Yangjie-SUSTC/Large_FOV_withDM/README.md

# Large_FOV_withDM
## This project used in STROM for large and DM for aberration correctoin. all drawings are in ./factorys.
Large_FOV.sldam whose base board have full holes and all size arew rely on it
Large_FOV.sldam remove no need holes on base board and just assemble check
