Yangjie-SUSTC/Large_FOV_withDM/factory/修改/返厂V1.1/修改说明.txt

所有零件4mm定位销扩孔，按照寄过来的定位销紧密配合

LFOV-DM-5
内孔径扩大到40.2

LFOV-DM-7
图纸错误，重做，后缘突出6mm

LFOV-DM-9
内孔径扩大到51

LFOV-DM-11：
1. 底板边缘切除 
2. 底板边缘螺孔毛刺

LFOV-DM-13
M4螺纹孔打穿

FOV-DM-16：
图纸错误,原先M4通孔扩孔为M6

FOV-DM-20
图纸错误, 原先M4通孔4.5mm 扩孔为M6通孔6.6mm

多出的一个件麻烦将其螺纹改成SM1
