Yangjie-SUSTC/Large_FOV_withDM/factory/南科大20211108/说明.txt

1. 18 号零件：18_2inch_mag_sta_zh 不做
2. 数量与氧化按照图纸说明
3. 定位销孔位置与大小尽量保证精确，零件水平面保证水平
