Yangjie-SUSTC/Large_FOV_withDM/factory/pdf/cover.docx

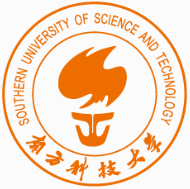
[picture p9: figure]
学校标识- 南方科技大学
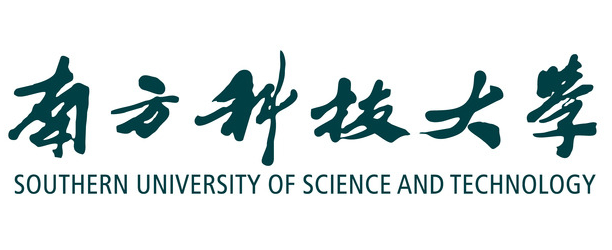
[picture p10: figure]
南方科技大学

LFOV-DM-STORM图纸集

杨杰

yangj3@mail.sustech.edu.cn

https://github.com/Yangjie-SUSTC/Large_FOV_withDM

2021/11/08
