Yangjie-SUSTC/Large_FOV_withDM/assemble/40cm_mir.SLDASM

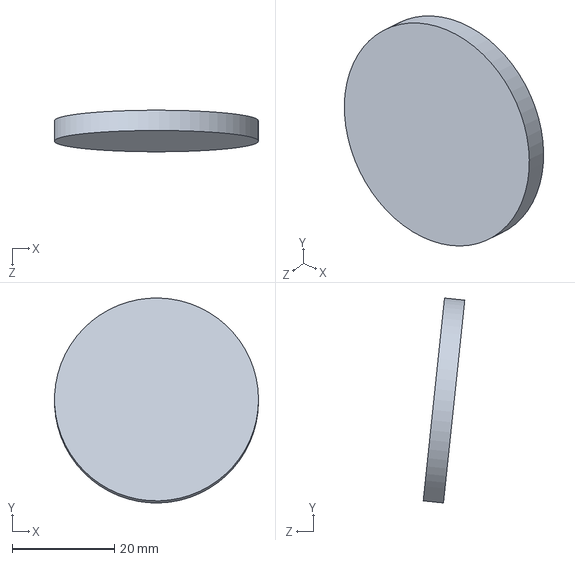
[picture p11: CAD file, 2021-11-23]
assemble/40cm_mir.SLDASM
40.0 x 40.2 x 8.16 mm
