Yangjie-SUSTC/Large_FOV_withDM/commercial/40mir_HVM-s1i.SLDASM

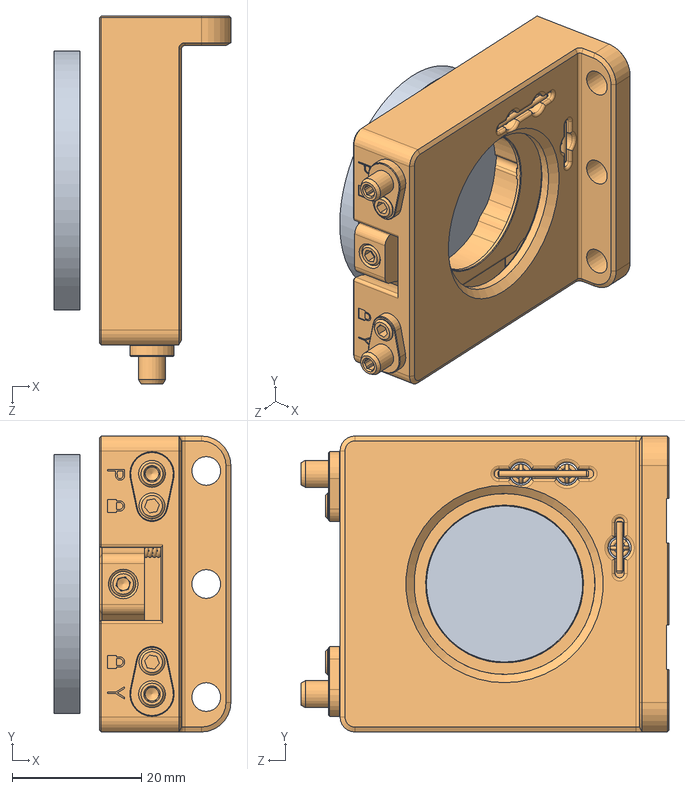
[picture p12: CAD file, 2021-11-23]
commercial/40mir_HVM-s1i.SLDASM
27.3 x 45.7 x 56.8 mm
复件 DHC_GCC-101104^40mir_HVM-s1i
复件 hvm-s1i^40mir_HVM-s1i
