Yangjie-SUSTC/Large_FOV_withDM/assemble/tube_lens_foc.SLDASM

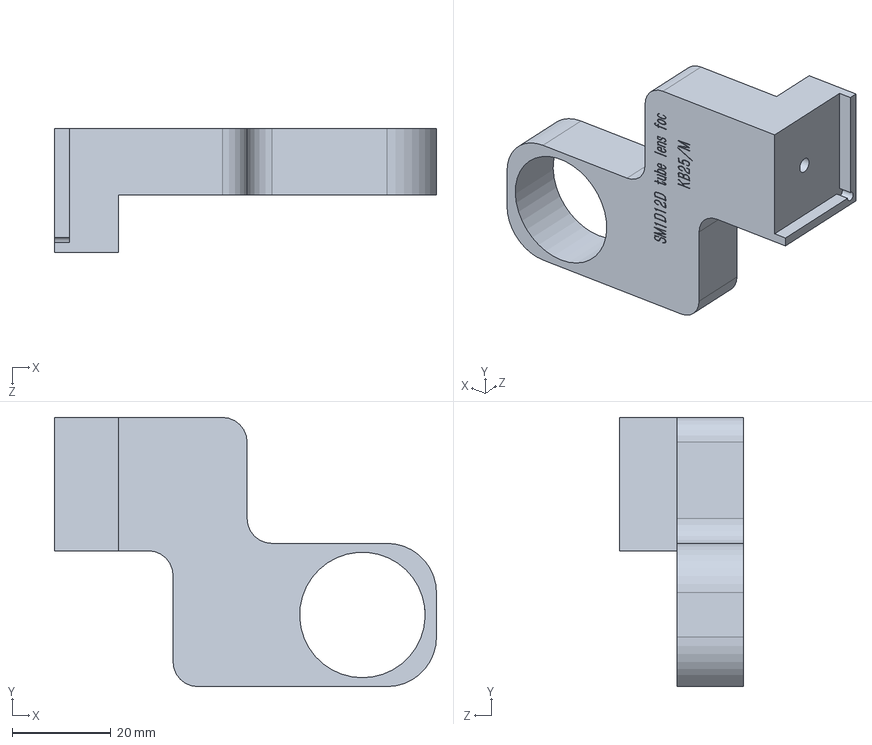
[picture p13: CAD file, 2021-11-11]
assemble/tube_lens_foc.SLDASM
77.3 x 54.5 x 25.1 mm
