Yangjie-SUSTC/Large_FOV_withDM/commercial/cam+carier_cen.SLDASM

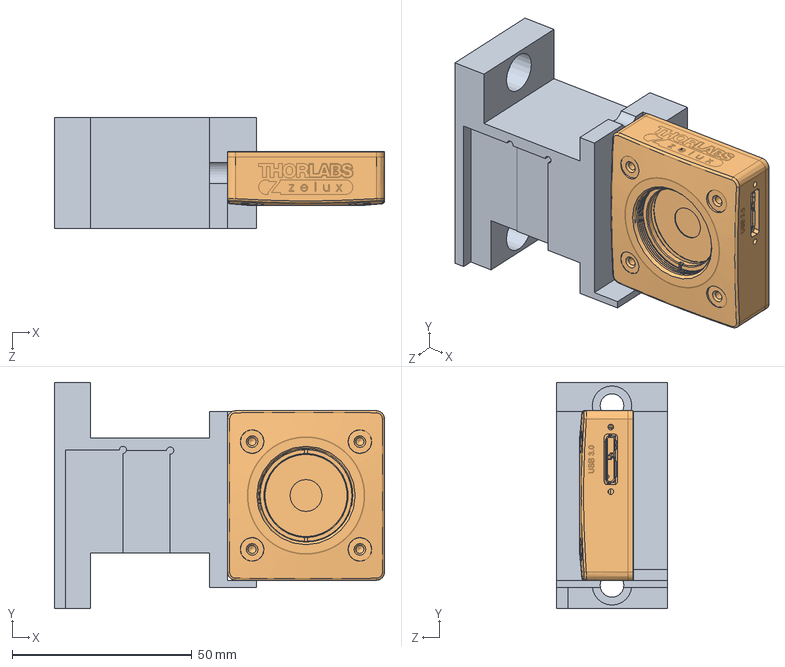
[picture p14: CAD file, 2021-11-11]
commercial/cam+carier_cen.SLDASM
91.8 x 63.0 x 31.0 mm
6-adaptor_cam_cen_fix_rail
CS165MU_M-Solidworks
