Yangjie-SUSTC/Large_FOV_withDM/commercial/cen_rail_carier.SLDASM

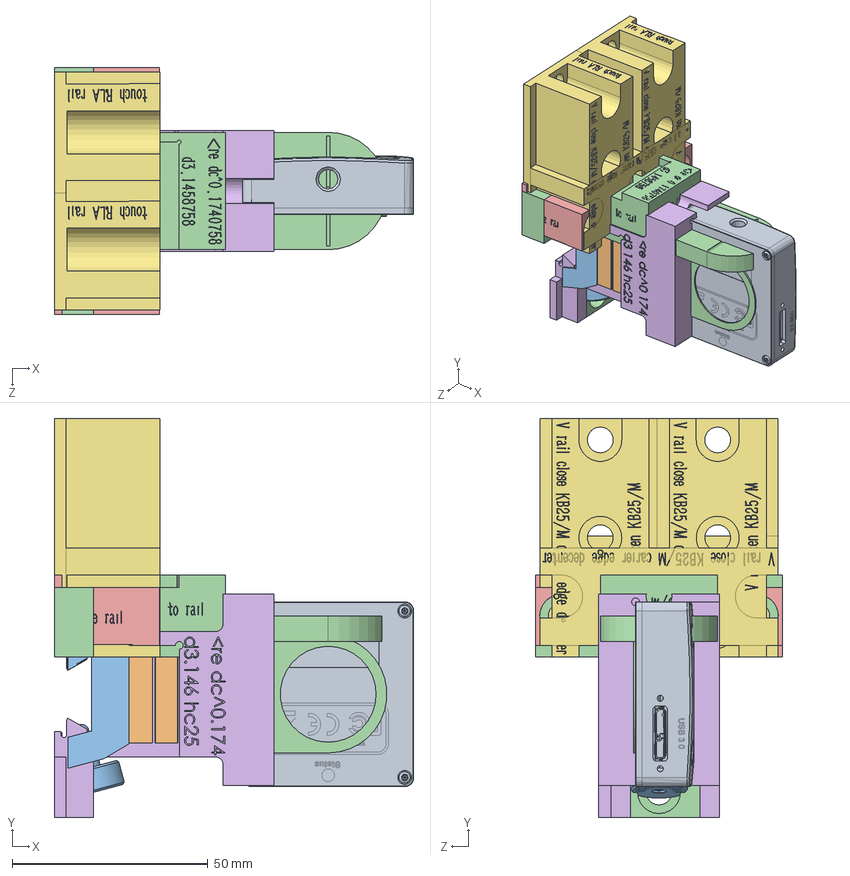
[picture p15: CAD file, 2021-11-11]
commercial/cen_rail_carier.SLDASM
91.8 x 102.0 x 63.0 mm
1-adaptor_fix_pinhole_cen_fix_rail
6-adaptor_cam_cen_fix_rail
CS165MU_M-Solidworks
6-rail_liner x 3
