Yangjie-SUSTC/Large_FOV_withDM/commercial/2inch_f150.SLDASM

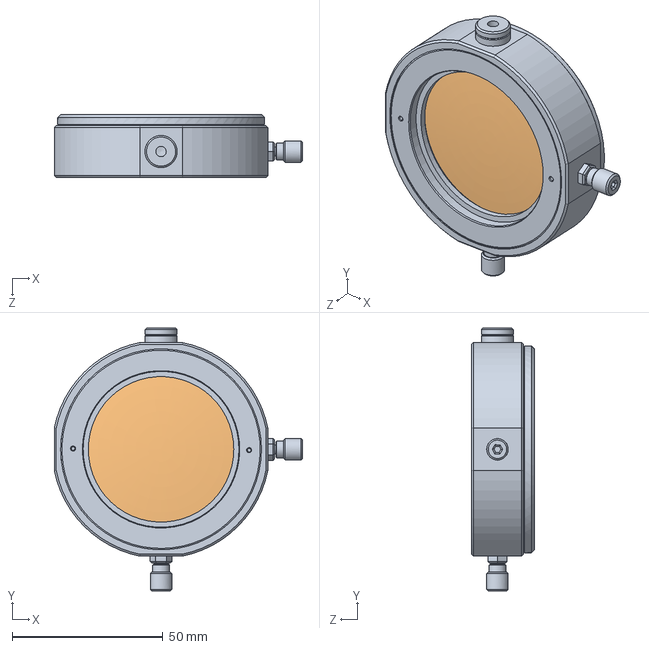
[picture p16: CAD file, 2021-11-11]
commercial/2inch_f150.SLDASM
82.4 x 87.3 x 21.0 mm
复件 LM2XY_M-Solidworks^2inch_f150
复件 AC508-150-A-Solidworks^2inch_f150
