Yangjie-SUSTC/Large_FOV_withDM/commercial/cam+mir+pin_adaptor1.SLDASM

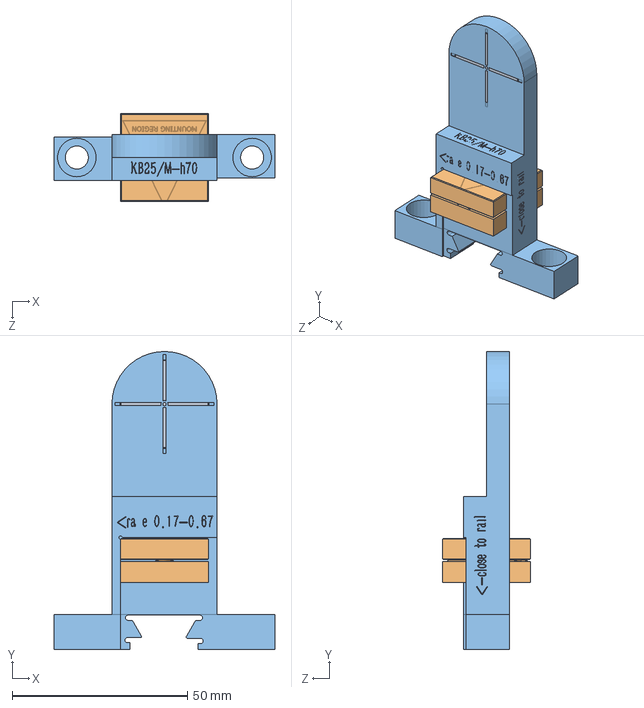
[picture p17: CAD file, 2021-11-11]
commercial/cam+mir+pin_adaptor1.SLDASM
63.0 x 85.0 x 25.0 mm
0_mir_thholasbs_PF10-03-P01
KB25_M-Solidworks
