Yangjie-SUSTC/Large_FOV_withDM/commercial/cam+mir+pin.SLDASM

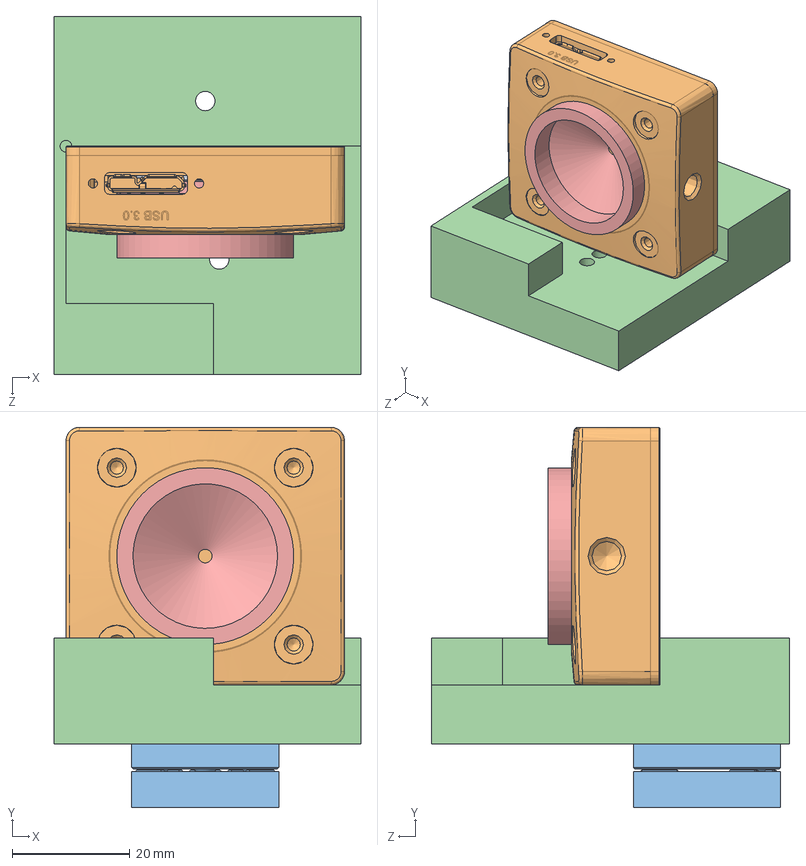
[picture p18: CAD file, 2021-11-11]
commercial/cam+mir+pin.SLDASM
52.0 x 64.5 x 60.7 mm
0_mir_thholasbs_PF10-03-P01
KB25_M-Solidworks
adptor
零件3^cam+mir+pin
