Yangjie-SUSTC/Large_FOV_withDM/commercial/2inch_mag_stage.SLDASM

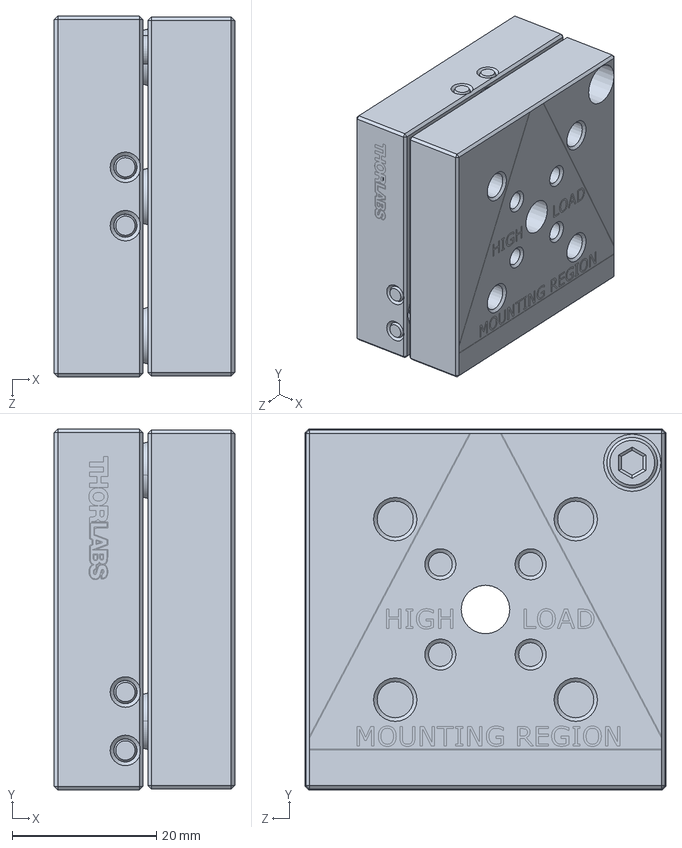
[picture p19: CAD file, 2021-11-11]
commercial/2inch_mag_stage.SLDASM
25.0 x 50.0 x 50.0 mm
