Yangjie-SUSTC/Large_FOV_withDM/commercial/edge_rail_carier.SLDASM

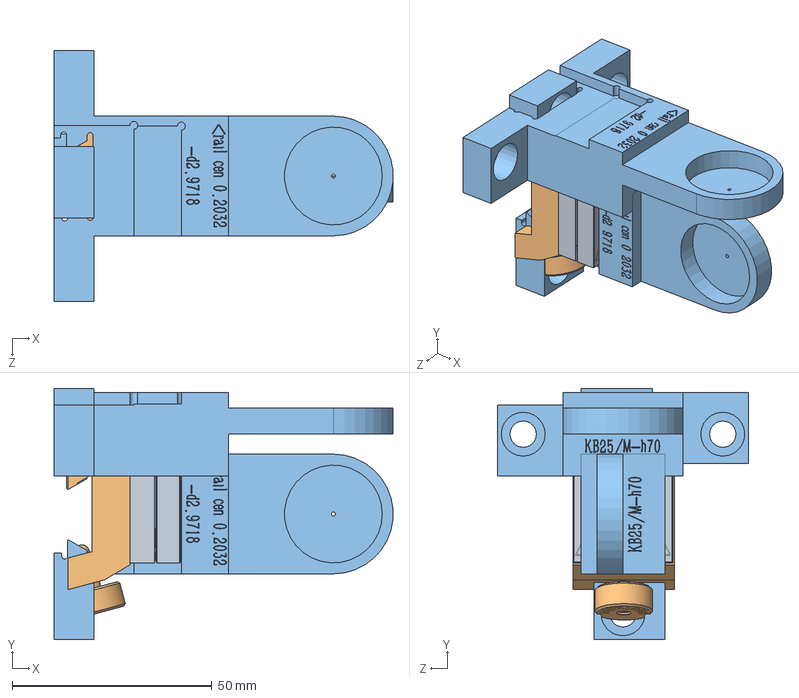
[picture p20: CAD file, 2021-11-11]
commercial/edge_rail_carier.SLDASM
84.9 x 63.0 x 63.0 mm
KB25_M-Solidworks
RC1-Solidworks
1-adaptor_fix_pinhole_cen_fix_rail x 2
