Yangjie-SUSTC/Large_FOV_withDM/custom/1-adaptor_N-BK7_fix_rail.SLDPRT

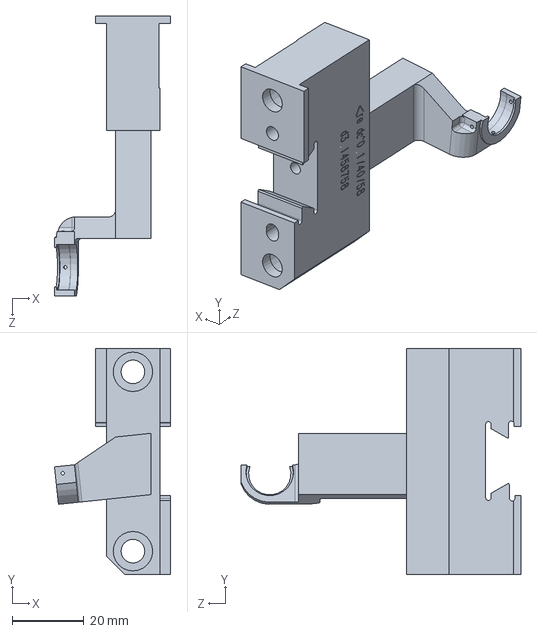
[picture p21: CAD file, 2021-11-11]
custom/1-adaptor_N-BK7_fix_rail.SLDPRT
32.3 x 63.0 x 78.0 mm
