Yangjie-SUSTC/Large_FOV_withDM/factory/15-adaptor_cam_cen_fix.SLDPRT

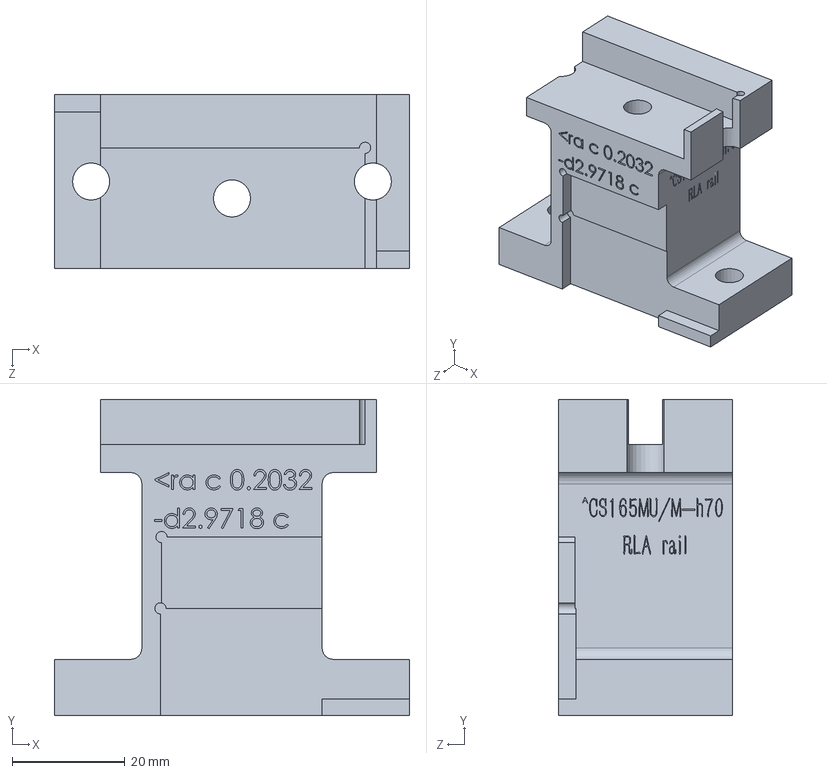
[picture p22: CAD file, 2021-11-11]
factory/15-adaptor_cam_cen_fix.SLDPRT
63.0 x 56.2 x 31.0 mm
