Yangjie-SUSTC/Large_FOV_withDM/factory/step/2_Vbase_2inch.STEP

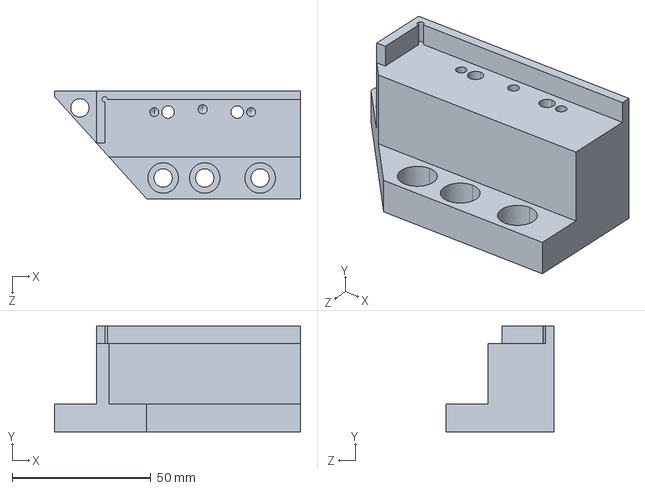
[picture p23: CAD file, 2021-11-11]
factory/step/2_Vbase_2inch.STEP
88.8 x 38.2 x 38.8 mm
