Yangjie-SUSTC/Large_FOV_withDM/factory/step/新建文件夹/7_SM1-40_adp.STEP

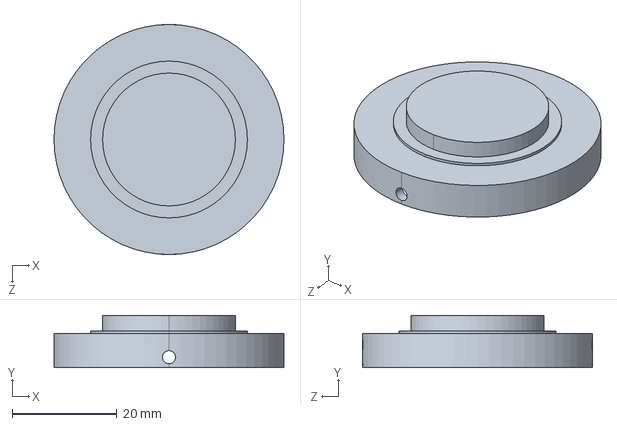
[picture p24: CAD file, 2021-11-11]
factory/step/新建文件夹/7_SM1-40_adp.STEP
44.0 x 10.0 x 44.0 mm
