Yangjie-SUSTC/Large_FOV_withDM/factory/修改/返厂V1.1/7_SM1-40_adp.STEP

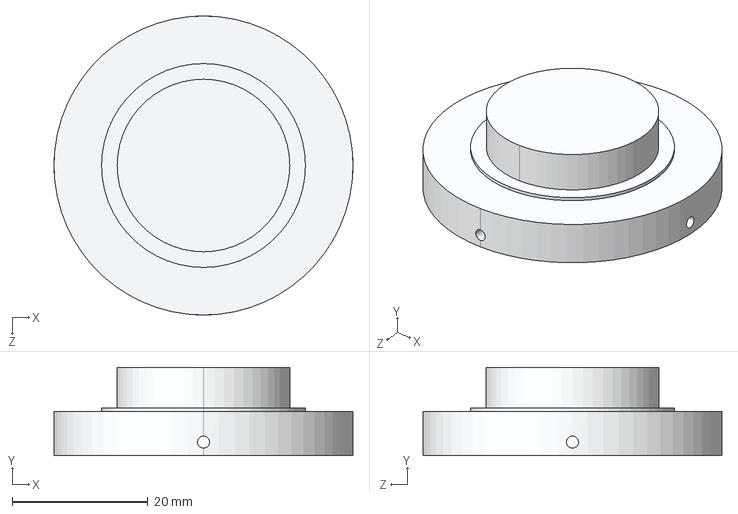
[picture p25: CAD file, 2021-11-23]
factory/修改/返厂V1.1/7_SM1-40_adp.STEP
44.0 x 13.0 x 44.0 mm
