Yangjie-SUSTC/Large_FOV_withDM/factory/南科大20211108/step/12_adaptor_pil_dec_tab.STEP

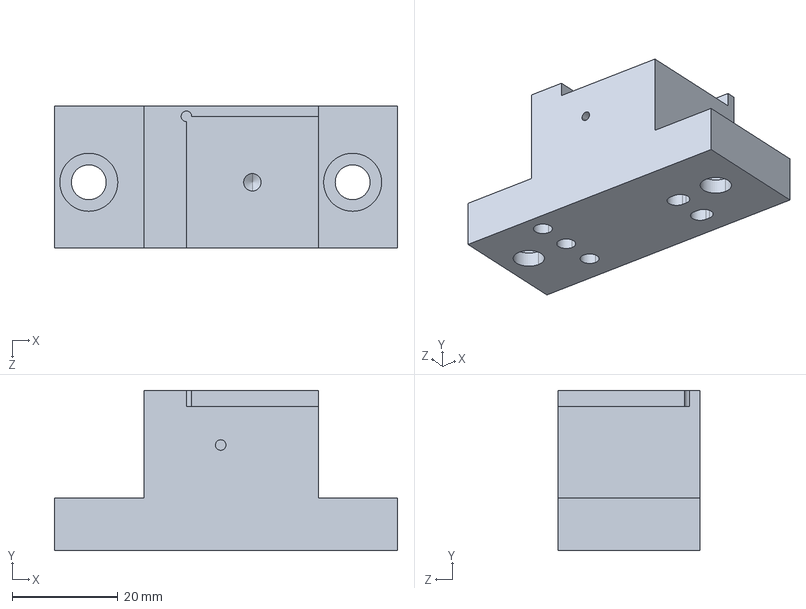
[picture p26: CAD file, 2021-11-11]
factory/南科大20211108/step/12_adaptor_pil_dec_tab.STEP
65.0 x 30.3 x 27.0 mm
