Yangjie-SUSTC/Large_FOV_withDM/ref/AVO8/storm-system-v7_all.SLDPRT

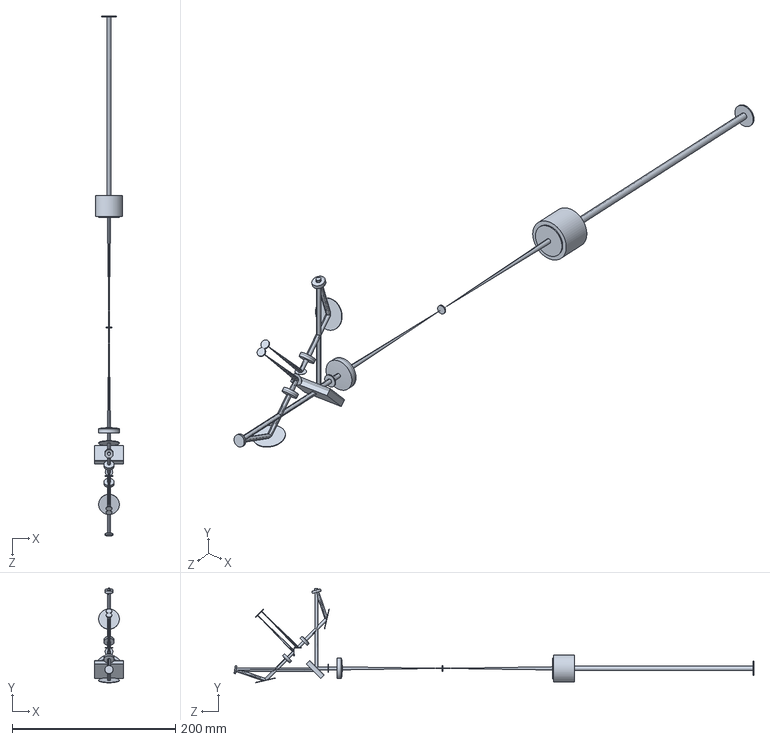
[picture p27: CAD file, 2021-11-11]
ref/AVO8/storm-system-v7_all.SLDPRT
36.0 x 116.1 x 637.9 mm
