Yangjie-SUSTC/Large_FOV_withDM/ref/light_path/f150_focus.STP

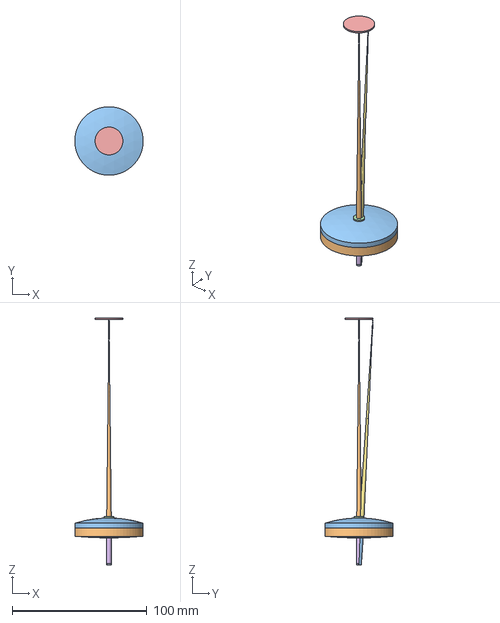
[picture p28: CAD file, 2021-11-11]
ref/light_path/f150_focus.STP
50.8 x 50.8 x 183.4 mm
