Yangjie-SUSTC/Large_FOV_withDM/ref/rail_base_ref.SLDPRT

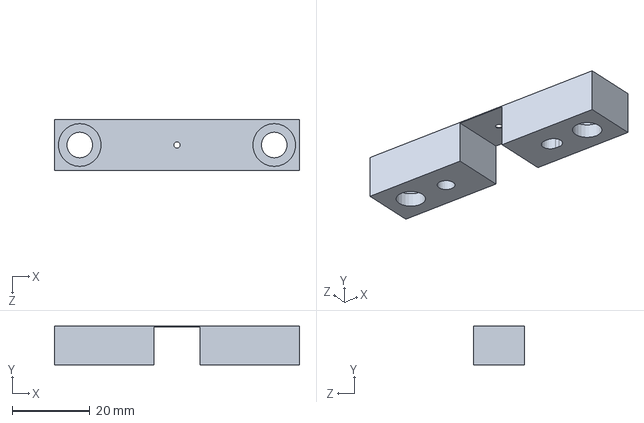
[picture p29: CAD file, 2021-11-11]
ref/rail_base_ref.SLDPRT
63.0 x 10.0 x 13.0 mm
