Yangjie-SUSTC/Large_FOV_withDM/factory/19_rail_liner.SLDPRT

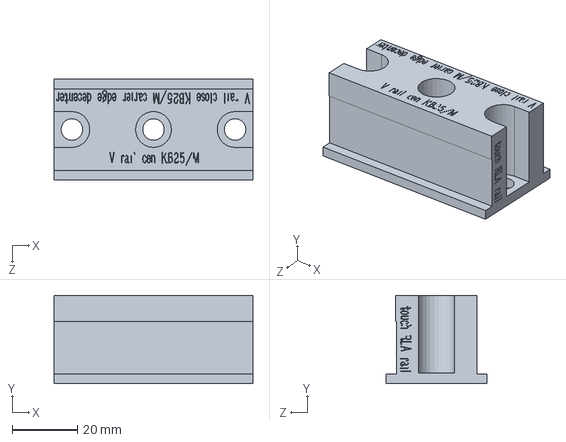
[picture p30: CAD file, 2021-11-11]
factory/19_rail_liner.SLDPRT
61.0 x 27.0 x 31.0 mm
