Yangjie-SUSTC/Large_FOV_withDM/factory/step/20_adaptor_cam_rail.STEP

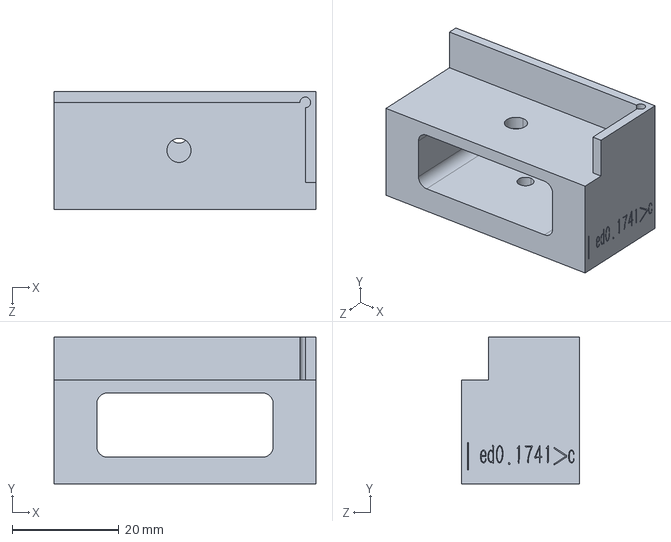
[picture p31: CAD file, 2021-11-11]
factory/step/20_adaptor_cam_rail.STEP
49.0 x 27.4 x 22.0 mm
