Yangjie-SUSTC/Large_FOV_withDM/factory/step/新建文件夹/8_DM_sta.STEP

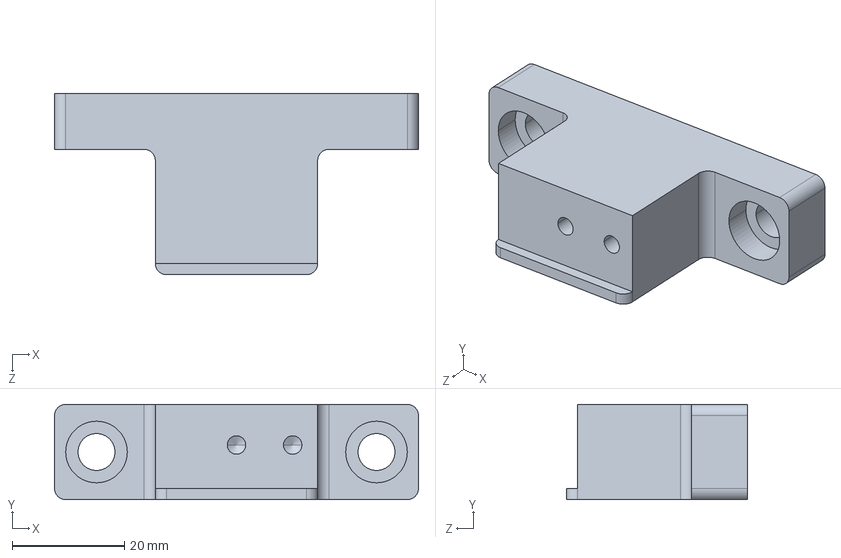
[picture p32: CAD file, 2021-11-11]
factory/step/新建文件夹/8_DM_sta.STEP
65.0 x 17.0 x 32.4 mm
