Yangjie-SUSTC/Large_FOV_withDM/factory/修改/返厂V1.1/11_baseBoard.STEP

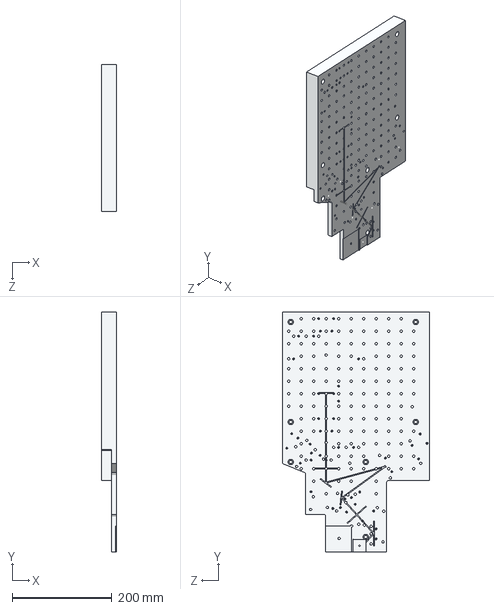
[picture p33: CAD file, 2021-11-23]
factory/修改/返厂V1.1/11_baseBoard.STEP
30.0 x 480.0 x 295.0 mm
