Yangjie-SUSTC/Large_FOV_withDM/factory/南科大20211108/step/6_40cm_mir_back.STEP

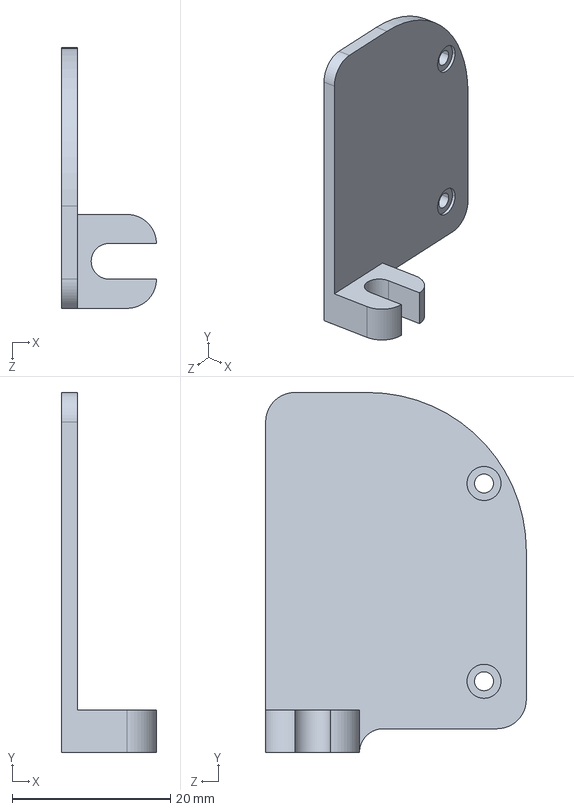
[picture p34: CAD file, 2021-11-11]
factory/南科大20211108/step/6_40cm_mir_back.STEP
12.0 x 45.5 x 32.9 mm
