Yangjie-SUSTC/Large_FOV_withDM/factory/新建文件夹/3_f150_sta - 副本.SLDPRT

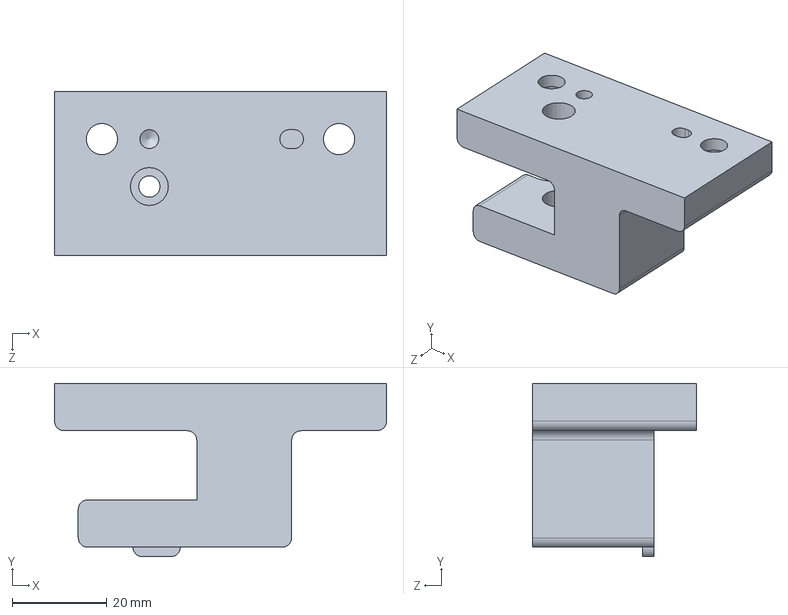
[picture p35: CAD file, 2021-11-11]
factory/新建文件夹/3_f150_sta - 副本.SLDPRT
70.0 x 36.6 x 34.5 mm
