Yangjie-SUSTC/Large_FOV_withDM/ref/stage_base_ref.SLDPRT

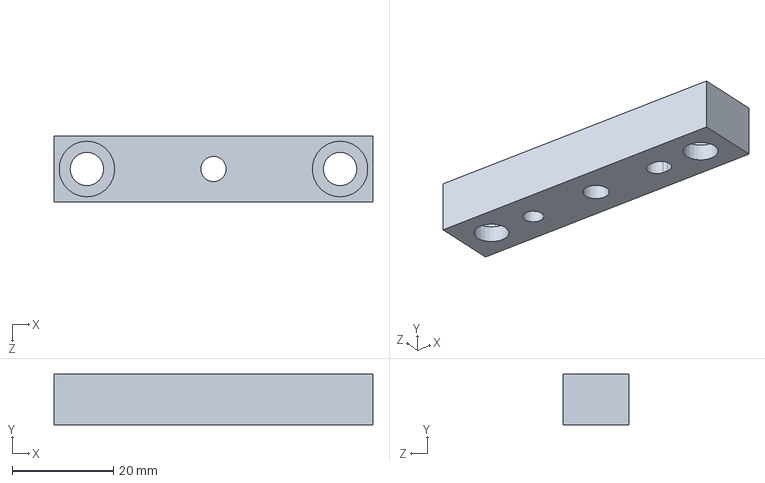
[picture p36: CAD file, 2021-11-11]
ref/stage_base_ref.SLDPRT
63.0 x 10.0 x 13.0 mm
