Yangjie-SUSTC/Large_FOV_withDM/commercial/KB25_M-Solidworks.sldprt

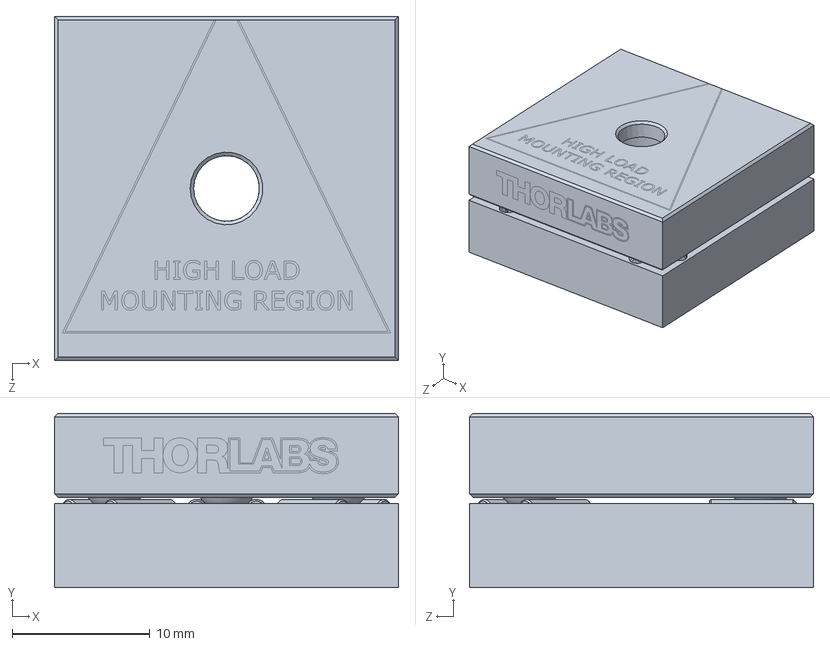
[picture p37: CAD file, 2021-11-11]
commercial/KB25_M-Solidworks.sldprt
25.0 x 12.7 x 25.0 mm
