Yangjie-SUSTC/Large_FOV_withDM/factory/14_fix_ph_h70.SLDPRT

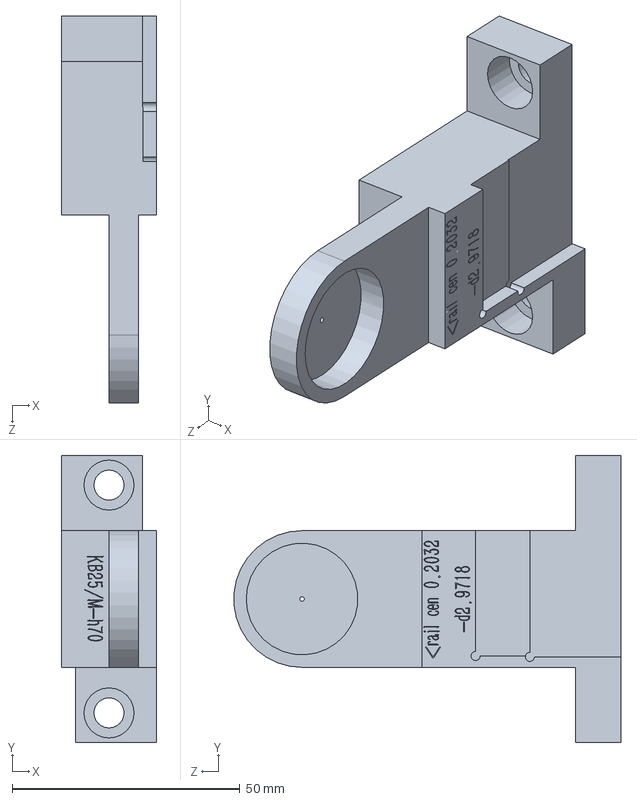
[picture p38: CAD file, 2021-11-11]
factory/14_fix_ph_h70.SLDPRT
21.0 x 63.0 x 84.9 mm
