Yangjie-SUSTC/Large_FOV_withDM/factory/step/1_2inch_mag_stage.STEP

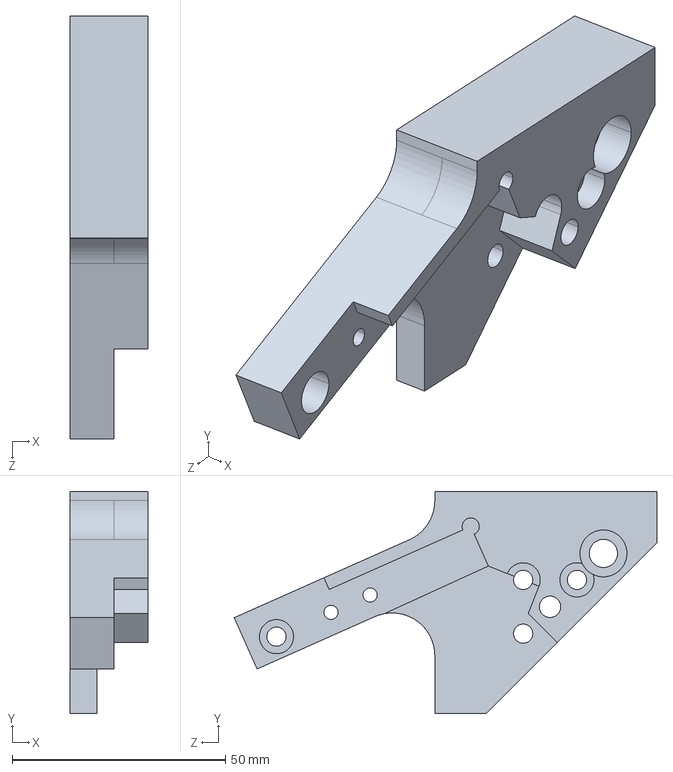
[picture p39: CAD file, 2021-11-11]
factory/step/1_2inch_mag_stage.STEP
18.4 x 52.0 x 99.0 mm
