Yangjie-SUSTC/Large_FOV_withDM/factory/step/新建文件夹/13_DM_fix.STEP

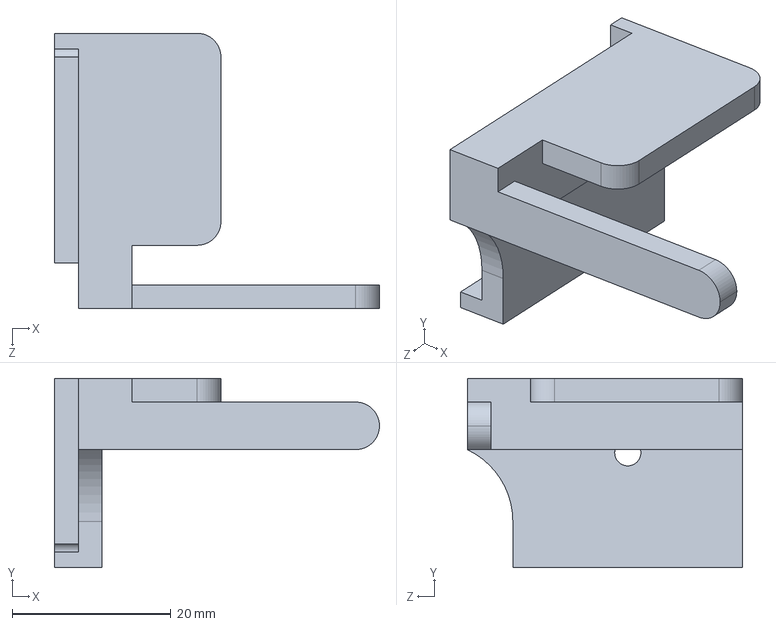
[picture p40: CAD file, 2021-11-11]
factory/step/新建文件夹/13_DM_fix.STEP
41.0 x 23.9 x 34.7 mm
