Yangjie-SUSTC/Large_FOV_withDM/factory/新建文件夹/11_baseBoard - 副本.SLDPRT

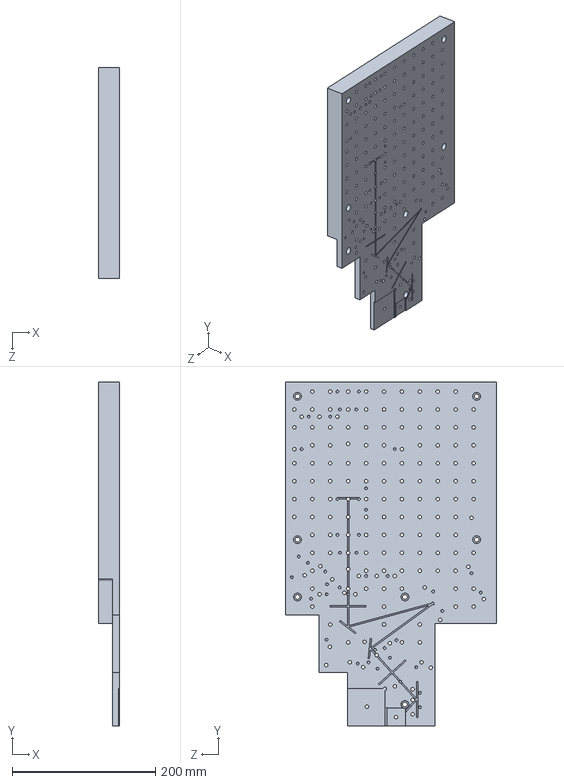
[picture p41: CAD file, 2021-11-11]
factory/新建文件夹/11_baseBoard - 副本.SLDPRT
30.0 x 480.0 x 295.0 mm
