Yangjie-SUSTC/Large_FOV_withDM/commercial/0_mir_thholasbs_PF10-03-P01.SLDPRT

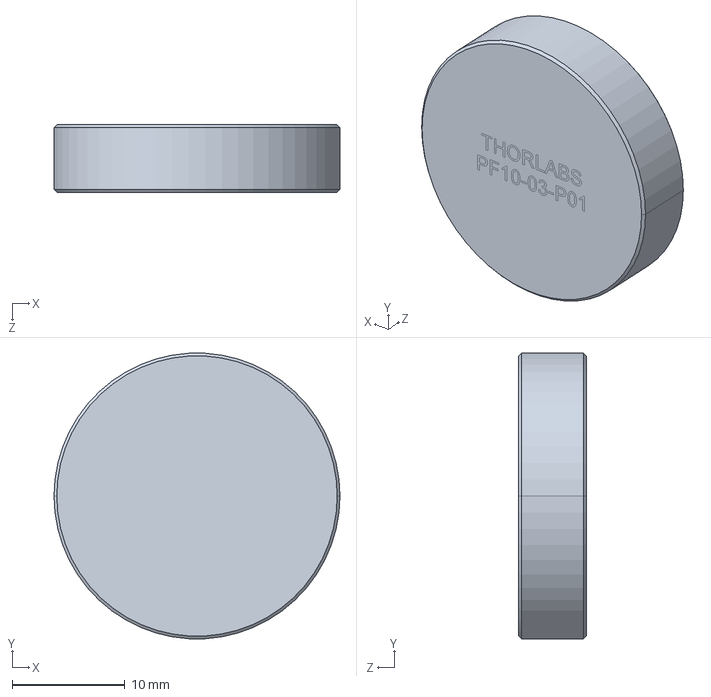
[picture p42: CAD file, 2021-11-11]
commercial/0_mir_thholasbs_PF10-03-P01.SLDPRT
25.4 x 25.4 x 6.00 mm
