Yangjie-SUSTC/Large_FOV_withDM/custom/17-adaptor_mir_dec.SLDPRT

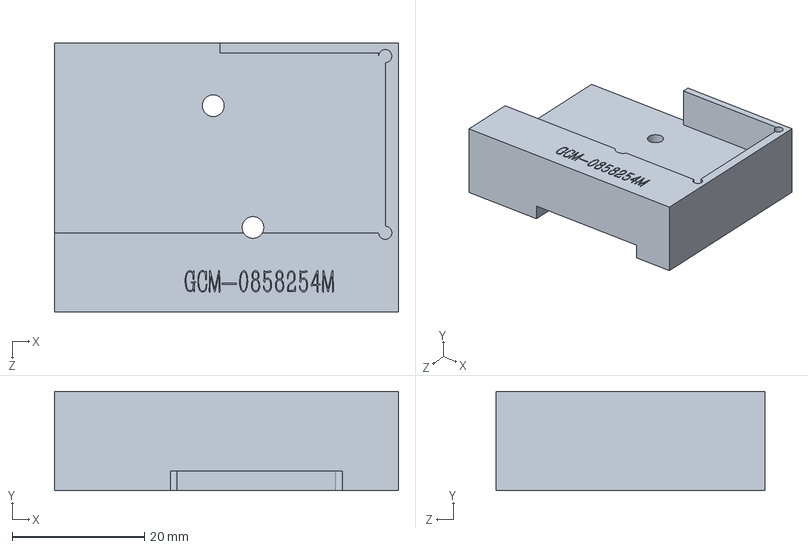
[picture p43: CAD file, 2021-11-11]
custom/17-adaptor_mir_dec.SLDPRT
52.0 x 15.0 x 40.7 mm
