Yangjie-SUSTC/Large_FOV_withDM/factory/step/16_adp_cam_dec.STEP

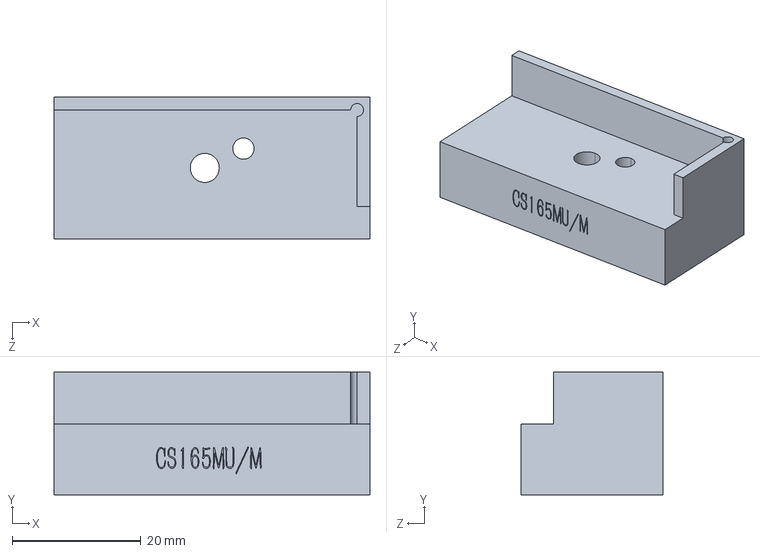
[picture p44: CAD file, 2021-11-11]
factory/step/16_adp_cam_dec.STEP
49.0 x 19.0 x 22.0 mm
