Yangjie-SUSTC/Large_FOV_withDM/factory/step/新建文件夹/4_Vbase_1inch.STEP

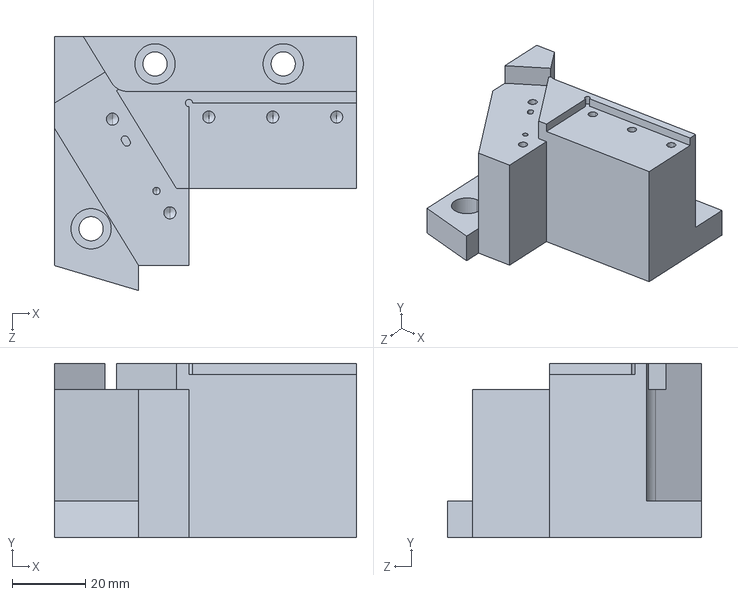
[picture p45: CAD file, 2021-11-11]
factory/step/新建文件夹/4_Vbase_1inch.STEP
82.4 x 47.6 x 69.4 mm
