Yangjie-SUSTC/Large_FOV_withDM/commercial/CS165MU_M-Solidworks.sldprt

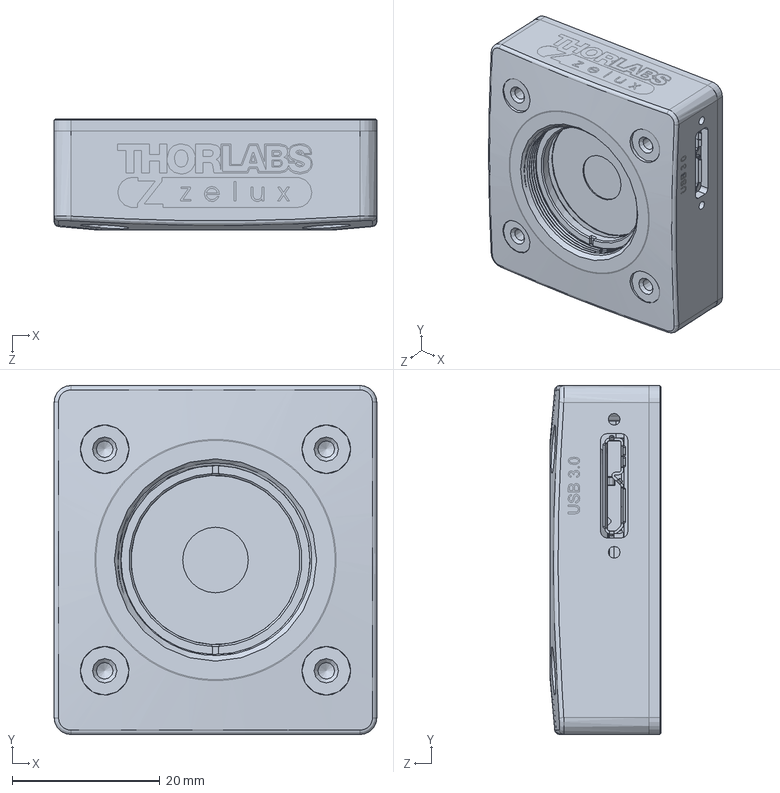
[picture p46: CAD file, 2021-11-11]
commercial/CS165MU_M-Solidworks.sldprt
43.7 x 47.2 x 15.0 mm
