Yangjie-SUSTC/Large_FOV_withDM/custom/3-adaptor_pinhole_cen_fix.SLDPRT

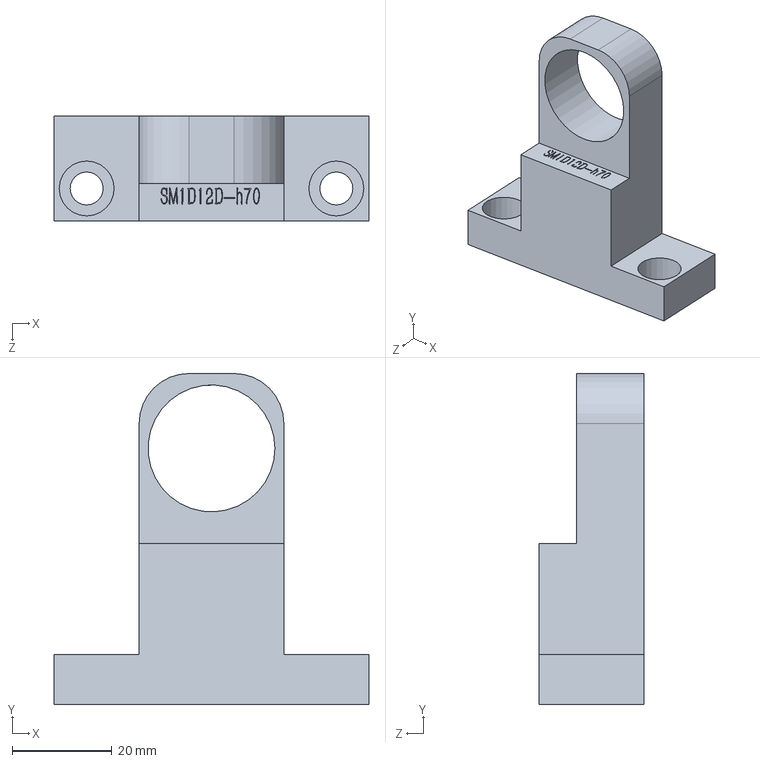
[picture p47: CAD file, 2021-11-11]
custom/3-adaptor_pinhole_cen_fix.SLDPRT
63.0 x 66.3 x 21.0 mm
