Yangjie-SUSTC/Large_FOV_withDM/factory/step/9_DM_adp.STEP

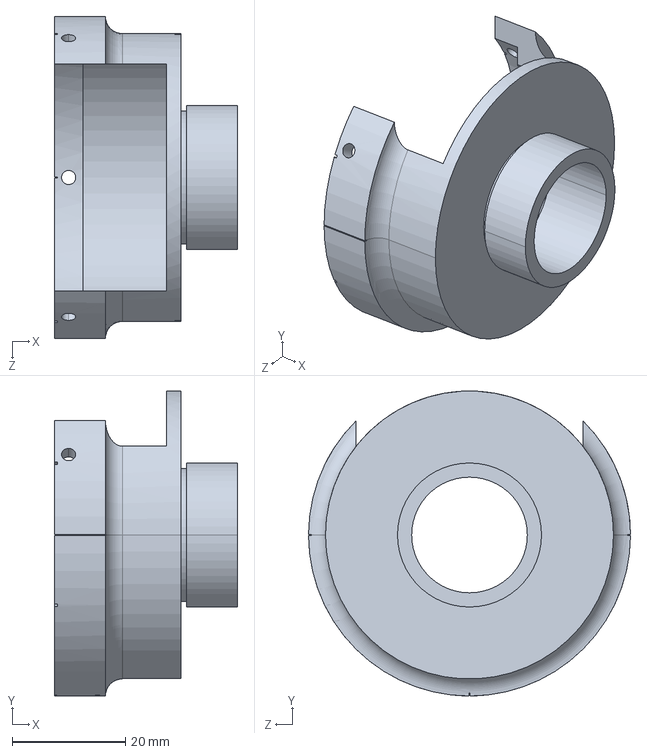
[picture p48: CAD file, 2021-11-11]
factory/step/9_DM_adp.STEP
32.3 x 53.8 x 56.8 mm
