Yangjie-SUSTC/Large_FOV_withDM/factory/step/新建文件夹/17_adp_TL_phfoc.STEP

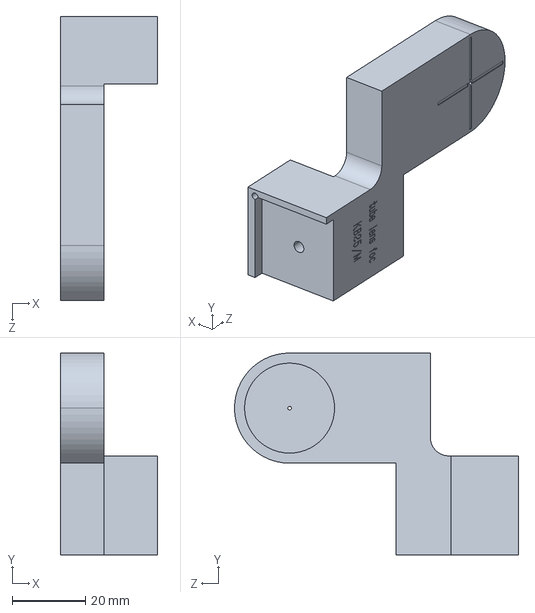
[picture p49: CAD file, 2021-11-11]
factory/step/新建文件夹/17_adp_TL_phfoc.STEP
26.5 x 55.0 x 77.3 mm
