Yangjie-SUSTC/Large_FOV_withDM/commercial/OW11-A.SLDPRT

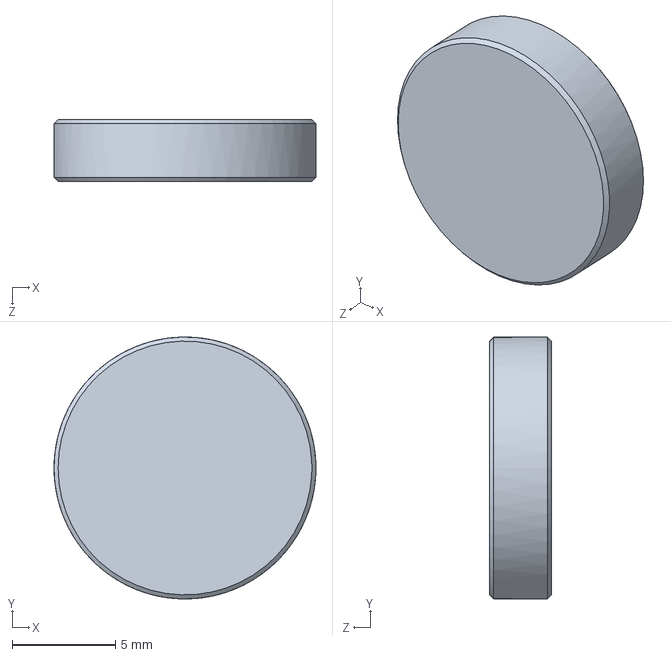
[picture p50: CAD file, 2021-11-11]
commercial/OW11-A.SLDPRT
12.7 x 12.7 x 3.00 mm
