Yangjie-SUSTC/Large_FOV_withDM/factory/step/新建文件夹/18_2inch_mag_sta_zh.STEP

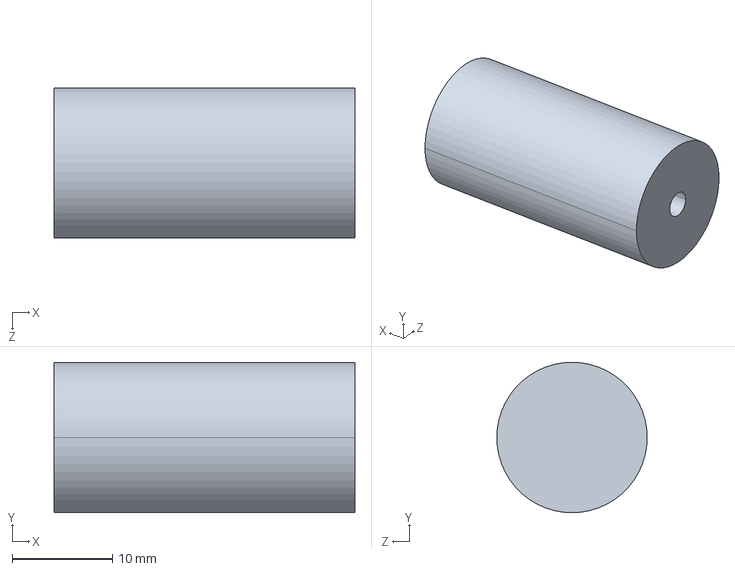
[picture p51: CAD file, 2021-11-11]
factory/step/新建文件夹/18_2inch_mag_sta_zh.STEP
30.0 x 15.0 x 15.0 mm
