Yangjie-SUSTC/Large_FOV_withDM/custom/5-adaptor_mir_cen_fix_rail.SLDPRT

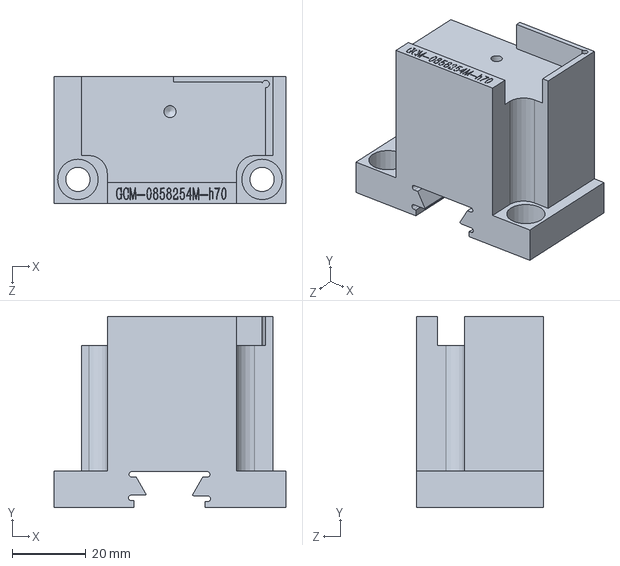
[picture p52: CAD file, 2021-11-11]
custom/5-adaptor_mir_cen_fix_rail.SLDPRT
63.0 x 52.0 x 34.4 mm
