Yangjie-SUSTC/Large_FOV_withDM/commercial/GCM-0858254M 外型图.STEP

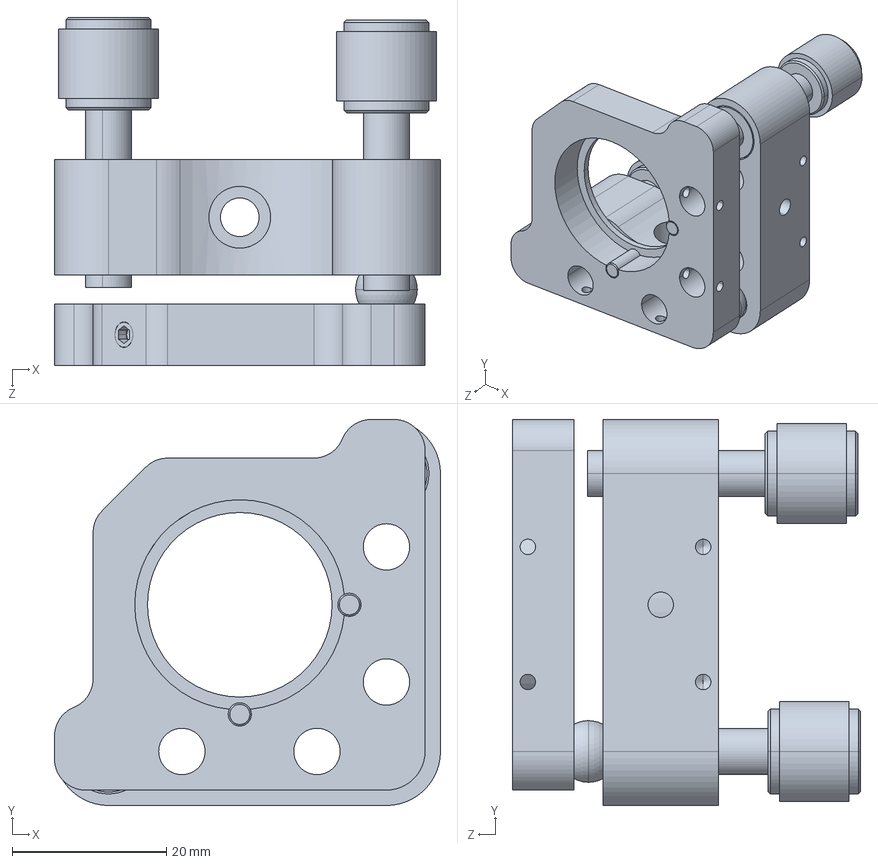
[picture p53: CAD file, 2021-11-11]
commercial/GCM-0858254M 外型图.STEP
50.0 x 50.0 x 45.1 mm
