Yangjie-SUSTC/Large_FOV_withDM/custom/13-fix_pinhole_dec.SLDPRT

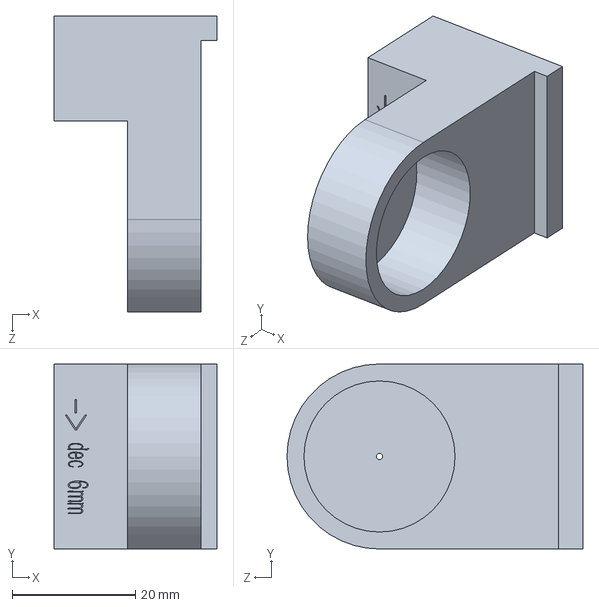
[picture p54: CAD file, 2021-11-11]
custom/13-fix_pinhole_dec.SLDPRT
26.4 x 30.0 x 48.0 mm
