Yangjie-SUSTC/Large_FOV_withDM/factory/step/新建文件夹/10_pho_cam_hol.STEP

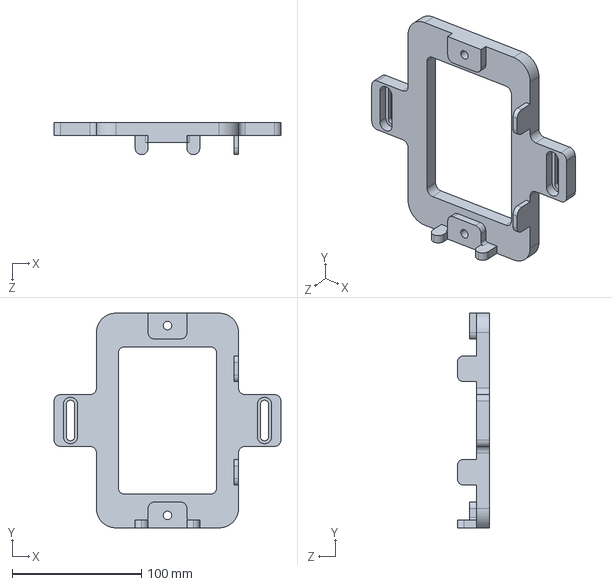
[picture p55: CAD file, 2021-11-11]
factory/step/新建文件夹/10_pho_cam_hol.STEP
175.5 x 166.0 x 25.0 mm
