Yangjie-SUSTC/Large_FOV_withDM/factory/南科大20211108/step/18_2inch_mag_sta_zh.STEP

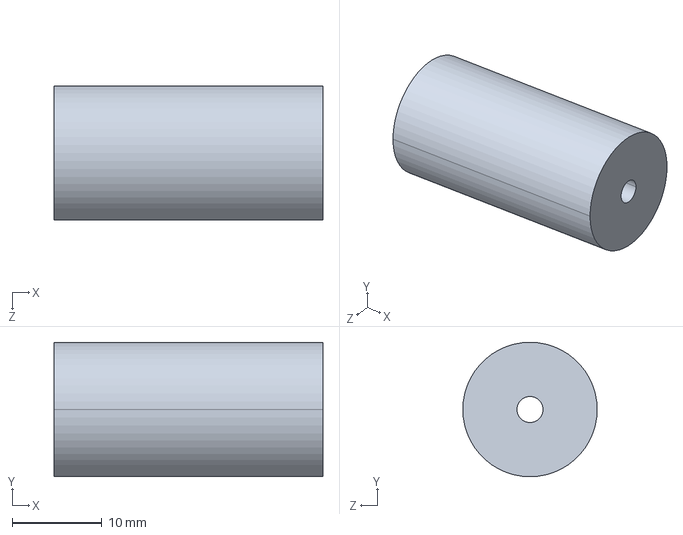
[picture p56: CAD file, 2021-11-11]
factory/南科大20211108/step/18_2inch_mag_sta_zh.STEP
30.0 x 15.0 x 15.0 mm
