Yangjie-SUSTC/Large_FOV_withDM/custom/9-adaptor_pinhole_rail.SLDPRT

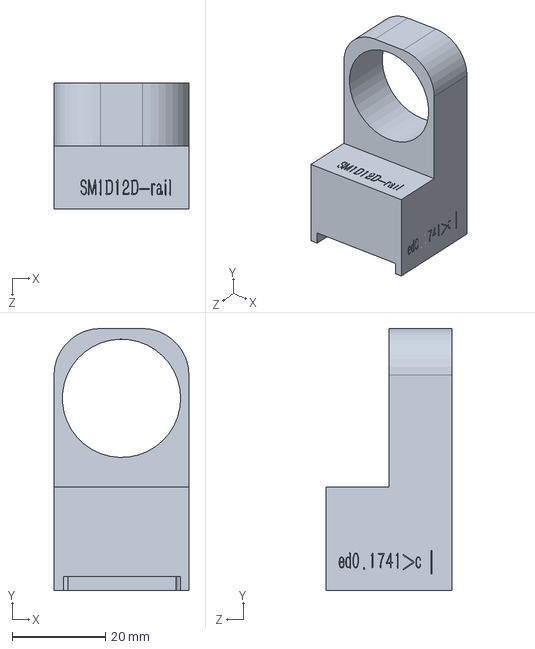
[picture p57: CAD file, 2021-11-11]
custom/9-adaptor_pinhole_rail.SLDPRT
29.0 x 56.3 x 27.0 mm
