Yangjie-SUSTC/Large_FOV_withDM/factory/step/新建文件夹/11_baseBoard.STEP

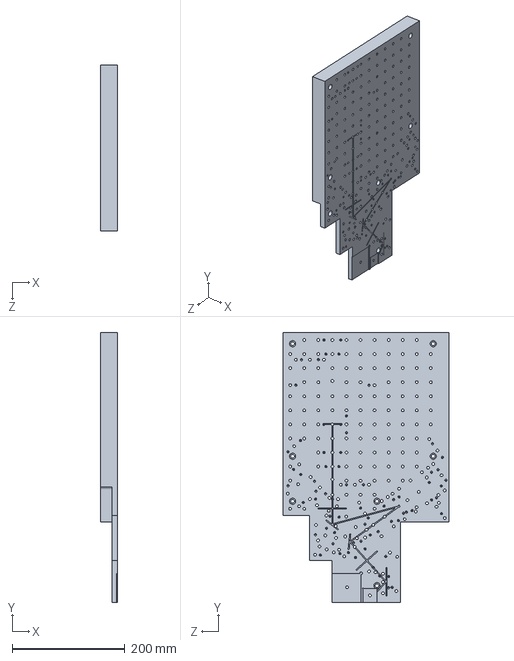
[picture p59: CAD file, 2021-11-11]
factory/step/新建文件夹/11_baseBoard.STEP
30.0 x 480.0 x 295.0 mm
