Yangjie-SUSTC/Large_FOV_withDM/commercial/VRC2SM1-Solidworks.sldprt

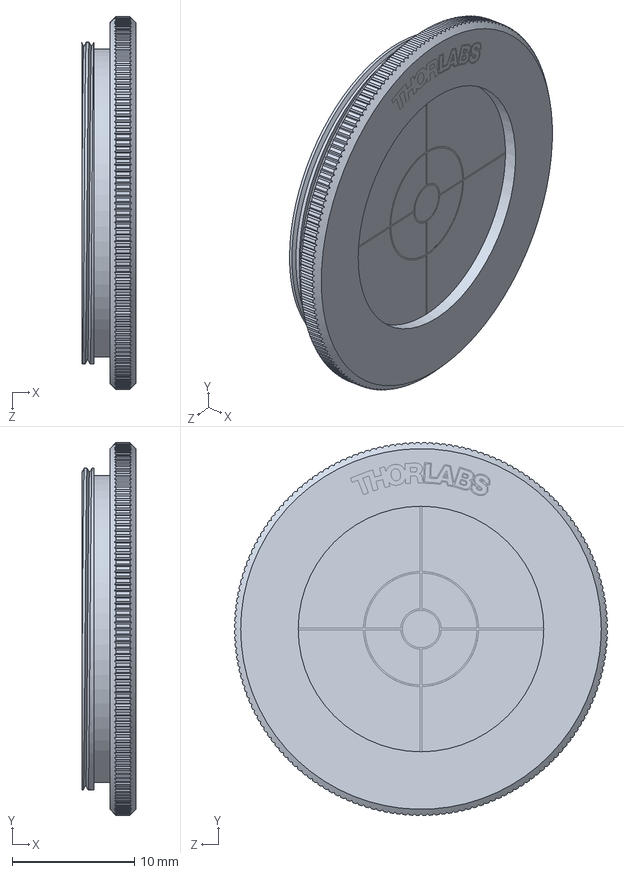
[picture p60: CAD file, 2021-11-11]
commercial/VRC2SM1-Solidworks.sldprt
4.45 x 30.5 x 30.5 mm
