Yangjie-SUSTC/Large_FOV_withDM/custom/1-adaptor_N-BK7_fix_rai1l.SLDPRT

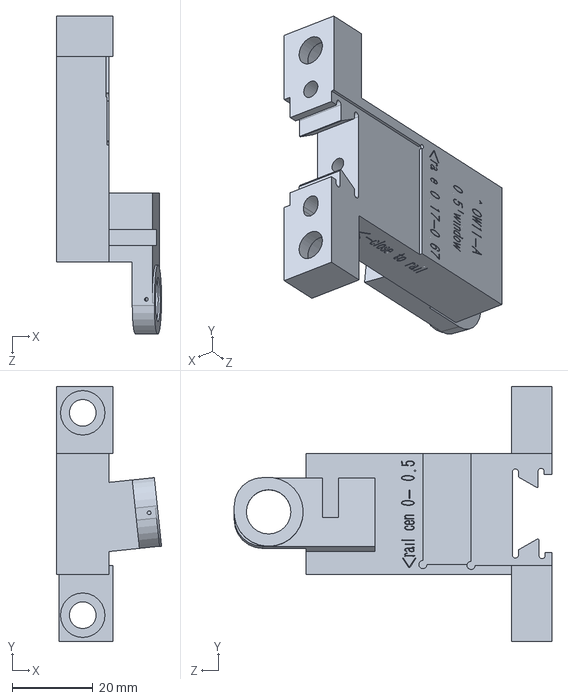
[picture p61: CAD file, 2021-11-11]
custom/1-adaptor_N-BK7_fix_rai1l.SLDPRT
26.0 x 63.0 x 78.6 mm
