Yangjie-SUSTC/Large_FOV_withDM/commercial/RLA300_M-Solidworks.sldprt

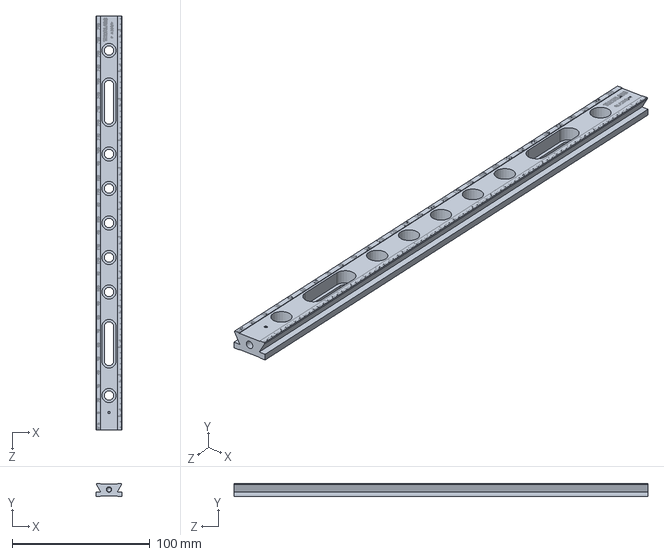
[picture p62: CAD file, 2021-11-11]
commercial/RLA300_M-Solidworks.sldprt
19.1 x 9.53 x 300.0 mm
