Yangjie-SUSTC/Large_FOV_withDM/custom/14-adaptor_fix_pin_tube_dec.SLDPRT

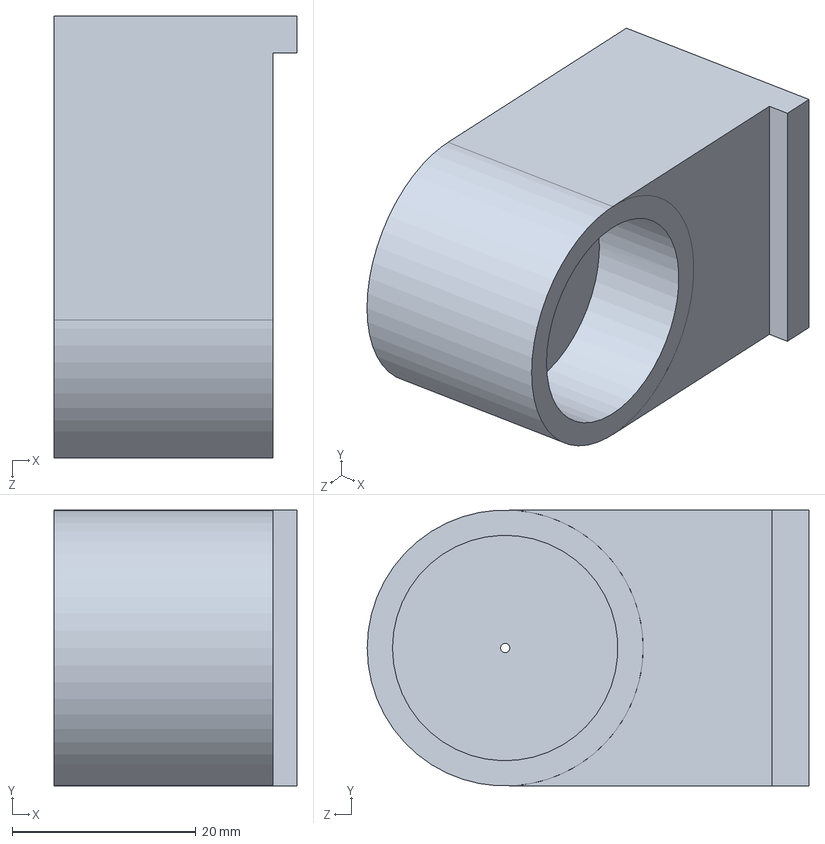
[picture p63: CAD file, 2021-11-11]
custom/14-adaptor_fix_pin_tube_dec.SLDPRT
26.4 x 30.0 x 48.0 mm
