Yangjie-SUSTC/Large_FOV_withDM/commercial/RC1-Solidworks.sldprt

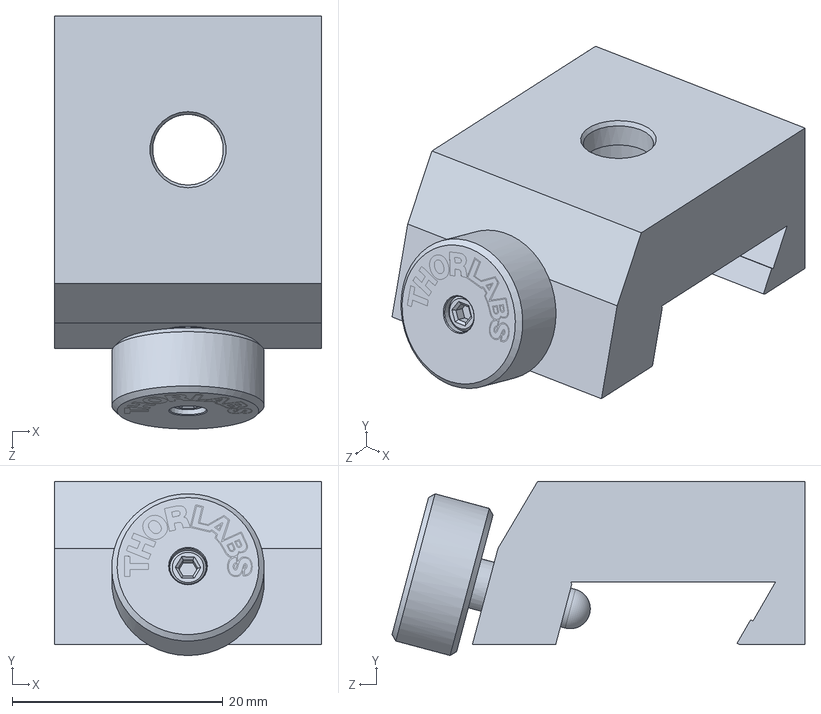
[picture p64: CAD file, 2021-11-11]
commercial/RC1-Solidworks.sldprt
25.4 x 16.5 x 39.2 mm
