Yangjie-SUSTC/Large_FOV_withDM/commercial/SM1L10-Solidworks.sldprt

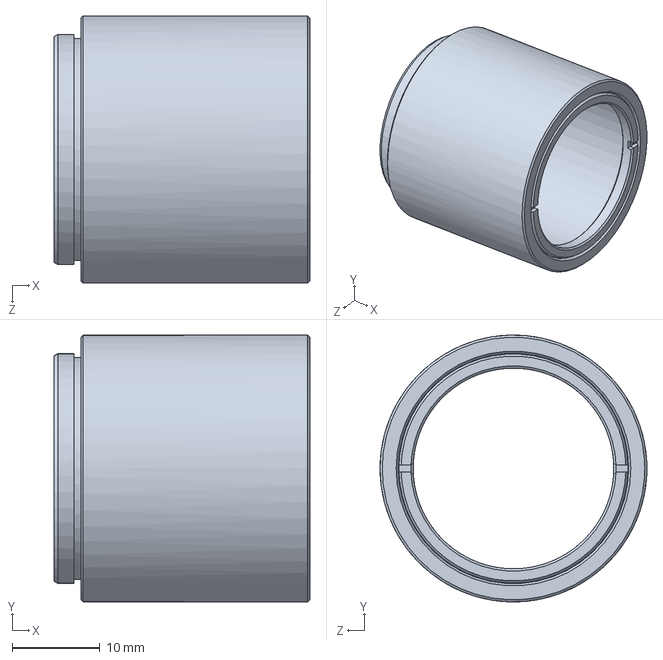
[picture p65: CAD file, 2021-11-11]
commercial/SM1L10-Solidworks.sldprt
29.2 x 30.5 x 30.5 mm
