Yangjie-SUSTC/Large_FOV_withDM/custom/1_DL2_sup.SLDPRT

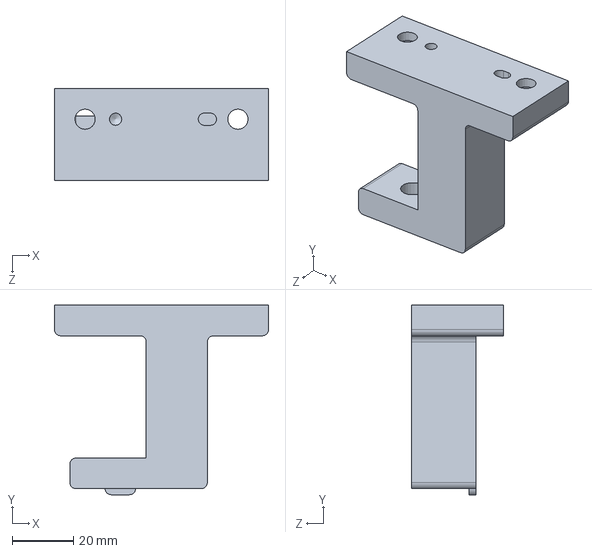
[picture p66: CAD file, 2021-11-11]
custom/1_DL2_sup.SLDPRT
70.0 x 62.0 x 30.0 mm
