Yangjie-SUSTC/Large_FOV_withDM/factory/step/3_f150_sta.STEP

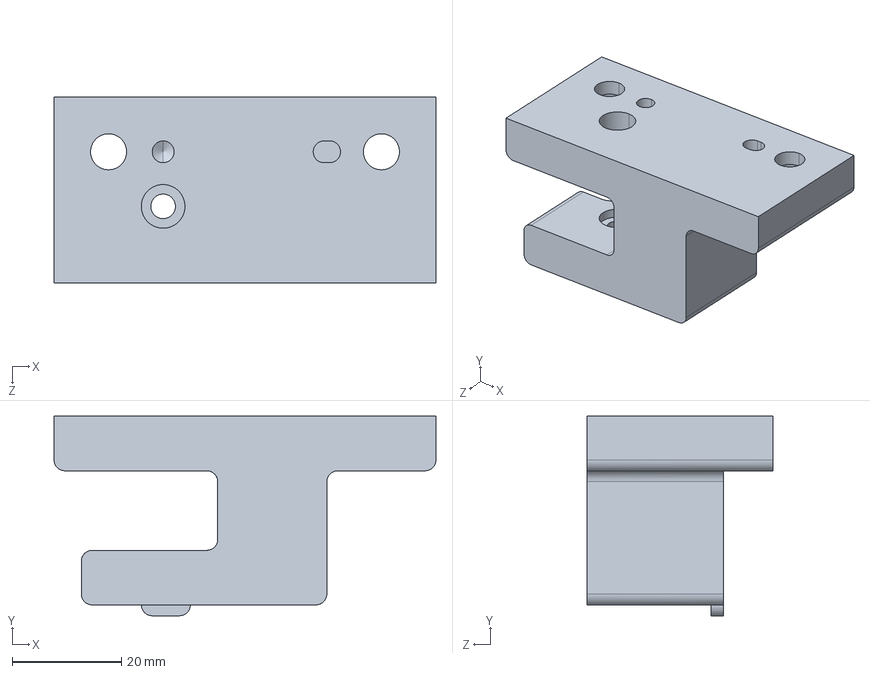
[picture p67: CAD file, 2021-11-11]
factory/step/3_f150_sta.STEP
70.0 x 36.6 x 34.0 mm
