Yangjie-SUSTC/Large_FOV_withDM/factory/step/5_40mir_front.STEP

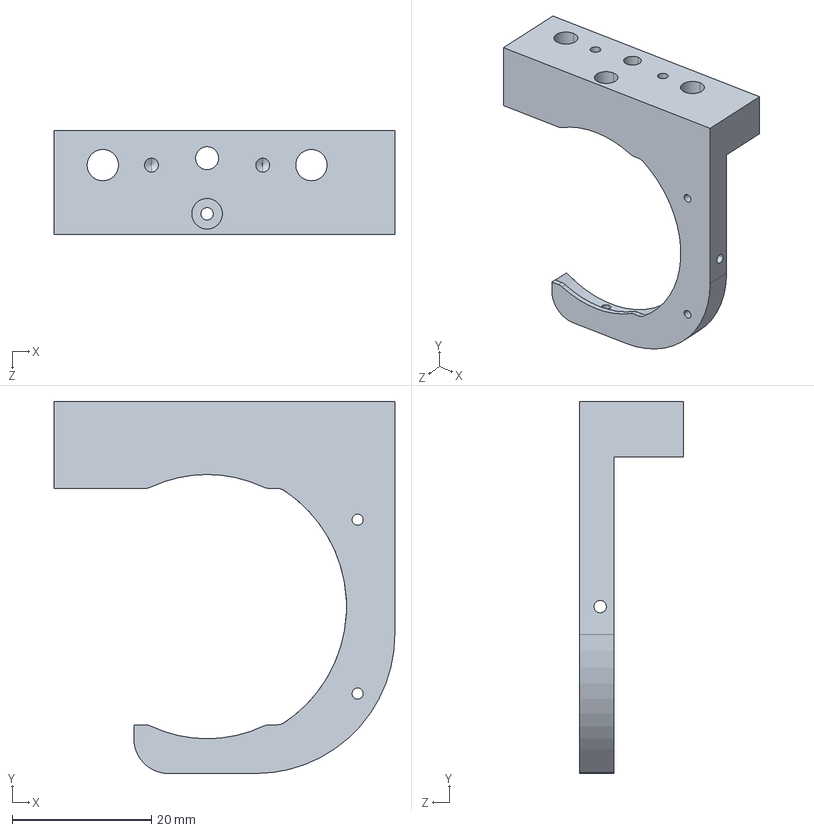
[picture p68: CAD file, 2021-11-11]
factory/step/5_40mir_front.STEP
49.0 x 53.5 x 15.0 mm
