Yangjie-SUSTC/Large_FOV_withDM/custom/19-adaptor_pil_dec_tab_rail.SLDPRT

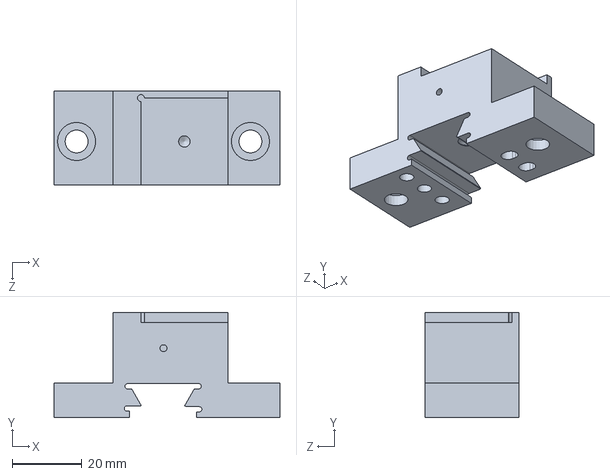
[picture p69: CAD file, 2021-11-11]
custom/19-adaptor_pil_dec_tab_rail.SLDPRT
65.0 x 30.3 x 27.0 mm
