Yangjie-SUSTC/Large_FOV_withDM/custom/Y27-Pinhole1mm.SLDPRT

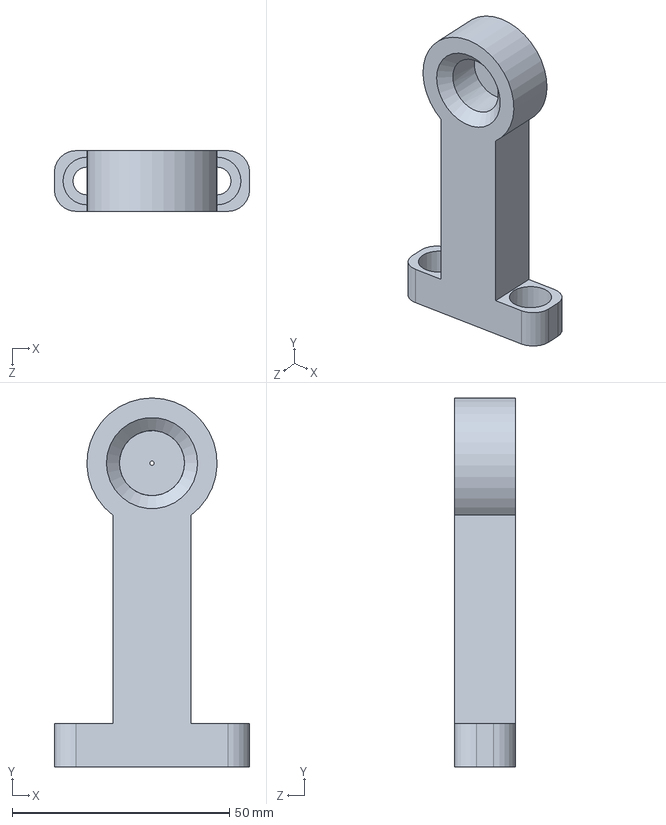
[picture p70: CAD file, 2021-11-11]
custom/Y27-Pinhole1mm.SLDPRT
45.0 x 85.0 x 14.0 mm
