Yangjie-SUSTC/Large_FOV_withDM/commercial/OW12-A.STEP

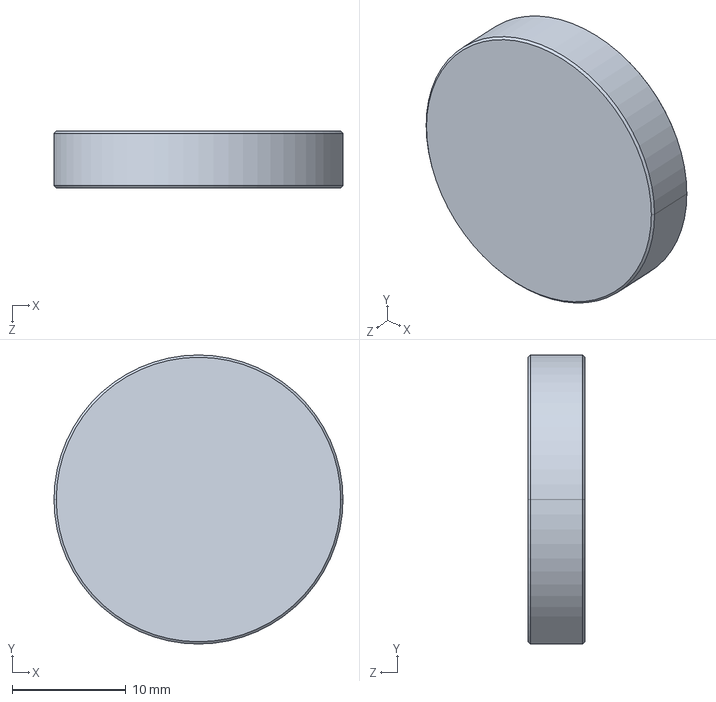
[picture p71: CAD file, 2021-11-11]
commercial/OW12-A.STEP
25.4 x 25.4 x 5.00 mm
