Yangjie-SUSTC/Large_FOV_withDM/commercial/SM1D12D-Solidworks.sldprt

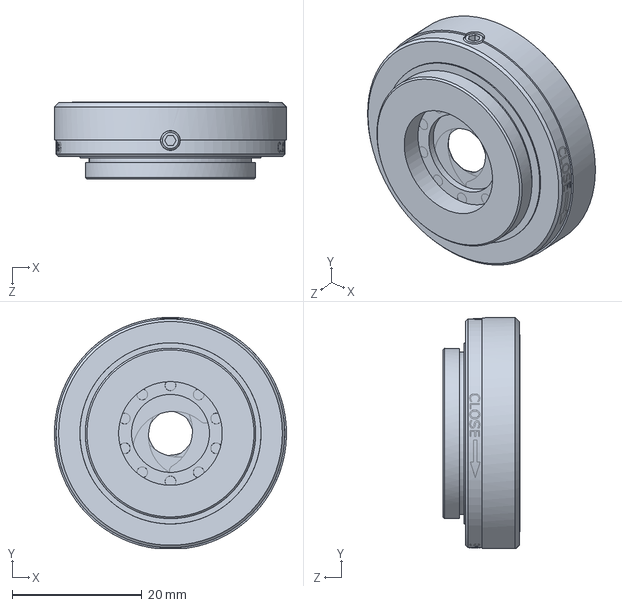
[picture p72: CAD file, 2021-11-11]
commercial/SM1D12D-Solidworks.sldprt
35.8 x 35.7 x 11.9 mm
