Yangjie-SUSTC/Large_FOV_withDM/custom/11-adaptor_mir_rail.SLDPRT

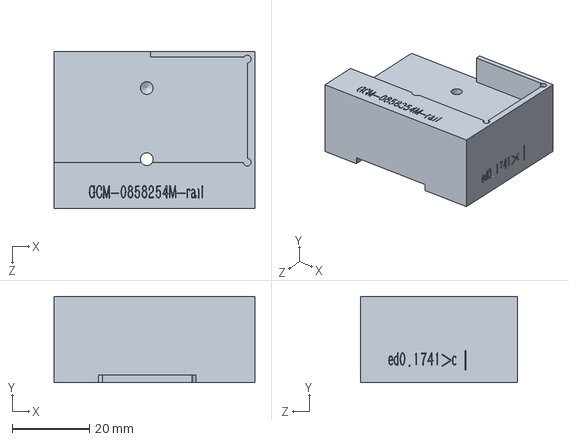
[picture p73: CAD file, 2021-11-11]
custom/11-adaptor_mir_rail.SLDPRT
52.0 x 22.3 x 40.7 mm
