Yangjie-SUSTC/Large_FOV_withDM/custom/1-rail_liner.SLDPRT

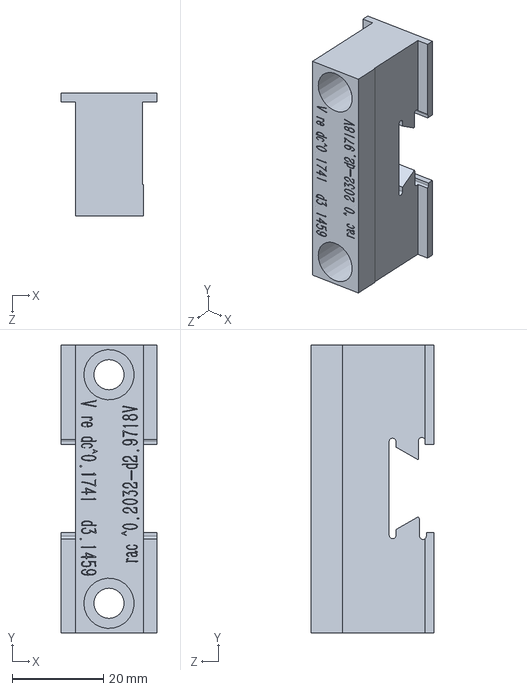
[picture p74: CAD file, 2021-11-11]
custom/1-rail_liner.SLDPRT
21.0 x 63.0 x 26.9 mm
