Yangjie-SUSTC/Large_FOV_withDM/custom/2-adaptor_fix_pin_tube_cen_fix.SLDPRT

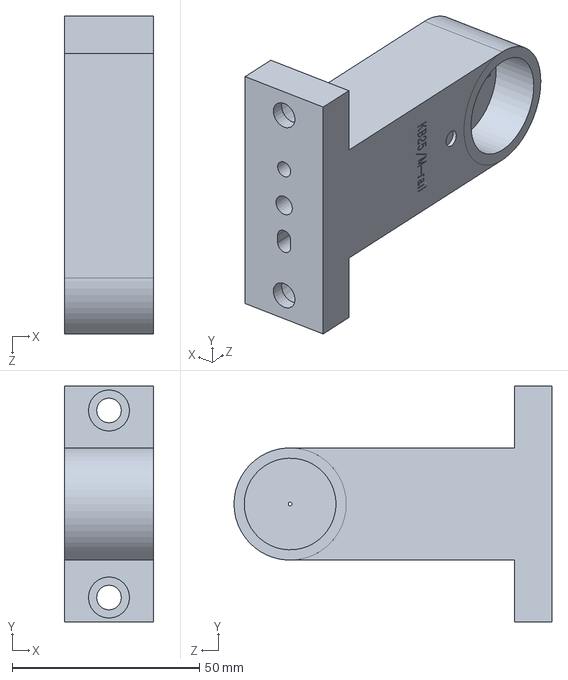
[picture p75: CAD file, 2021-11-11]
custom/2-adaptor_fix_pin_tube_cen_fix.SLDPRT
23.8 x 63.0 x 85.0 mm
