Yangjie-SUSTC/Large_FOV_withDM/custom/19-adaptor_pil_dec_tab.SLDPRT

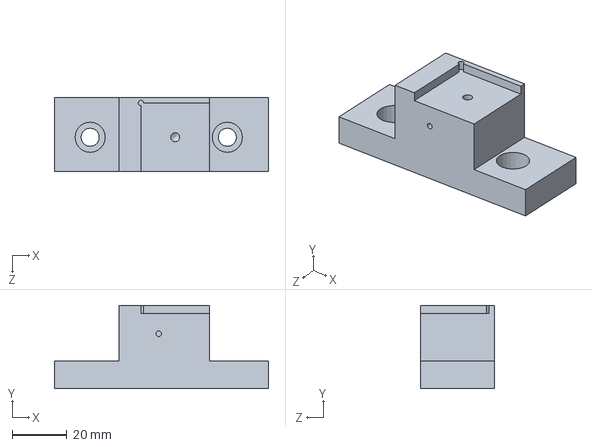
[picture p76: CAD file, 2021-11-11]
custom/19-adaptor_pil_dec_tab.SLDPRT
78.0 x 30.3 x 27.0 mm
