Yangjie-SUSTC/Large_FOV_withDM/custom/DM_fix.SLDPRT

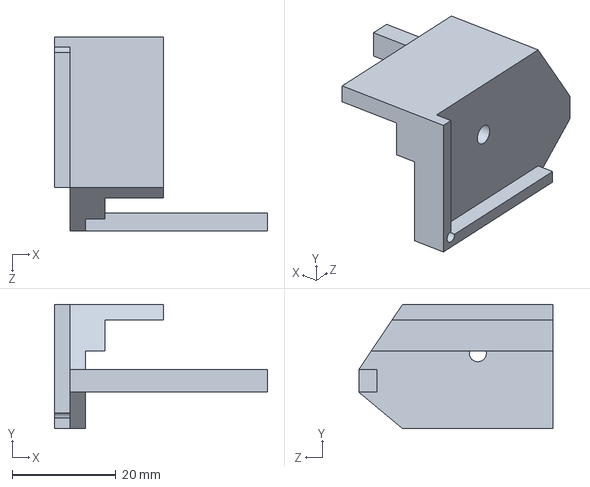
[picture p77: CAD file, 2021-11-11]
custom/DM_fix.SLDPRT
41.0 x 23.9 x 37.4 mm
