Yangjie-SUSTC/Large_FOV_withDM/custom/15-adaptor_pinhole_dec.SLDPRT

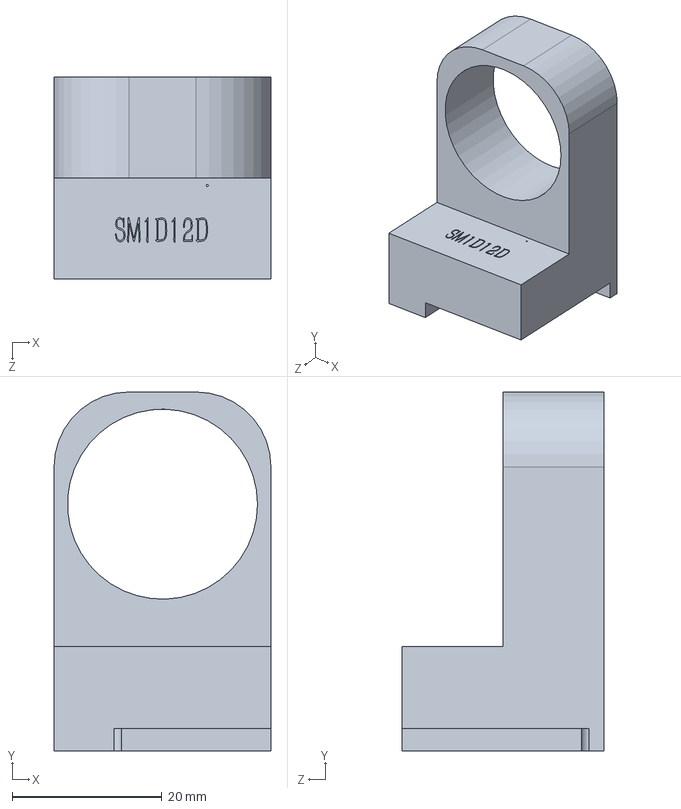
[picture p78: CAD file, 2021-11-11]
custom/15-adaptor_pinhole_dec.SLDPRT
29.0 x 48.0 x 27.0 mm
