Yangjie-SUSTC/Large_FOV_withDM/custom/adptor.SLDPRT

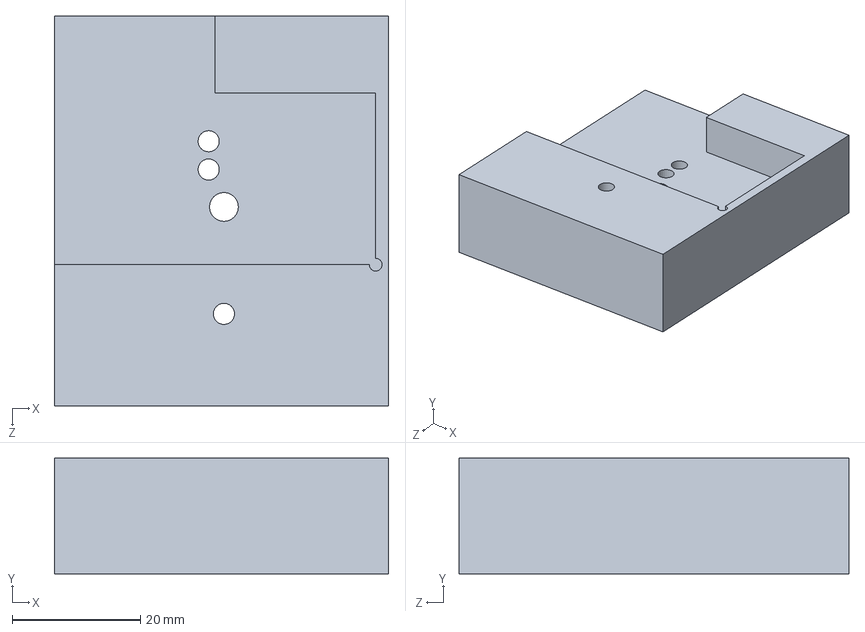
[picture p79: CAD file, 2021-11-11]
custom/adptor.SLDPRT
52.0 x 18.0 x 60.7 mm
