Yangjie-SUSTC/Large_FOV_withDM/custom/7-adaptor_fix_pinhole_rail.SLDPRT

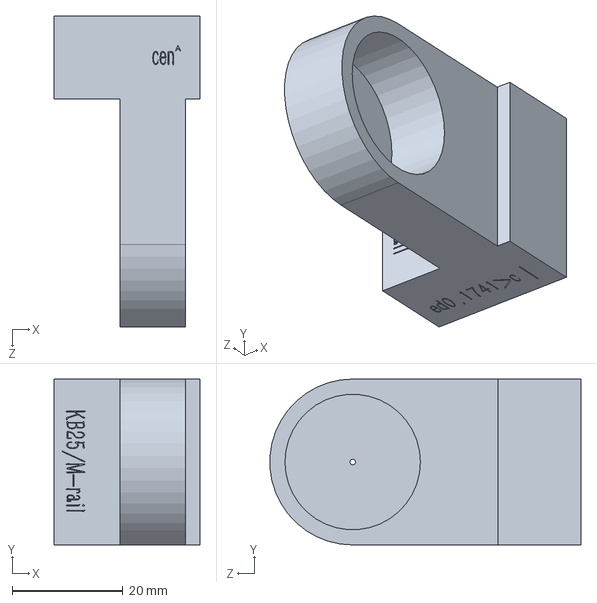
[picture p81: CAD file, 2021-11-11]
custom/7-adaptor_fix_pinhole_rail.SLDPRT
26.4 x 30.0 x 56.2 mm
