Yangjie-SUSTC/Large_FOV_withDM/custom/20-adaptor_pil_dec_foc.SLDPRT

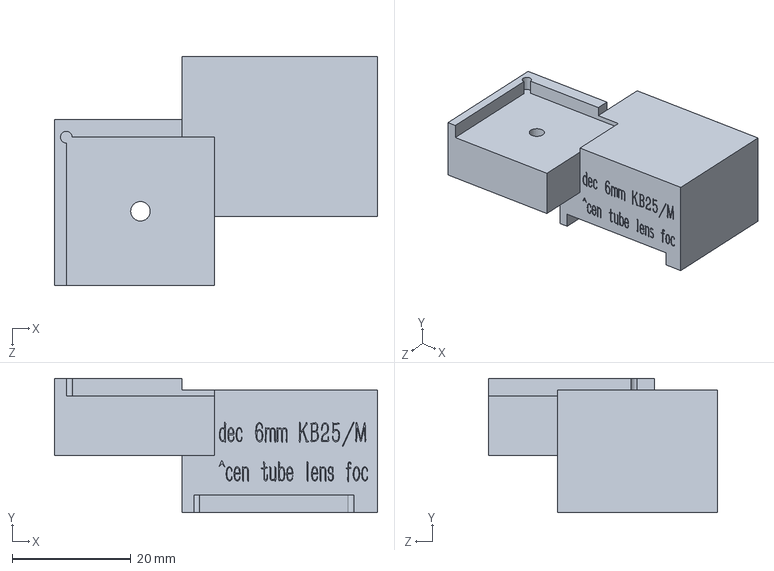
[picture p82: CAD file, 2021-11-11]
custom/20-adaptor_pil_dec_foc.SLDPRT
54.5 x 22.7 x 38.6 mm
