Yangjie-SUSTC/Large_FOV_withDM/custom/8-adaptor_fix_pin_tube_rail.SLDPRT

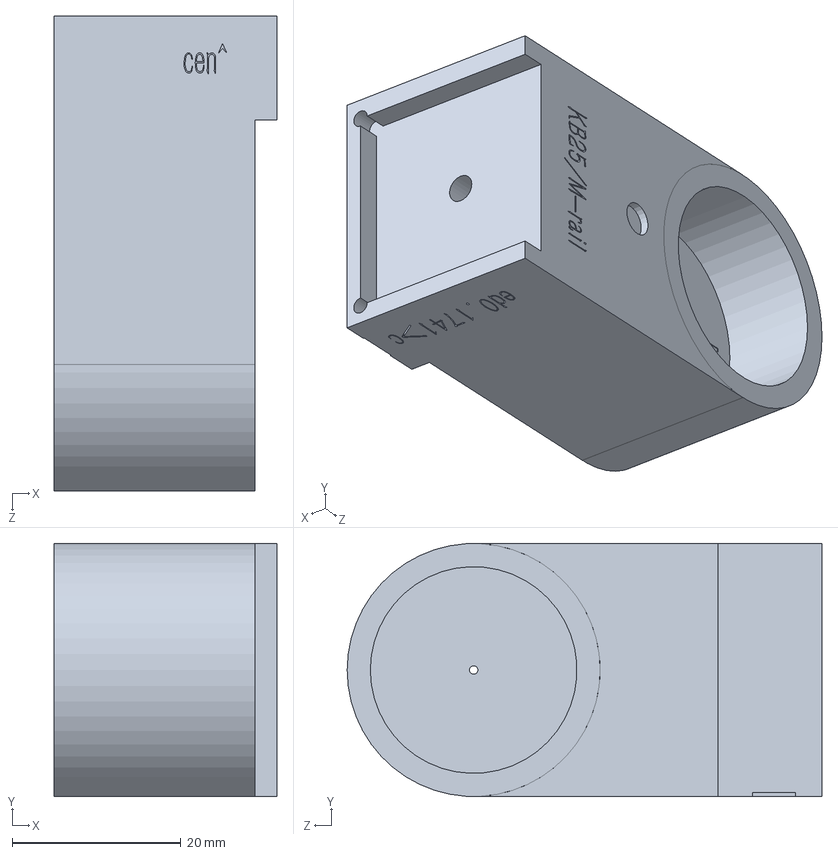
[picture p83: CAD file, 2021-11-11]
custom/8-adaptor_fix_pin_tube_rail.SLDPRT
26.4 x 30.0 x 56.3 mm
