Yangjie-SUSTC/Large_FOV_withDM/custom/6-adaptor_cam_cen_fix.SLDPRT

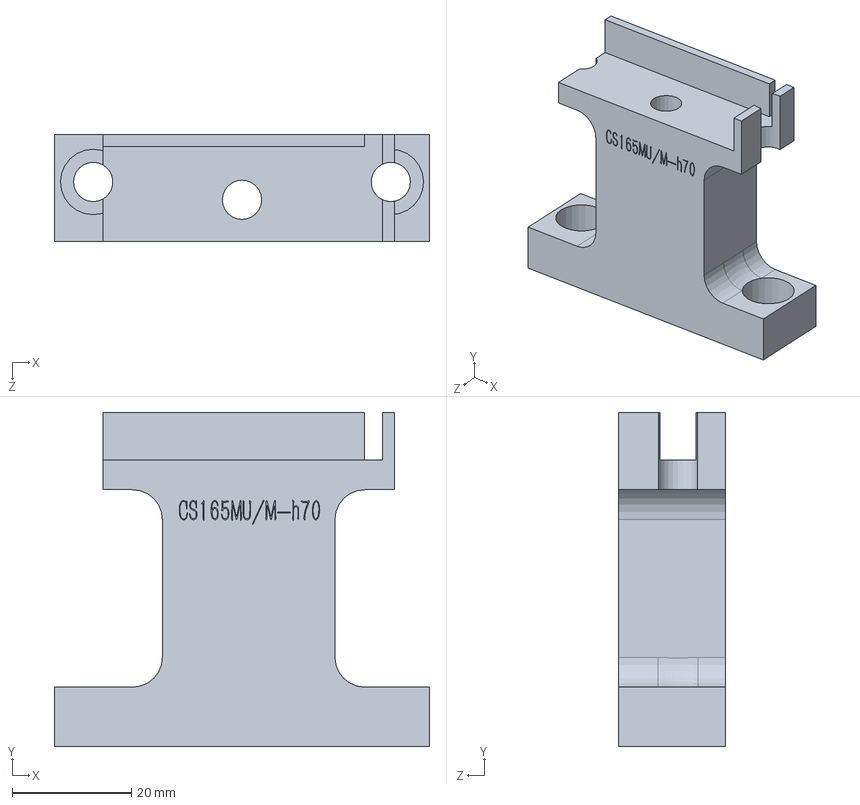
[picture p84: CAD file, 2021-11-11]
custom/6-adaptor_cam_cen_fix.SLDPRT
63.0 x 56.2 x 18.0 mm
