Yangjie-SUSTC/Large_FOV_withDM/custom/16-adaptor_VRC_dec.SLDPRT

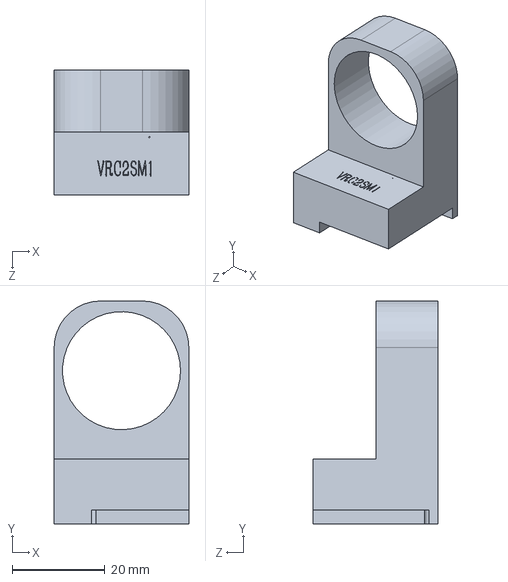
[picture p85: CAD file, 2021-11-11]
custom/16-adaptor_VRC_dec.SLDPRT
29.0 x 48.0 x 27.0 mm
