Yangjie-SUSTC/Large_FOV_withDM/custom/1_f150_sup.SLDPRT

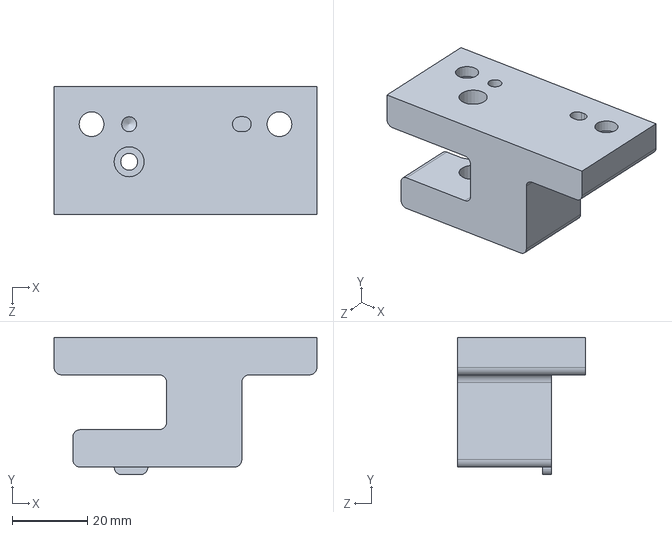
[picture p86: CAD file, 2021-11-11]
custom/1_f150_sup.SLDPRT
70.0 x 36.6 x 34.0 mm
