Yangjie-SUSTC/Large_FOV_withDM/custom/fix_pin_adaptor.SLDPRT

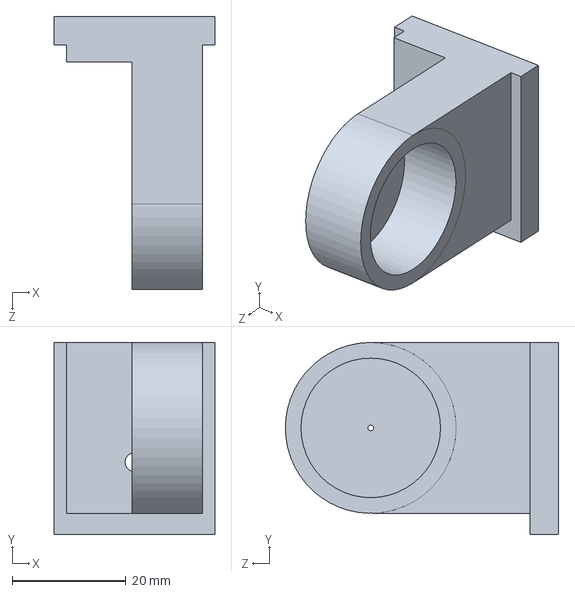
[picture p87: CAD file, 2021-11-11]
custom/fix_pin_adaptor.SLDPRT
28.2 x 33.7 x 48.0 mm
