Yangjie-SUSTC/Large_FOV_withDM/custom/20-adaptor_pil_dec_mag_tab.SLDPRT

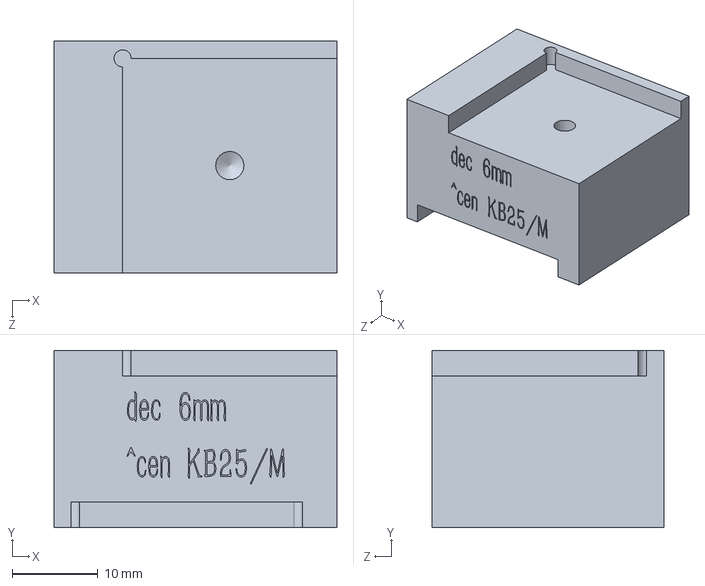
[picture p88: CAD file, 2021-11-11]
custom/20-adaptor_pil_dec_mag_tab.SLDPRT
33.0 x 20.7 x 27.0 mm
