Yangjie-SUSTC/Large_FOV_withDM/custom/1-adaptor_fix_pinhole_cen_fix.SLDPRT

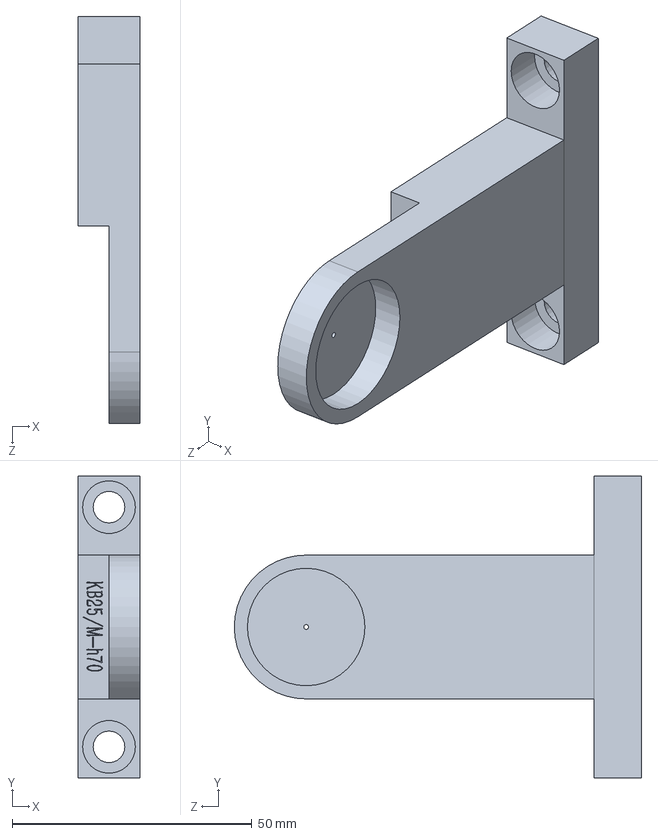
[picture p89: CAD file, 2021-11-11]
custom/1-adaptor_fix_pinhole_cen_fix.SLDPRT
13.0 x 63.0 x 85.0 mm
