Yangjie-SUSTC/Large_FOV_withDM/(list of files, cad)

Other CAD files:
custom/40cm_mir.SLDASM
factory/南科大20211108/dwg/19_rail_liner.DWG
factory/新建文件夹/2_Vbase_2inch - 副本.SLDPRT
factory/南科大20211108/dwg/15-adaptor_cam_cen_fix.DWG
factory/南科大20211108/dwg/14_fix_ph_h70.DWG
factory/南科大20211108/step/13_DM_fix.STEP
custom/4-adaptor_VRC_cen_fix_rail.SLDPRT
factory/step/4_Vbase_1inch.STEP
factory/step/17_adp_TL_phfoc.STEP
factory/step/新建文件夹/16_adp_cam_dec.STEP
factory/南科大20211108/step/7_SM1-40_adp.STEP
factory/南科大20211108/step/4_Vbase_1inch.STEP
factory/step/新建文件夹/20_adaptor_cam_rail.STEP
factory/step/11_baseBoard.STEP
factory/step/新建文件夹/6_40cm_mir_back.STEP
factory/step/13_DM_fix.STEP
factory/step/新建文件夹/1_2inch_mag_stage.STEP
custom/4-adaptor_VRC_cen_fix.SLDPRT
factory/step/8_DM_sta.STEP
factory/step/新建文件夹/9_DM_adp.STEP
factory/南科大20211108/step/11_baseBoard.STEP
factory/step/新建文件夹/3_f150_sta.STEP
custom/Vmir_base_2inch.SLDPRT
factory/step/新建文件夹/5_40mir_front.STEP
factory/step/新建文件夹/2_Vbase_2inch.STEP
factory/南科大20211108/step/8_DM_sta.STEP
factory/step/7_SM1-40_adp.STEP
factory/step/新建文件夹/12_adaptor_pil_dec_tab.STEP
factory/南科大20211108/step/17_adp_TL_phfoc.STEP
custom/10-adaptor_VRC_rail.SLDPRT
custom/9-adaptor_pinhole_rail_foc.SLDPRT
custom/5-adaptor_mir_cen_fix.SLDPRT
custom/1-adaptor_fix_pinhole_cen_fix_rail.SLDPRT
custom/3-baseBoard.SLDPRT
custom/18-adaptor_cam_dec.SLDPRT
custom/6-rail_liner.SLDPRT
custom/11_baseBoard_all_hole.SLDPRT
custom/11_baseBoard.SLDPRT
custom/Vmir_base_1inch.SLDPRT
custom/7-adaptor_fix_pinhole_foc.SLDPRT
custom/2-adaptor_fix_pin_tube_cen_fix_rail.SLDPRT
custom/adptor_fix_pinhole.SLDPRT
custom/12-adaptor_cam_rail.SLDPRT
custom/3-adaptor_pinhole_cen_fix_rail.SLDPRT
custom/6-adaptor_cam_cen_fix_rail1.SLDPRT
commercial/GCM-0858254M 外型图.SLDPRT
commercial/MISUMI_PIN4mm.SLDPRT
commercial/edge_rail_carier - 副本 (2).SLDASM
commercial/edge_rail_carier - 副本.SLDASM
custom/1_f150_sup - 副本 (2).SLDPRT
custom/1_f150_sup - 副本.SLDPRT
custom/3-baseBoard - 副本.SLDPRT
factory/10_pho_cam_hol.SLDPRT
factory/11_baseBoard.SLDPRT
factory/12_adaptor_pil_dec_tab.SLDPRT
factory/13_DM_fix.SLDPRT
factory/16_adp_cam_dec.SLDPRT
factory/17_adp_TL_phfoc.SLDPRT
factory/18_2inch_mag_sta_zh.SLDPRT
factory/1_2inch_mag_stage.SLDPRT
factory/20_adaptor_cam_rail.SLDPRT
factory/2_Vbase_2inch.SLDPRT
factory/3_f150_sta.SLDPRT
factory/4_Vbase_1inch.SLDPRT
factory/5_40mir_front.SLDPRT
factory/6_40cm_mir_back.SLDPRT
factory/7_SM1-40_adp.SLDPRT
factory/8_DM_sta.SLDPRT
factory/9_DM_adp.SLDPRT
factory/draw/10_pho_cam_hol.SLDDRW
factory/draw/11_baseBoard.SLDDRW
factory/draw/12_adaptor_pil_dec_tab.SLDDRW
factory/draw/13_DM_fix.SLDDRW
factory/draw/14_fix_ph_h70.SLDDRW
factory/draw/15-adaptor_cam_cen_fix.SLDDRW
factory/draw/16_adp_cam_dec.SLDDRW
factory/draw/17_adp_TL_phfoc.SLDDRW
factory/draw/18_2inch_mag_sta_zh.SLDDRW
factory/draw/19_rail_liner.SLDDRW
factory/draw/1_2inch_mag_stage.SLDDRW
factory/draw/20_adaptor_cam_rail.SLDDRW
factory/draw/2_Vbase_2inch.SLDDRW
factory/draw/3_f150_sta.SLDDRW
factory/draw/4_Vbase_1inch.SLDDRW
factory/draw/5_40mir_front.SLDDRW
factory/draw/6_40cm_mir_back.SLDDRW
factory/draw/7_SM1-40_adp.SLDDRW
factory/draw/8_DM_sta.SLDDRW
factory/draw/9_DM_adp.SLDDRW
factory/draw/新建文件夹/11_baseBoard - 副本 (2).SLDDRW
factory/draw/新建文件夹/11_baseBoard - 副本.SLDDRW
factory/dwg/10_pho_cam_hol.DWG
factory/dwg/11_baseBoard.DWG
factory/dwg/12_adaptor_pil_dec_tab.DWG
factory/dwg/13_DM_fix.DWG
factory/dwg/14_fix_ph_h70.DWG
factory/dwg/15-adaptor_cam_cen_fix.DWG
factory/dwg/16_adp_cam_dec.DWG
factory/dwg/17_adp_TL_phfoc.DWG
factory/dwg/18_2inch_mag_sta_zh.DWG
factory/dwg/19_rail_liner.DWG
factory/dwg/1_2inch_mag_stage.DWG
factory/dwg/20_adaptor_cam_rail.DWG
factory/dwg/2_Vbase_2inch.DWG
factory/dwg/3_f150_sta.DWG
factory/dwg/4_Vbase_1inch.DWG
factory/dwg/5_40mir_front.DWG
factory/dwg/6_40cm_mir_back.DWG
factory/dwg/7_SM1-40_adp.DWG
factory/dwg/8_DM_sta.DWG
factory/dwg/9_DM_adp.DWG
factory/南科大20211108/dwg/10_pho_cam_hol.DWG
factory/南科大20211108/dwg/11_baseBoard.DWG
factory/南科大20211108/dwg/12_adaptor_pil_dec_tab.DWG
factory/南科大20211108/dwg/13_DM_fix.DWG
factory/南科大20211108/dwg/16_adp_cam_dec.DWG
factory/南科大20211108/dwg/17_adp_TL_phfoc.DWG
factory/南科大20211108/dwg/18_2inch_mag_sta_zh.DWG
factory/南科大20211108/dwg/1_2inch_mag_stage.DWG
factory/南科大20211108/dwg/20_adaptor_cam_rail.DWG
factory/南科大20211108/dwg/2_Vbase_2inch.DWG
factory/南科大20211108/dwg/3_f150_sta.DWG
factory/南科大20211108/dwg/4_Vbase_1inch.DWG
factory/南科大20211108/dwg/5_40mir_front.DWG
factory/南科大20211108/dwg/6_40cm_mir_back.DWG
factory/南科大20211108/dwg/7_SM1-40_adp.DWG
factory/南科大20211108/dwg/8_DM_sta.DWG
factory/南科大20211108/dwg/9_DM_adp.DWG
ref/light_path/f150_focus.SLDPRT
