Yangjie-SUSTC/Large_FOV_withDM/factory/pdf/14_fix_ph_h70.PDF

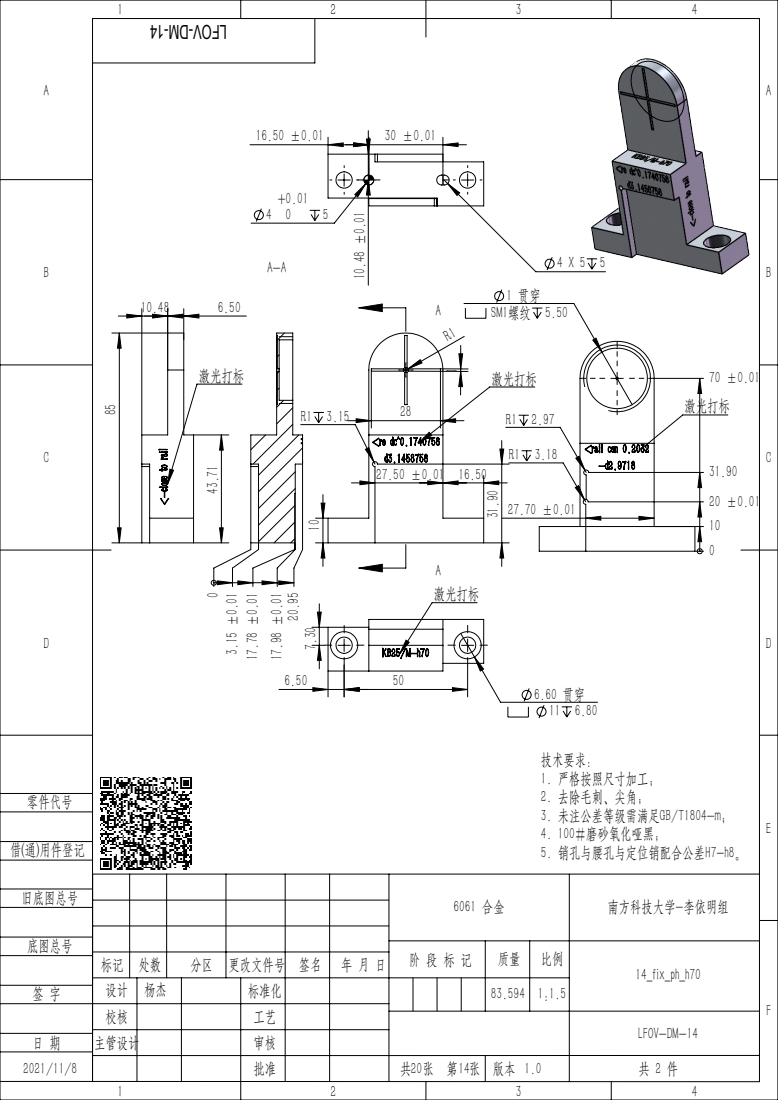
[picture p91: page 1]
激光打标 0 3.15 ±0.01; 1. 严格按照尺寸加工； 2. 去除毛刺、尖角； 3. 未注公差等级需满足GB/T1804-m; 4. 100#磨砂氧化哑黑; 5. 销孔与腰孔与定位销配合公差H7-h8。

6061 合金 | 南方科技大学-李依明组

阶 段 标 记 | 质量 | 比例 | 14_fix_ph_h70

标记 | 处数 | 分区 | 更改文件号 | 签名 | 年 月 日
设计 | 杨杰 | | 标准化 | | | | | | 83.594 | 1:1.5
校核 | | | 工艺
主管设计 | | | 审核

LFOV-DM-14
