Yangjie-SUSTC/Large_FOV_withDM/factory/pdf/20_adaptor_cam_rail.PDF

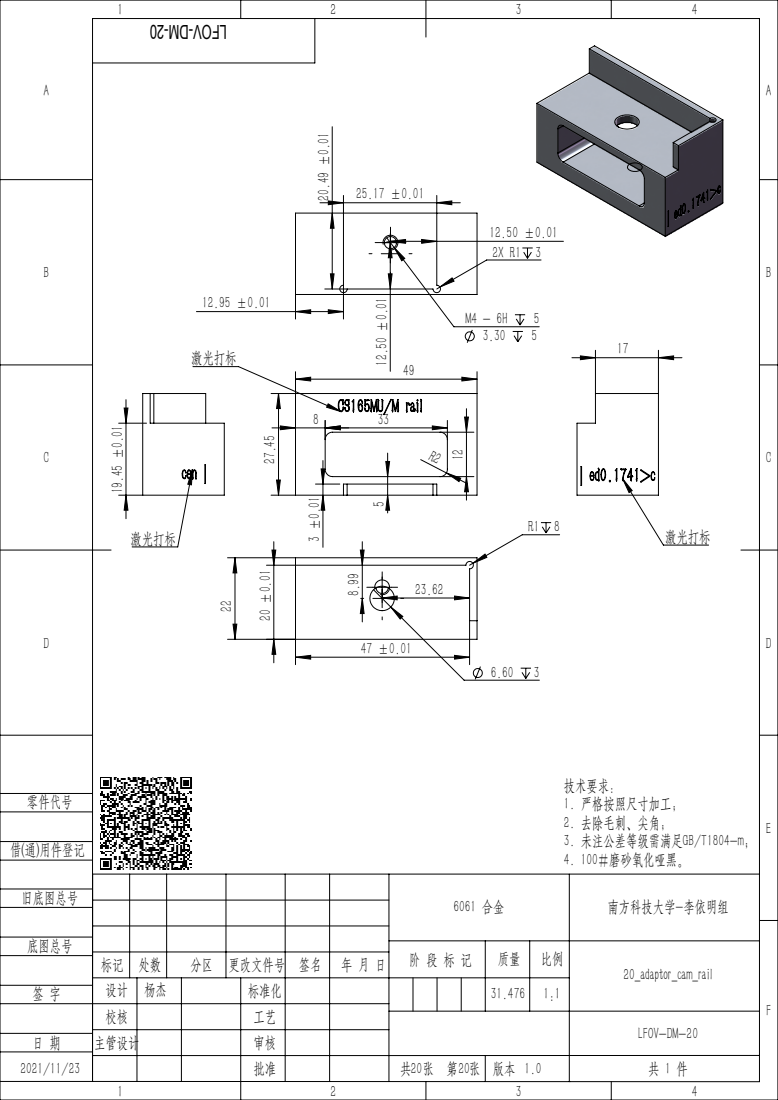
[picture p95: page 1]
1. 严格按照尺寸加工； 2. 去除毛刺、尖角； 3. 未注公差等级需满足GB/T1804-m; 4. 100#磨砂氧化哑黑。

6061 合金 | 南方科技大学-李依明组

阶 段 标 记 | 质量 | 比例 | 20_adaptor_cam_rail

标记 | 处数 | 分区 | 更改文件号 | 签名 | 年 月 日
设计 | 杨杰 | | 标准化 | | | | | | 31.476 | 1:1
校核 | | | 工艺
主管设计 | | | 审核

LFOV-DM-20
