Yangjie-SUSTC/Large_FOV_withDM/factory/pdf/5_40mir_front.PDF

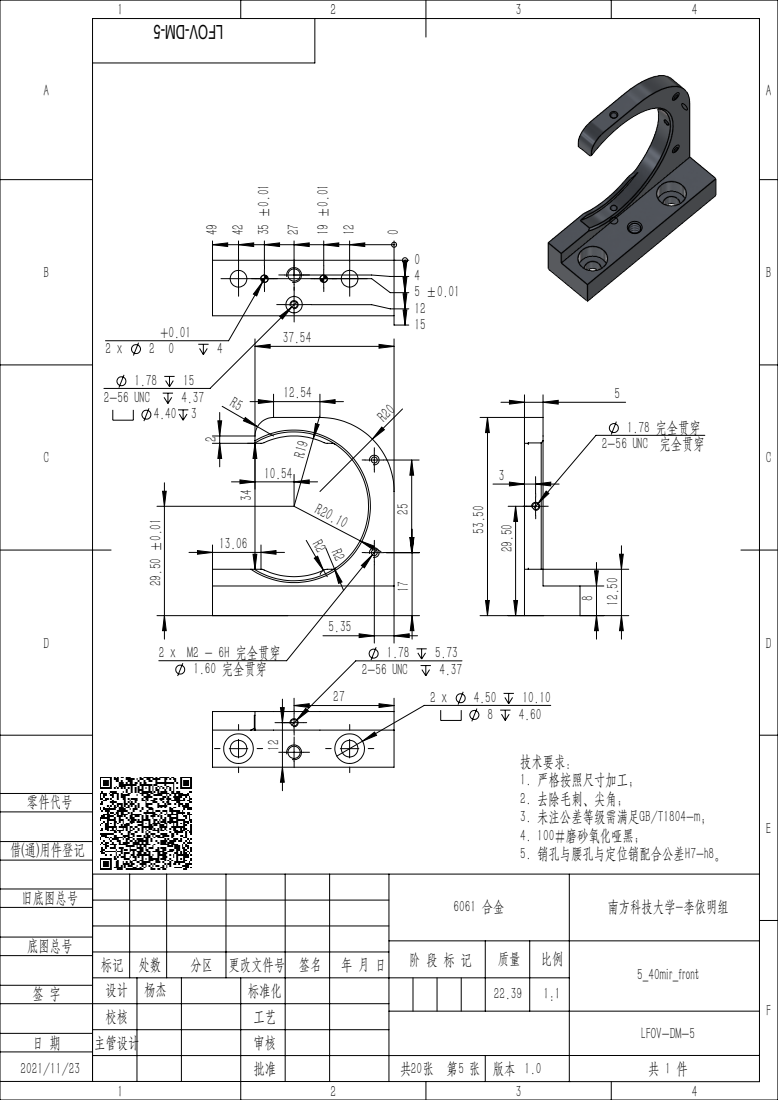
[picture p96: page 1]
2 x M2 - 6H 完全贯穿 1.60 完全贯穿; 2-56 UNC; 1. 严格按照尺寸加工； 2. 去除毛刺、尖角； 3. 未注公差等级需满足GB/T1804-m; 4. 100#磨砂氧化哑黑; 5. 销孔与腰孔与定位销配合公差H7-h8。

1.78 完全贯穿 2-56 UNC 完全贯穿

6061 合金 | 南方科技大学-李依明组

阶 段 标 记 | 质量 | 比例 | 5_40mir_front

标记 | 处数 | 分区 | 更改文件号 | 签名 | 年 月 日
设计 | 杨杰 | | 标准化 | | | | | | 22.39 | 1:1
校核 | | | 工艺
主管设计 | | | 审核

LFOV-DM-5
