Yangjie-SUSTC/Large_FOV_withDM/factory/pdf/7_SM1-40_adp.PDF

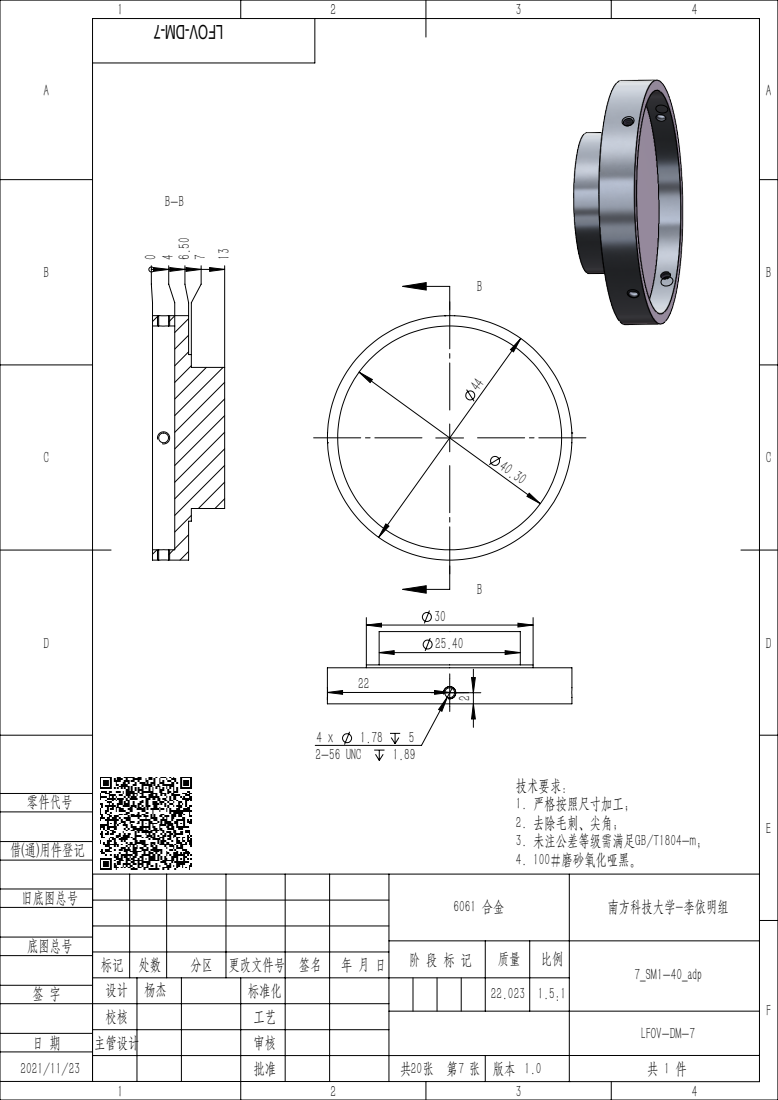
[picture p97: page 1]
2-56 UNC; 1. 严格按照尺寸加工； 2. 去除毛刺、尖角； 3. 未注公差等级需满足GB/T1804-m; 4. 100#磨砂氧化哑黑。

6061 合金 | 南方科技大学-李依明组

阶 段 标 记 | 质量 | 比例 | 7_SM1-40_adp

标记 | 处数 | 分区 | 更改文件号 | 签名 | 年 月 日
设计 | 杨杰 | | 标准化 | | | | | | 22.023 | 1.5:1
校核 | | | 工艺
主管设计 | | | 审核

LFOV-DM-7
