Yangjie-SUSTC/Large_FOV_withDM/factory/pdf/9_DM_adp.PDF

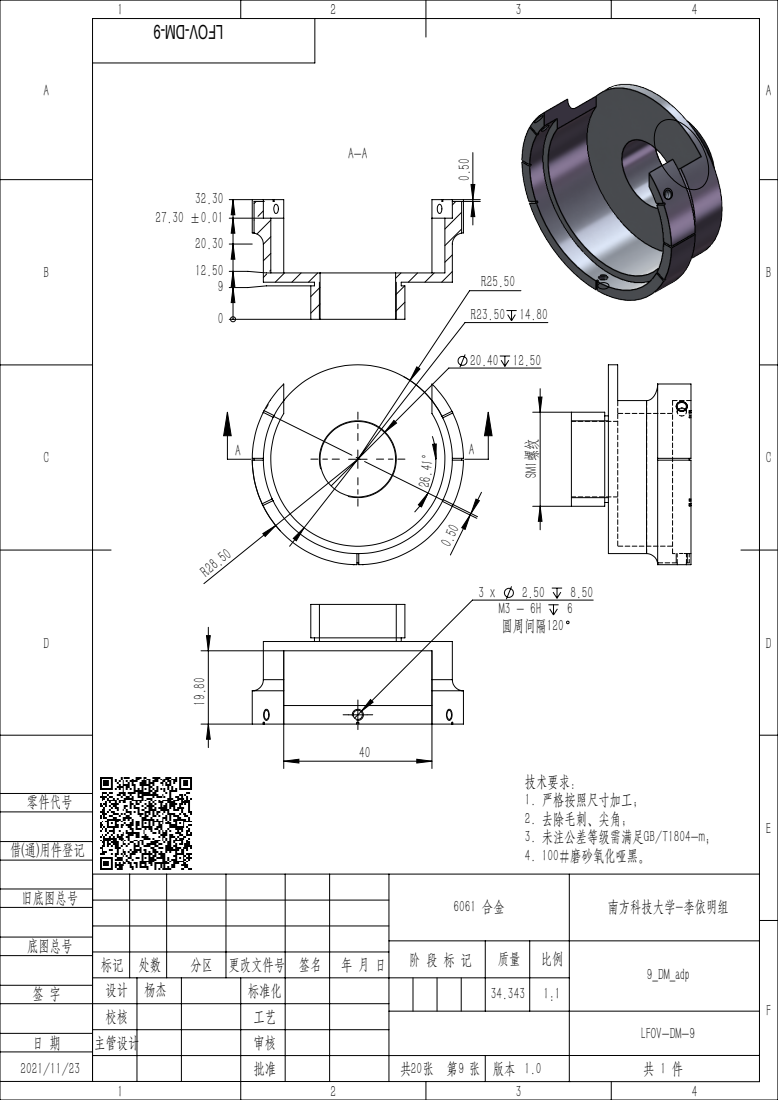
[picture p98: page 1]
圆周间隔120 SM1螺纹; 1. 严格按照尺寸加工； 2. 去除毛刺、尖角； 3. 未注公差等级需满足GB/T1804-m; 4. 100#磨砂氧化哑黑。

6061 合金 | 南方科技大学-李依明组

阶 段 标 记 | 质量 | 比例 | 9_DM_adp

标记 | 处数 | 分区 | 更改文件号 | 签名 | 年 月 日
设计 | 杨杰 | | 标准化 | | | | | | 34.343 | 1:1
校核 | | | 工艺
主管设计 | | | 审核

LFOV-DM-9
