Yangjie-SUSTC/Large_FOV_withDM/factory/南科大20211108/LFOV-DM-STROM_SUSTech.pdf

# LFOV-DM-STORM 图纸集

杨杰

## yangj3@mail.sustech.edu.cn

### https://github.com/Yangjie-SUSTC/Large_FOV_withDM

2021/11/08

4.50 完全贯穿; 底图总号; 旧底图总号; 借(通)用件登记; 零件代号; 技术要求： 1. 严格按照尺寸加工； 2. 去除毛刺、尖角； 3. 未注公差等级需满足GB/T1804-m; 4. 100#磨砂氧化哑黑; 5. 销孔与腰孔与定位销配合公差H7-h8。

标签 | X 位置 Y 位置 | | 大小
1 | 89.08 | 34 | 4.50 完全贯穿

2 | 67.16 | 24.24 | M4 - 6H 完全贯穿 3.30 完全贯穿
3 | 76.32 | 28.32
4 | 18.70 | 20.70 | 4.50 完全贯穿

6 | 25 | 27 | M6 - 6H 完全贯穿 5 完全贯穿

7 | 12.50 | 14.50 | 6.60 完全贯穿

6061 合金 | 南方科技大学-李依明组

阶 段 标 记 | 质量 | 比例 | 1_2inch_mag_stage

标记 | 处数 | 分区 | 更改文件号 | 签名 | 年 月 日
设计 | 杨杰 | | 标准化 | | | | | | 69.054 | 1:1
校核 | | | 工艺
主管设计 | | | 审核

LFOV-DM-1

38.80 ³⁸.18

6.60 完全贯穿; 4.50 完全贯穿; 底图总号; 旧底图总号; 借(通)用件登记; 零件代号; 技术要求： 1. 严格按照尺寸加工； 2. 去除毛刺、尖角； 3. 未注公差等级需满足GB/T1804-m; 4. 100#磨砂氧化哑黑; 5. 销孔与腰孔与定位销配合公差H7-h8。

6061 合金 | 南方科技大学-李依明组

阶 段 标 记 | 质量 | 比例 | 2_Vbase_2inch

标记 | 处数 | 分区 | 更改文件号 | 签名 | 年 月 日
设计 | 杨杰 | | 标准化 | | | 168.47 | 1:1

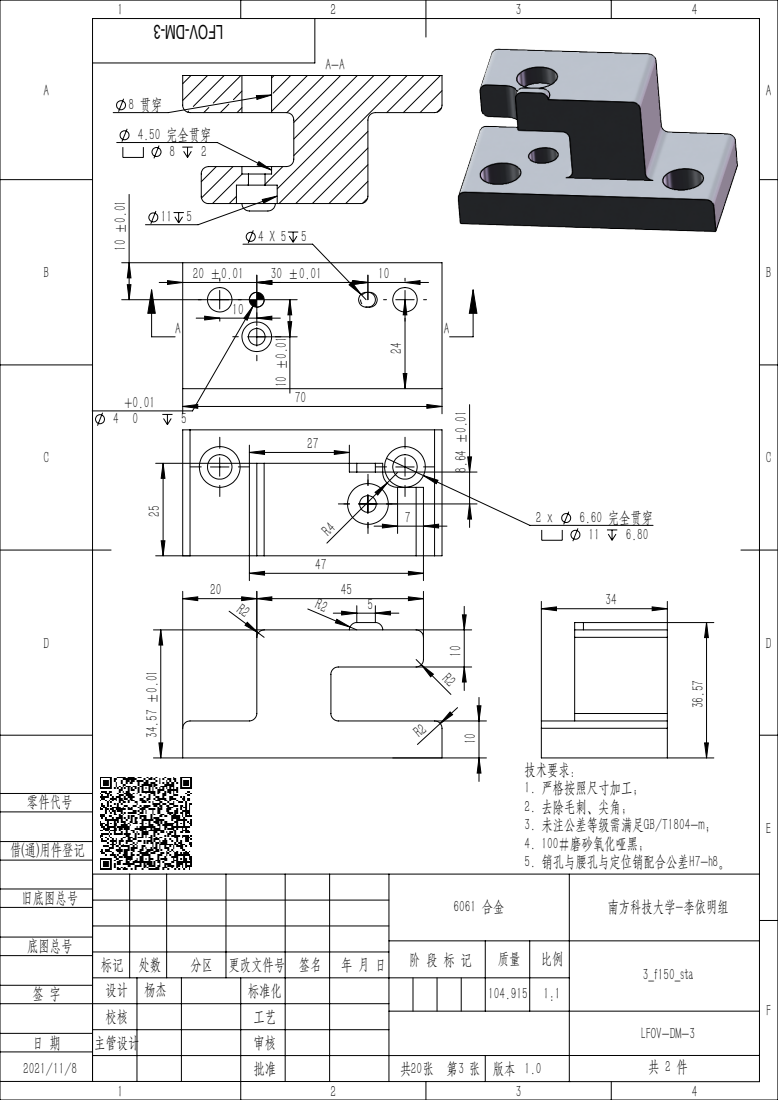
[picture p112: page 4]
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

6061 合金 | 南方科技大学-李依明组

阶 段 标 记 | 质量 | 比例 | 3_f150_sta

标记 | 处数 | 分区 | 更改文件号 | 签名 | 年 月 日
设计 | 杨杰 | | 标准化 | | | 104.915 | 1:1

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

标签 | X 位置 | Y 位置 | 大小
1 | 10 | -52.50 | 6.60 51.50

8 | 77.05 | -22
9 | 19.48 | -28.54 | +0.05 2 0 X 3 4

6061 合金 | 南方科技大学-李依明组

阶 段 标 记 | 质量 | 比例 | 4_Vbase_1inch

标记 | 处数 | 分区 | 更改文件号 | 签名 | 年 月 日
设计 | 杨杰 | | 标准化 | | | 354.33 | 1:1.5

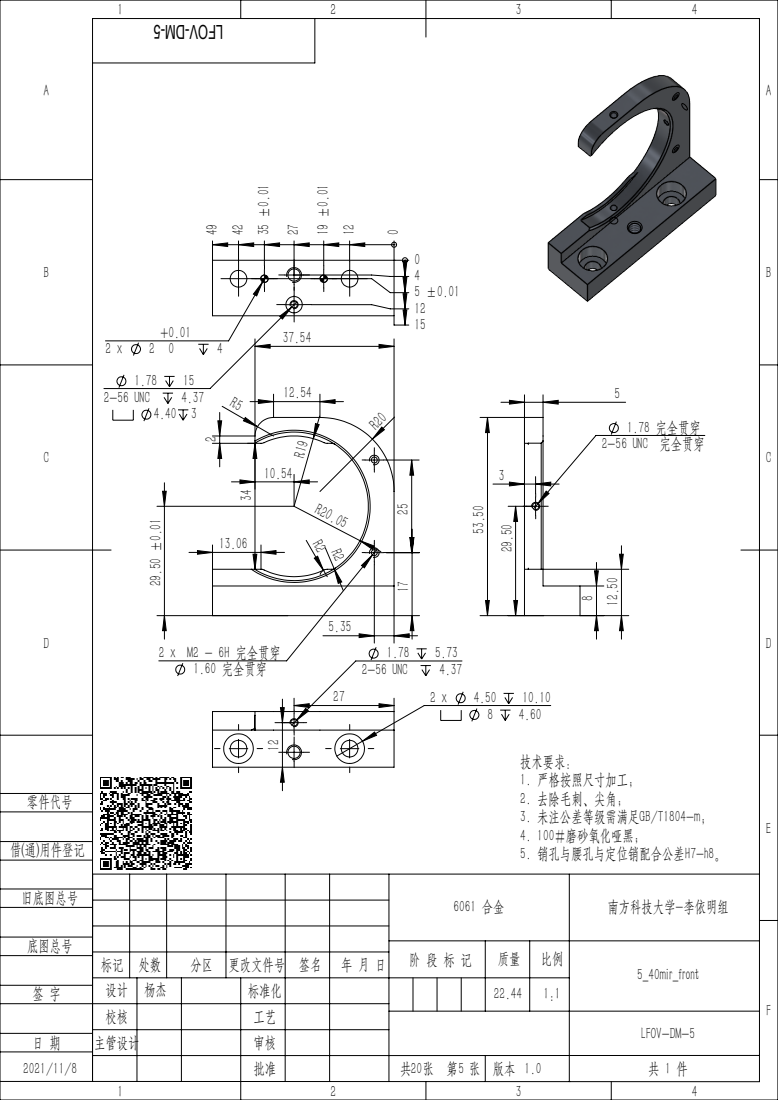
[picture p113: page 6]
2 x M2 - 6H 完全贯穿 1.60 完全贯穿; 2-56 UNC; 底图总号; 旧底图总号; 借(通)用件登记; 零件代号; 技术要求： 1. 严格按照尺寸加工； 2. 去除毛刺、尖角； 3. 未注公差等级需满足GB/T1804-m; 4. 100#磨砂氧化哑黑; 5. 销孔与腰孔与定位销配合公差H7-h8。

1.78 完全贯穿 2-56 UNC 完全贯穿

6061 合金 | 南方科技大学-李依明组

阶 段 标 记 | 质量 | 比例 | 5_40mir_front

标记 | 处数 | 分区 | 更改文件号 | 签名 | 年 月 日
设计 | 杨杰 | | 标准化 | | | 22.44 | 1:1

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

6061 合金 | 南方科技大学-李依明组

阶 段 标 记 | 质量 | 比例 | 6_40cm_mir_back

标记 | 处数 | 分区 | 更改文件号 | 签名 | 年 月 日
设计 | 杨杰 | | 标准化 | | | 8.328 | 2:1

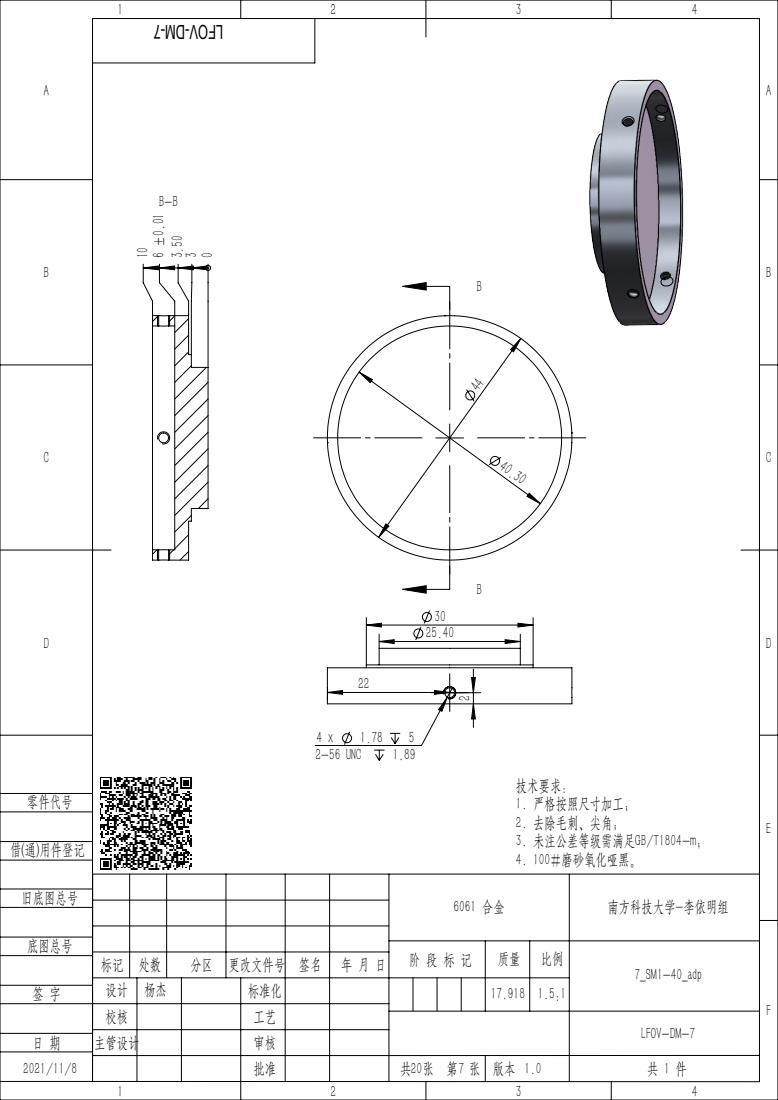
[picture p114: page 8]
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

6061 合金 | 南方科技大学-李依明组

阶 段 标 记 | 质量 | 比例 | 7_SM1-40_adp

标记 | 处数 | 分区 | 更改文件号 | 签名 | 年 月 日
设计 | 杨杰 | | 标准化 | | | 17.918 | 1.5:1

17.50 ±0.01 8.50

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

6061 合金 | 南方科技大学-李依明组

阶 段 标 记 | 质量 | 比例 | 8_DM_sta

标记 | 处数 | 分区 | 更改文件号 | 签名 | 年 月 日
设计 | 杨杰 | | 标准化 | | | 52.973 | 1:1

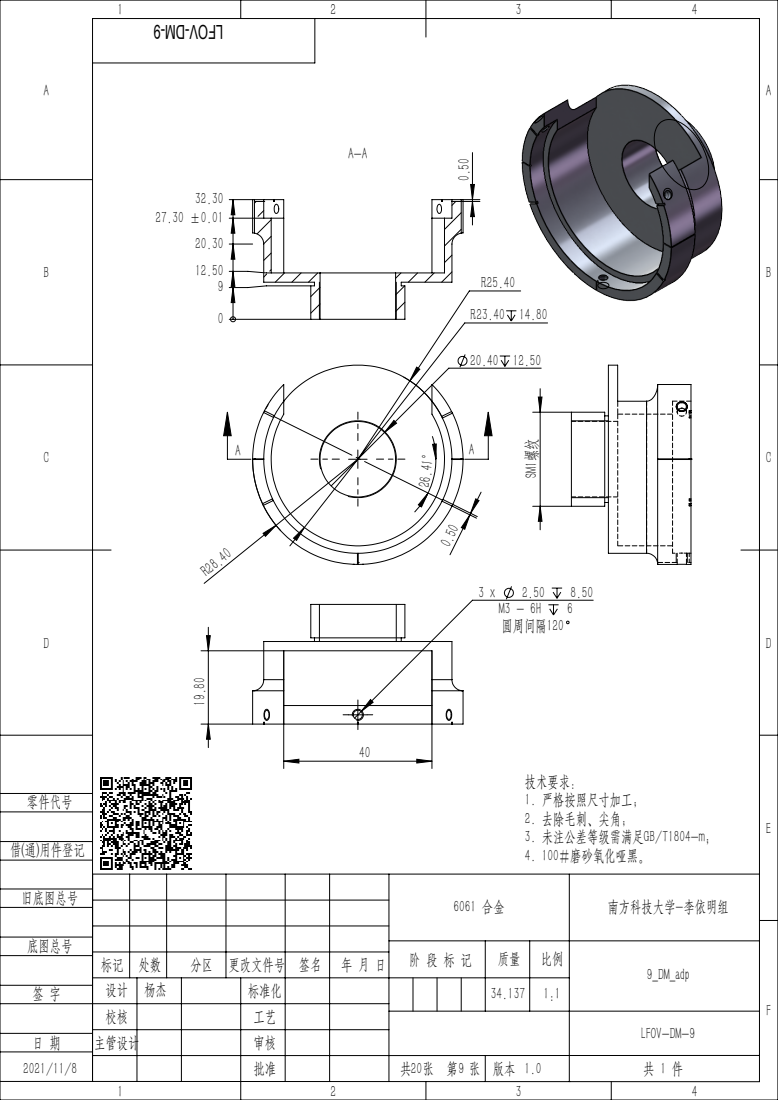
[picture p115: page 10]
圆周间隔120 SM1螺纹; 底图总号; 旧底图总号; 借(通)用件登记; 零件代号; 技术要求： 1. 严格按照尺寸加工； 2. 去除毛刺、尖角； 3. 未注公差等级需满足GB/T1804-m; 4. 100#磨砂氧化哑黑。

6061 合金 | 南方科技大学-李依明组

阶 段 标 记 | 质量 | 比例 | 9_DM_adp

标记 | 处数 | 分区 | 更改文件号 | 签名 | 年 月 日
设计 | 杨杰 | | 标准化 | | | 34.137 | 1:1

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

6061 合金 | 南方科技大学-李依明组

阶 段 标 记 | 质量 | 比例 | 10_pho_cam_hol

标记 | 处数 | 分区 | 更改文件号 | 签名 | 年 月 日
设计 | 杨杰 | | 标准化 | | | 552.556 | 1:3

Y

Y

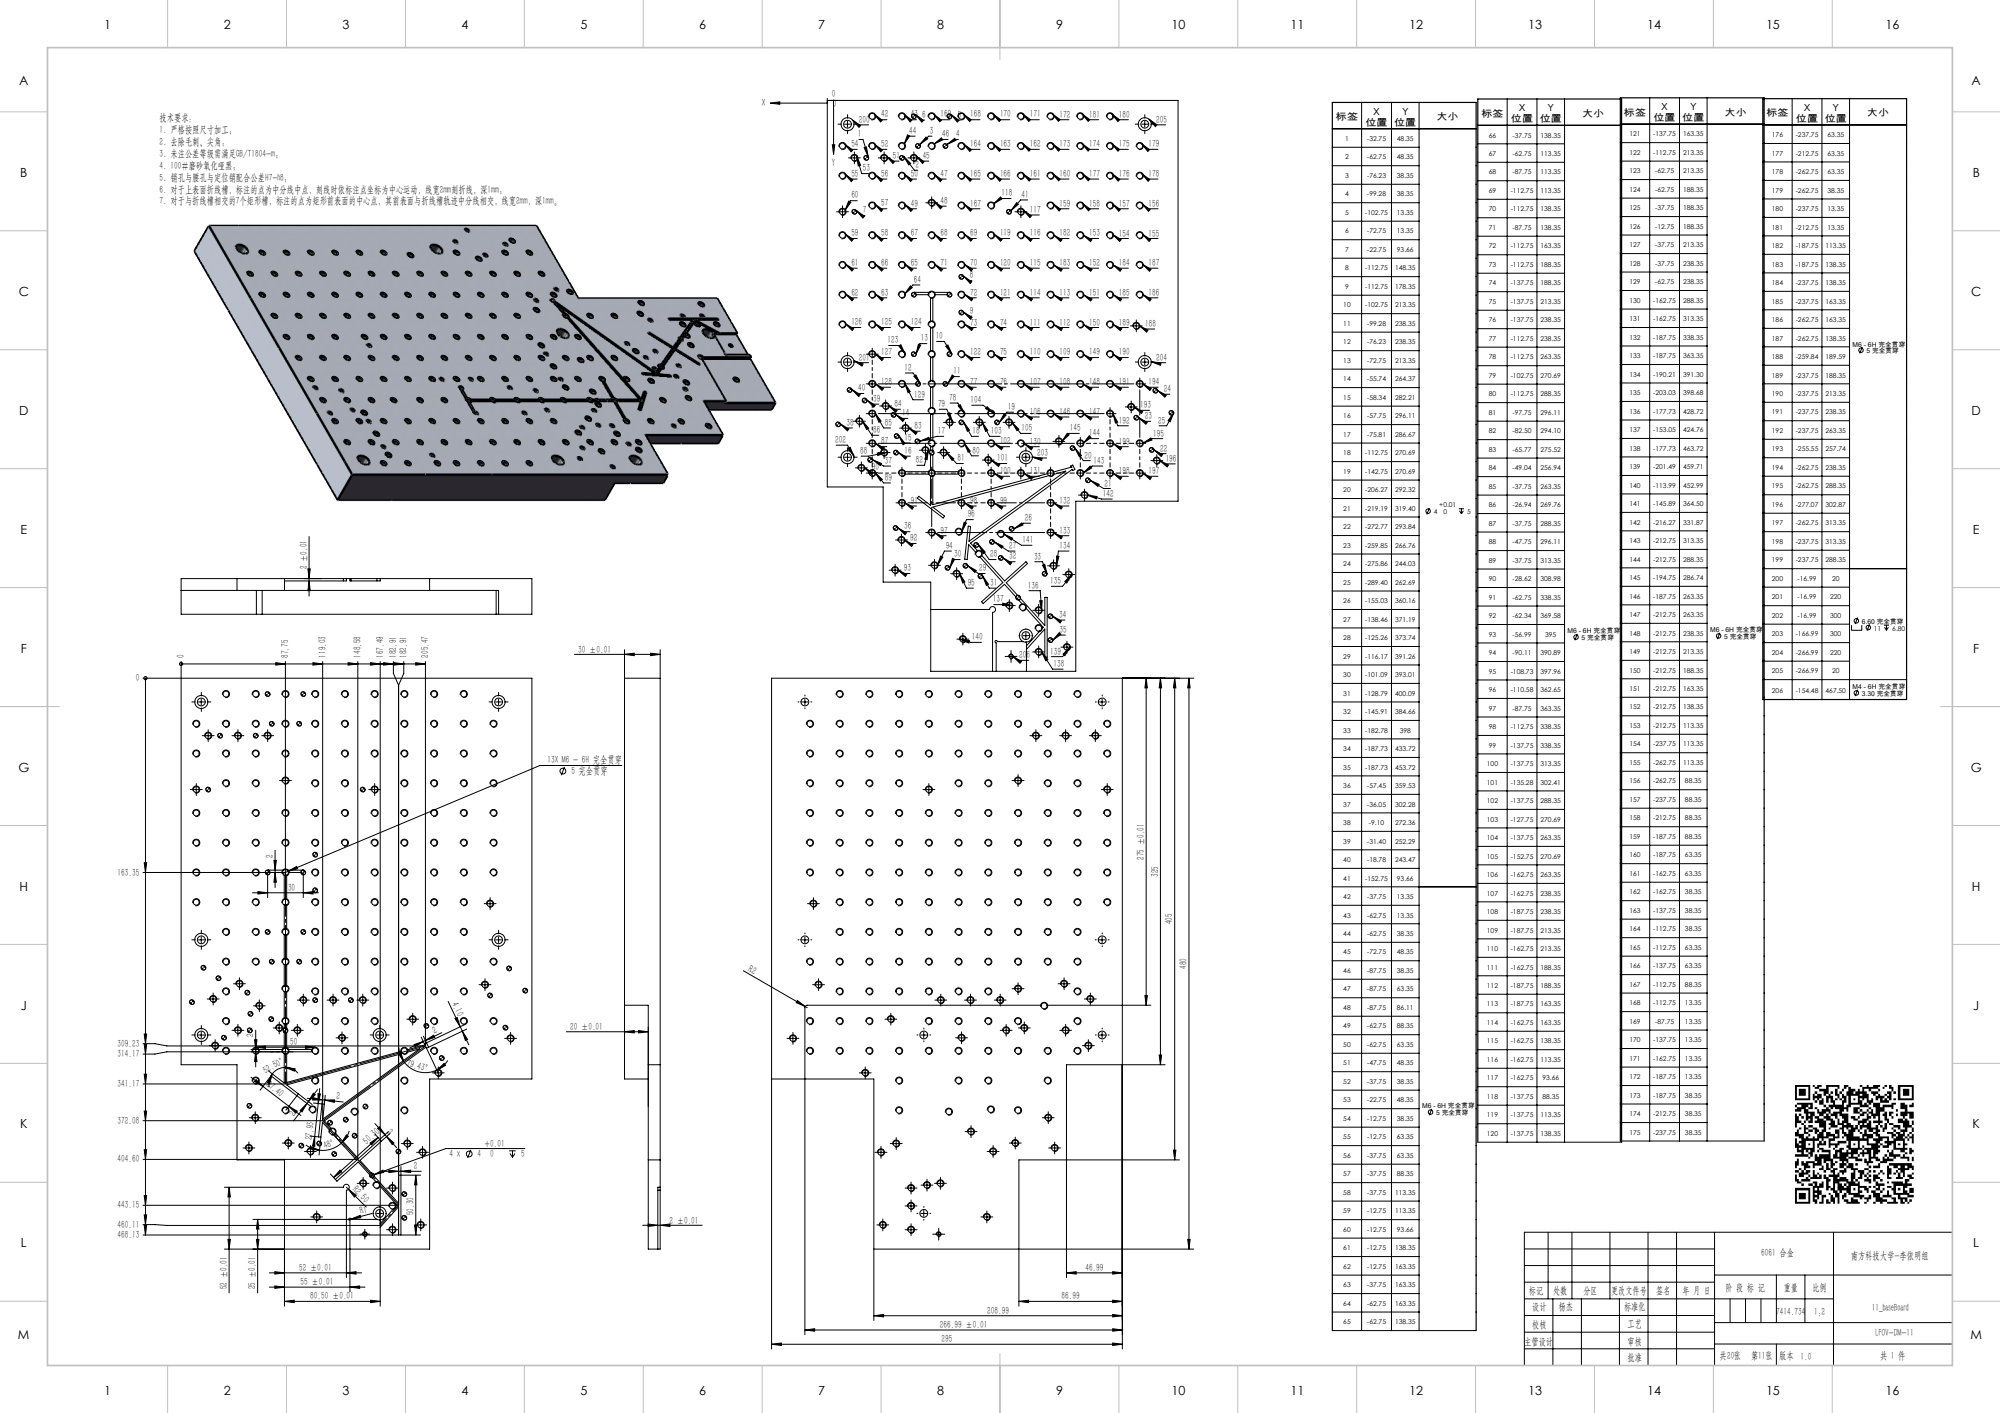
[picture p116: page 12]
13X M6 - 6H 完全贯穿 5 完全贯穿; M6 - 6H 完全贯穿 5 完全贯穿; 6.60 完全贯穿 11 6.80; -154.48 467.50 M4 - 6H 完全贯穿; 3.30 完全贯穿; 南方科技大学-李依明组; 标准化; 更改文件号; 11_baseBoard; 技术要求： 1. 严格按照尺寸加工； 2. 去除毛刺、尖角； 3. 未注公差等级需满足GB/T1804-m; 4. 100#磨砂氧化哑黑; 5. 销孔与腰孔与定位销配合公差H7-h8; 6. 对于上表面折线槽，标注的点为中分线中点，刻线时依标注点坐标为中心运动，线宽2mm刻折线，深1mm； 7. 对于与折线槽相交的7个矩形槽，标注的点为矩形前表面的中心点，其前表面与折线槽轨迹中分线相交，线宽2mm，深1mm。

0 5 ⁰

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

6061 合金 | 南方科技大学-李依明组

阶 段 标 记 | 质量 | 比例 | 12_adaptor_pil_dec_tab

标记 | 处数 | 分区 | 更改文件号 | 签名 | 年 月 日
设计 | 杨杰 | | 标准化 | | | 85.903 | 1:1

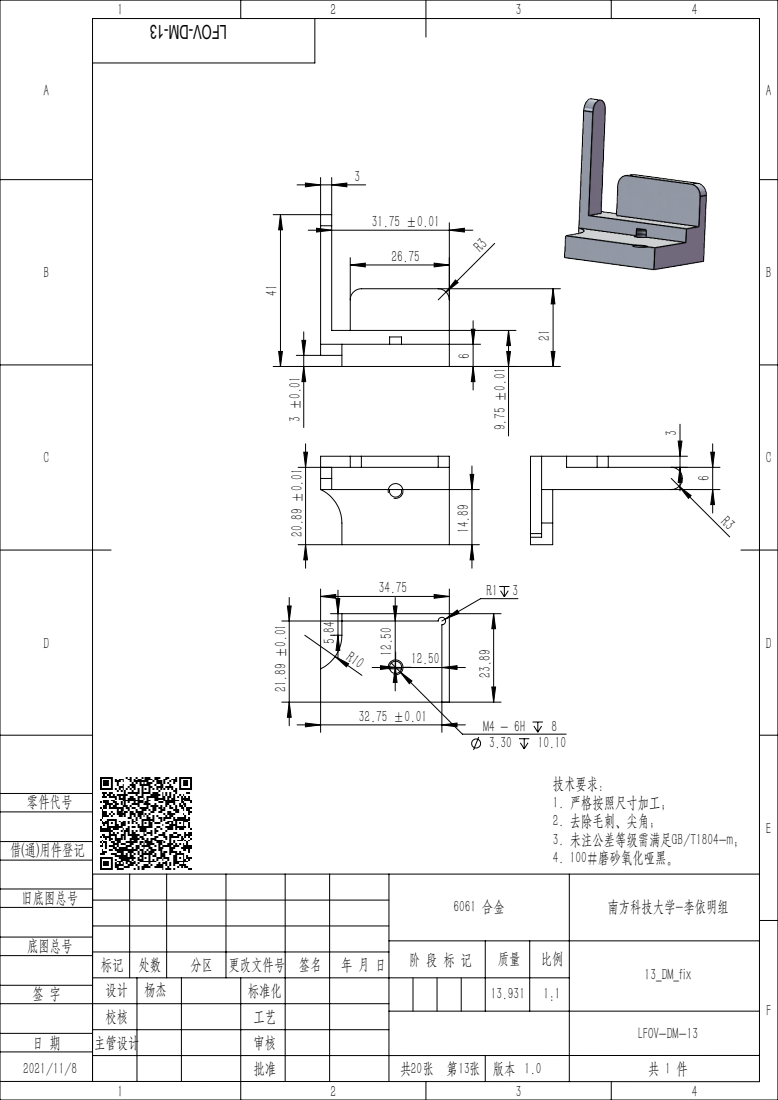
[picture p117: page 14]
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

6061 合金 | 南方科技大学-李依明组

阶 段 标 记 | 质量 | 比例 | 13_DM_fix

标记 | 处数 | 分区 | 更改文件号 | 签名 | 年 月 日
设计 | 杨杰 | | 标准化 | | | 13.931 | 1:1

激光打标; 激光打标 0 3.15 ±⁰.01; 底图总号; 旧底图总号; 借(通)用件登记; 零件代号; 技术要求： 1. 严格按照尺寸加工； 2. 去除毛刺、尖角； 3. 未注公差等级需满足GB/T1804-m; 4. 100#磨砂氧化哑黑; 5. 销孔与腰孔与定位销配合公差H7-h8。

6061 合金 | 南方科技大学-李依明组

阶 段 标 记 | 质量 | 比例 | 14_fix_ph_h70

标记 | 处数 | 分区 | 更改文件号 | 签名 | 年 月 日
设计 | 杨杰 | | 标准化 | | | 83.594 | 1:1.5

激光打标; 6.60 完全贯穿; 底图总号; 旧底图总号; 借(通)用件登记; 零件代号; 技术要求： 1. 严格按照尺寸加工； 2. 去除毛刺、尖角； 3. 未注公差等级需满足GB/T1804-m; 4. 100#磨砂氧化哑黑; 5. 销孔与腰孔与定位销配合公差H7-h8。

6061 合金 | 南方科技大学-李依明组

阶 段 标 记 | 质量 | 比例 | 15-adaptor_cam_cen_fix

标记 | 处数 | 分区 | 更改文件号 | 签名 | 年 月 日
设计 | 杨杰 | | 标准化 | | | 143.329 | 1:1

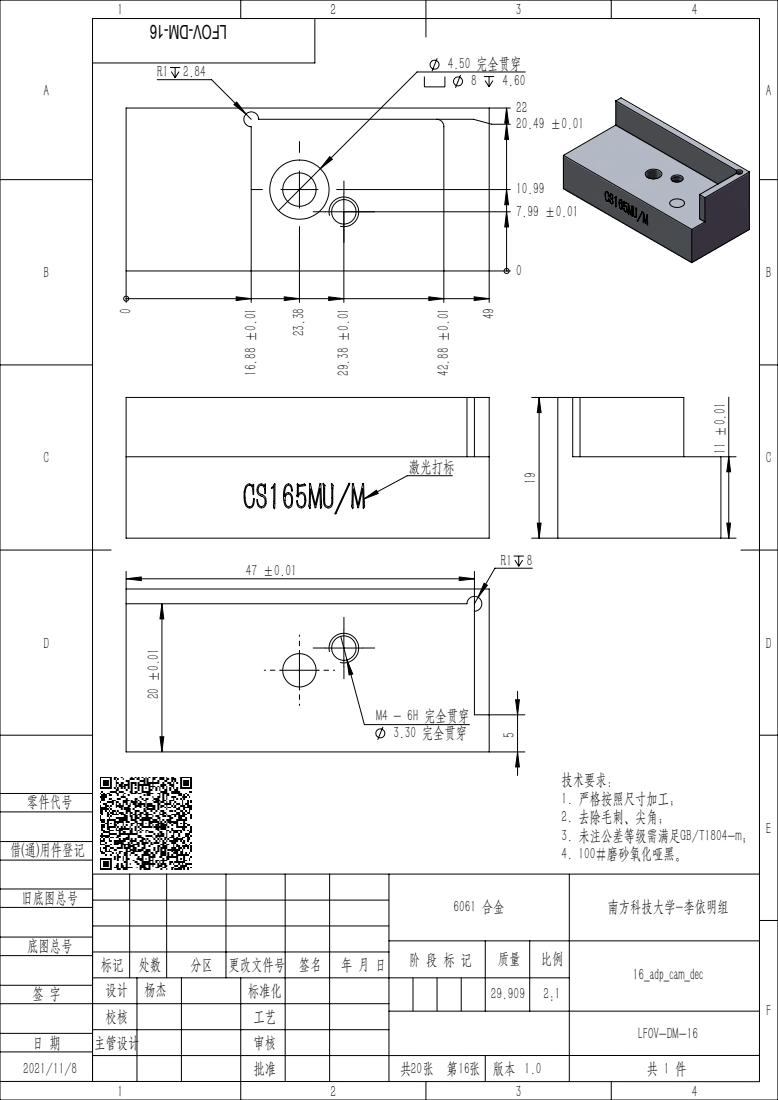
[picture p118: page 17]
激光打标; 4.50 完全贯穿; M4 - 6H 完全贯穿 3.30 完全贯穿; 底图总号; 旧底图总号; 借(通)用件登记; 零件代号; 技术要求： 1. 严格按照尺寸加工； 2. 去除毛刺、尖角； 3. 未注公差等级需满足GB/T1804-m; 4. 100#磨砂氧化哑黑。

6061 合金 | 南方科技大学-李依明组

阶 段 标 记 | 质量 | 比例 | 16_adp_cam_dec

标记 | 处数 | 分区 | 更改文件号 | 签名 | 年 月 日
设计 | 杨杰 | | 标准化 | | | 29.909 | 2:1

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

6061 合金 | 南方科技大学-李依明组

阶 段 标 记 | 质量 | 比例 | 17_adp_TL_phfoc

标记 | 处数 | 分区 | 更改文件号 | 签名 | 年 月 日
设计 | 杨杰 | | 标准化 | | | 77.081 | 1:1

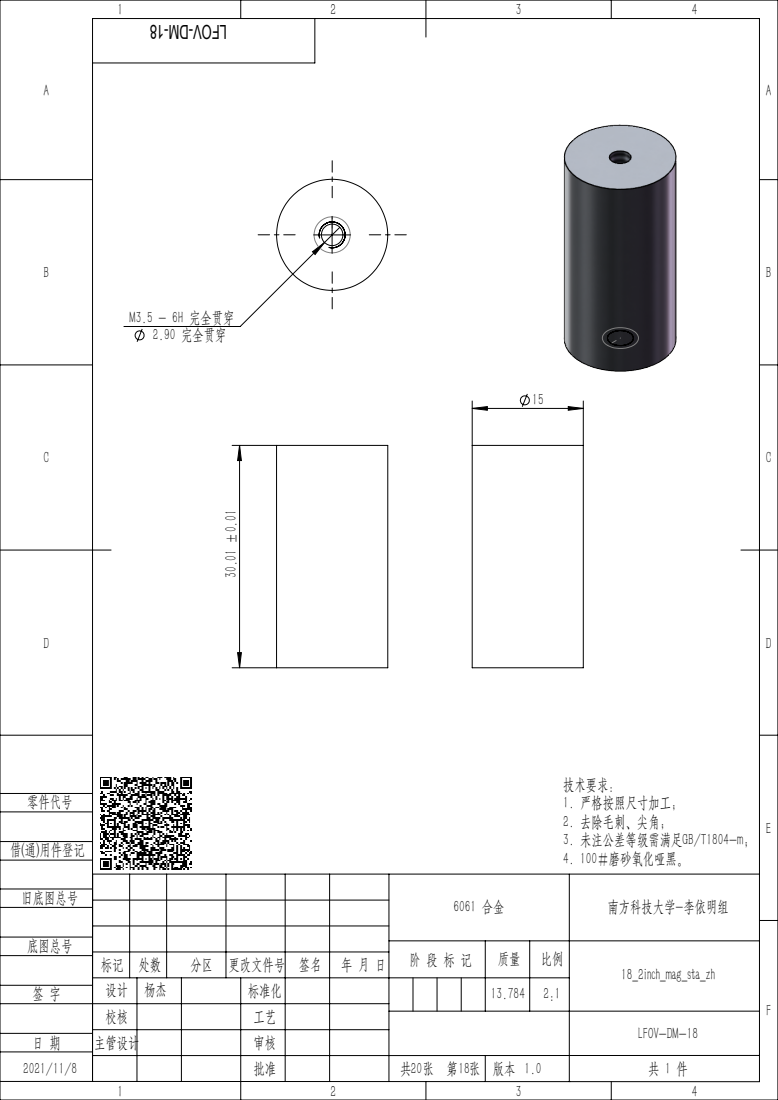
[picture p119: page 19]
M3.5 - 6H 完全贯穿 2.90 完全贯穿; 底图总号; 旧底图总号; 借(通)用件登记; 零件代号; 技术要求： 1. 严格按照尺寸加工； 2. 去除毛刺、尖角； 3. 未注公差等级需满足GB/T1804-m; 4. 100#磨砂氧化哑黑。

6061 合金 | 南方科技大学-李依明组

阶 段 标 记 | 质量 | 比例 | 18_2inch_mag_sta_zh

标记 | 处数 | 分区 | 更改文件号 | 签名 | 年 月 日
设计 | 杨杰 | | 标准化 | | | 13.784 | 2:1

6.60 完全贯穿; 激光打标; 底图总号; 旧底图总号; 借(通)用件登记; 零件代号; 技术要求： 1. 严格按照尺寸加工； 2. 去除毛刺、尖角； 3. 未注公差等级需满足GB/T1804-m; 4. 100#磨砂氧化哑黑; 5. 销孔与腰孔与定位销配合公差H7-h8。

6061 合金 | 南方科技大学-李依明组

阶 段 标 记 | 质量 | 比例 | 19_rail_liner

标记 | 处数 | 分区 | 更改文件号 | 签名 | 年 月 日
设计 | 杨杰 | | 标准化 | | | 91.494 | 1:1

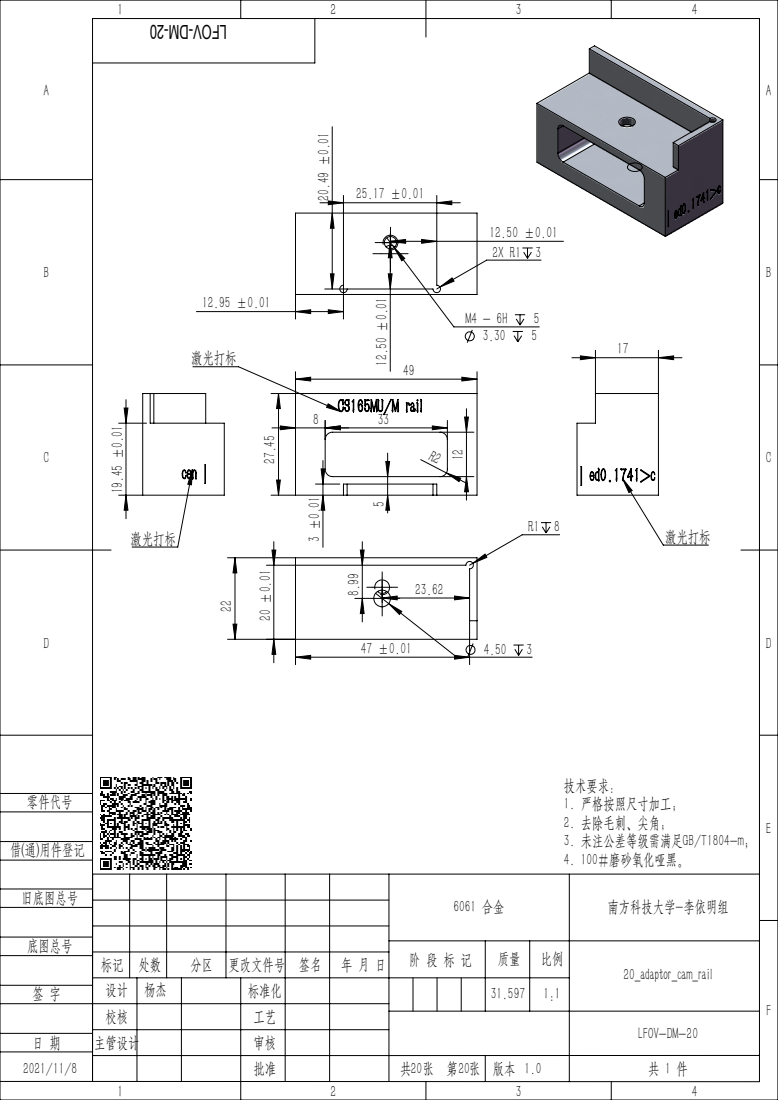
[picture p120: page 21]
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

6061 合金 | 南方科技大学-李依明组

阶 段 标 记 | 质量 | 比例 | 20_adaptor_cam_rail

标记 | 处数 | 分区 | 更改文件号 | 签名 | 年 月 日
设计 | 杨杰 | | 标准化 | | | 31.597 | 1:1
