Yangjie-SUSTC/Large_FOV_withDM/factory/修改/返厂V1.1/修改图纸V1.1.pdf

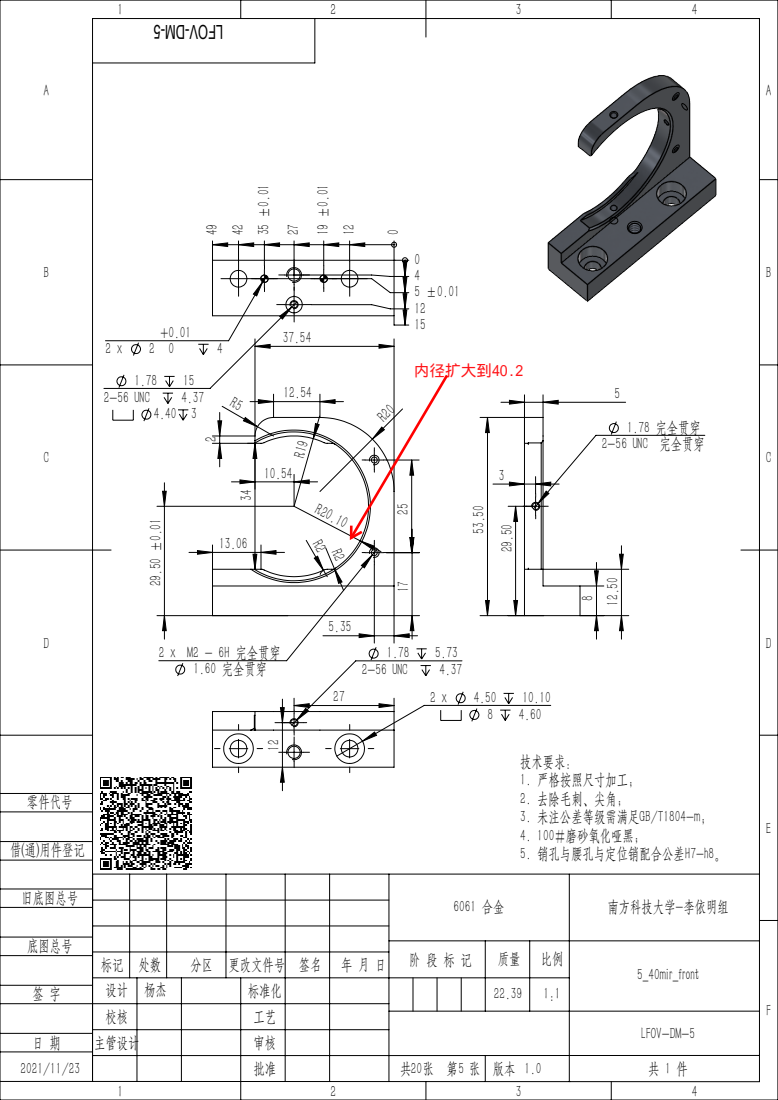
[picture p121: page 1]
2 x M2 - 6H 完全贯穿 1.60 完全贯穿; 2-56 UNC; 1. 严格按照尺寸加工； 2. 去除毛刺、尖角； 3. 未注公差等级需满足GB/T1804-m; 4. 100#磨砂氧化哑黑; 5. 销孔与腰孔与定位销配合公差H7-h8。

1.78 完全贯穿 2-56 UNC 完全贯穿

6061 合金 | 南方科技大学-李依明组

阶 段 标 记 | 质量 | 比例 | 5_40mir_front

标记 | 处数 | 分区 | 更改文件号 | 签名 | 年 月 日
设计 | 杨杰 | | 标准化 | | | | | | 22.39 | 1:1
校核 | | | 工艺
主管设计 | | | 审核

LFOV-DM-5

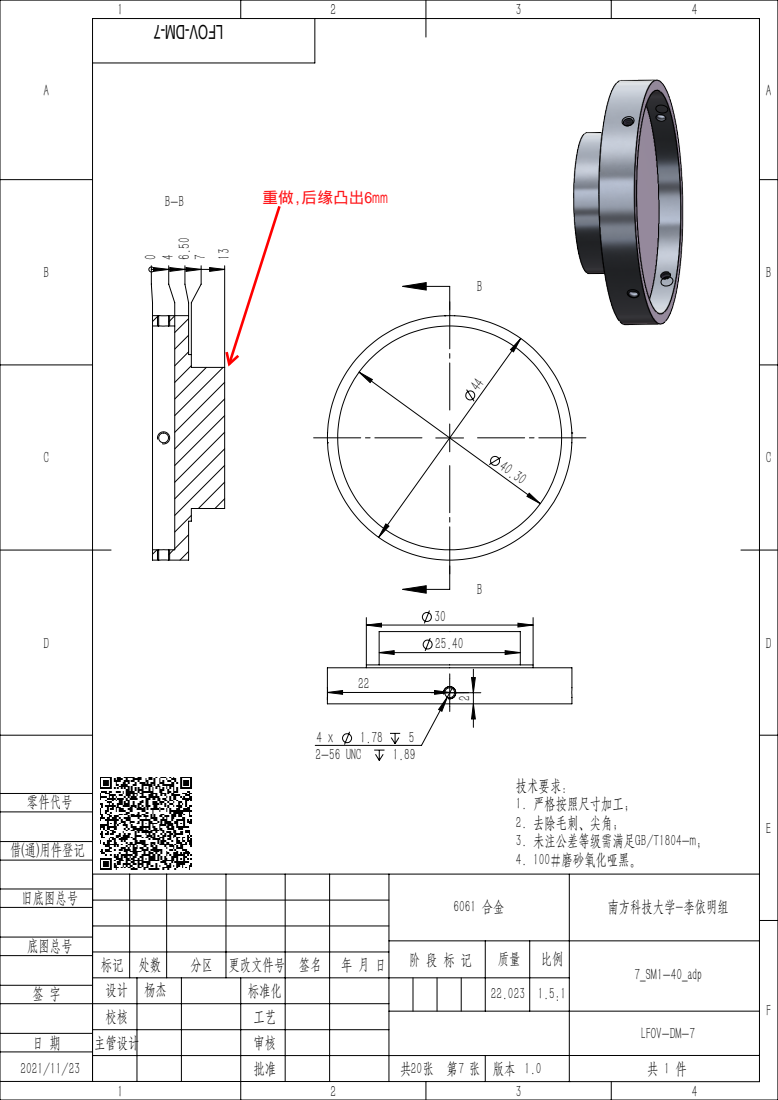
[picture p122: page 2]
2-56 UNC; 1. 严格按照尺寸加工； 2. 去除毛刺、尖角； 3. 未注公差等级需满足GB/T1804-m; 4. 100#磨砂氧化哑黑。

6061 合金 | 南方科技大学-李依明组

阶 段 标 记 | 质量 | 比例 | 7_SM1-40_adp

标记 | 处数 | 分区 | 更改文件号 | 签名 | 年 月 日
设计 | 杨杰 | | 标准化 | | | 22.023 | 1.5:1

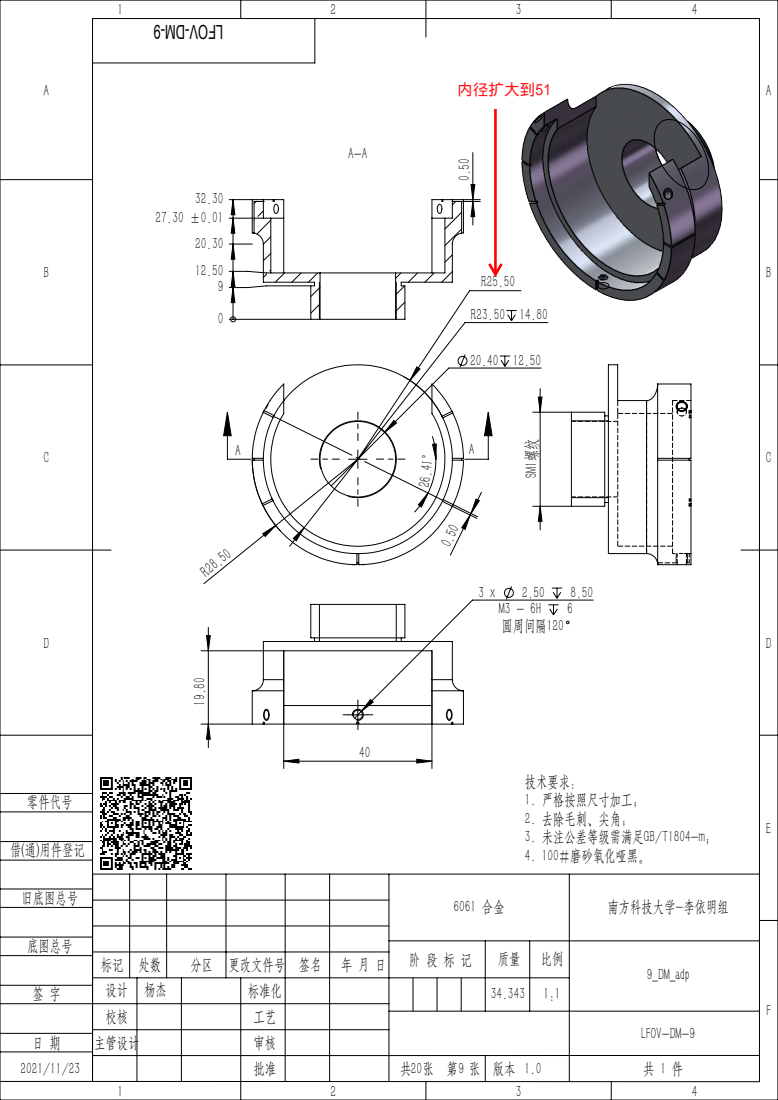
[picture p123: page 3]
圆周间隔120 SM1螺纹; 1. 严格按照尺寸加工； 2. 去除毛刺、尖角； 3. 未注公差等级需满足GB/T1804-m; 4. 100#磨砂氧化哑黑。

6061 合金 | 南方科技大学-李依明组

阶 段 标 记 | 质量 | 比例 | 9_DM_adp

标记 | 处数 | 分区 | 更改文件号 | 签名 | 年 月 日
设计 | 杨杰 | | 标准化 | | | 34.343 | 1:1

14X M6 - 6H 完全贯穿 5 完全贯穿; M6 - 6H 完全贯穿 5 完全贯穿; 6.60 完全贯穿 11 6.80; -154.48 467.50 M4 - 6H 完全贯穿; 3.30 完全贯穿; 1. 严格按照尺寸加工； 2. 去除毛刺、尖角； 3. 未注公差等级需满足GB/T1804-m; 4. 100#磨砂氧化哑黑; 5. 销孔与腰孔与定位销配合公差H7-h8; 6. 对于上表面折线槽，标注的点为中分线中点，刻线时依标注点坐标为中心运动，线宽2mm刻折线，深1mm； 7. 对于与折线槽相交的7个矩形槽，标注的点为矩形前表面的中心点，其前表面与折线槽轨迹中分线相交，线宽2mm，深1mm。

6061 合金 | 南方科技大学-李依明组

标记 | 处数 | 分区 | 更改文件号 | 签名 | 年 月 日
设计 | 杨杰 | | 标准化 | | | 1:2

阶 段 标 记 | 重量 | 比例 | 11_baseBoard

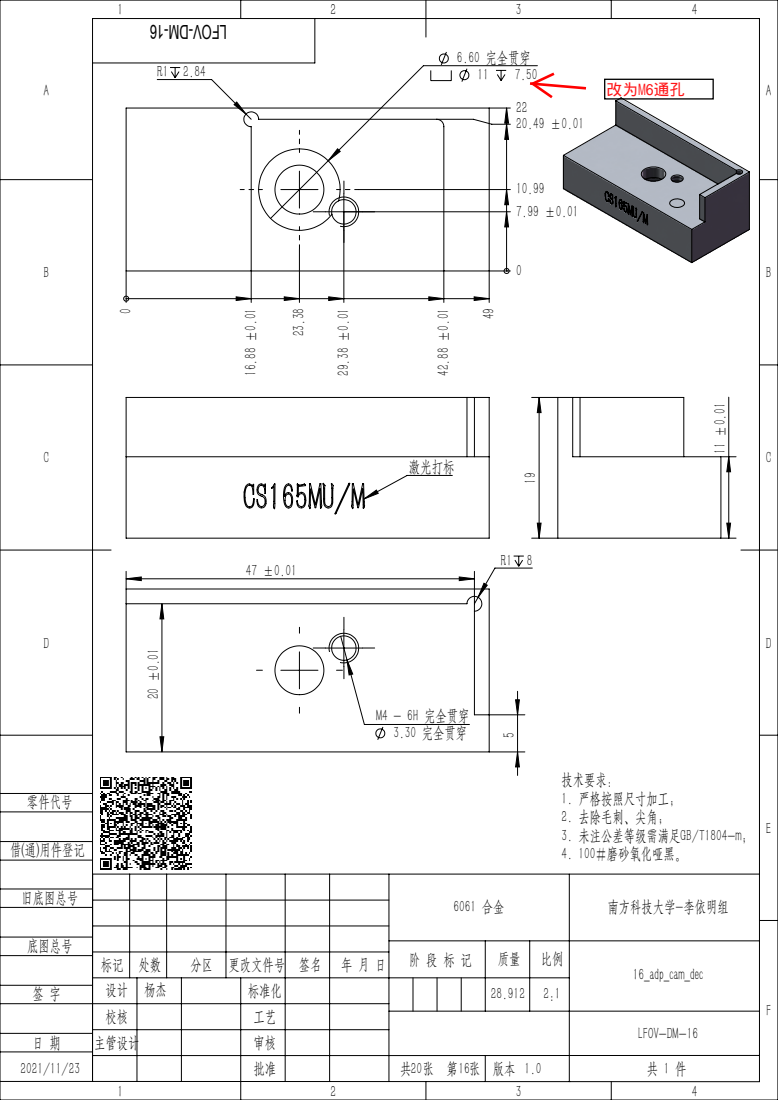
[picture p124: page 5]
6.60 完全贯穿; M4 - 6H 完全贯穿 3.30 完全贯穿; 1. 严格按照尺寸加工； 2. 去除毛刺、尖角； 3. 未注公差等级需满足GB/T1804-m; 4. 100#磨砂氧化哑黑。

6061 合金 | 南方科技大学-李依明组

阶 段 标 记 | 质量 | 比例 | 16_adp_cam_dec

标记 | 处数 | 分区 | 更改文件号 | 签名 | 年 月 日
设计 | 杨杰 | | 标准化 | | | 28.912 | 2:1

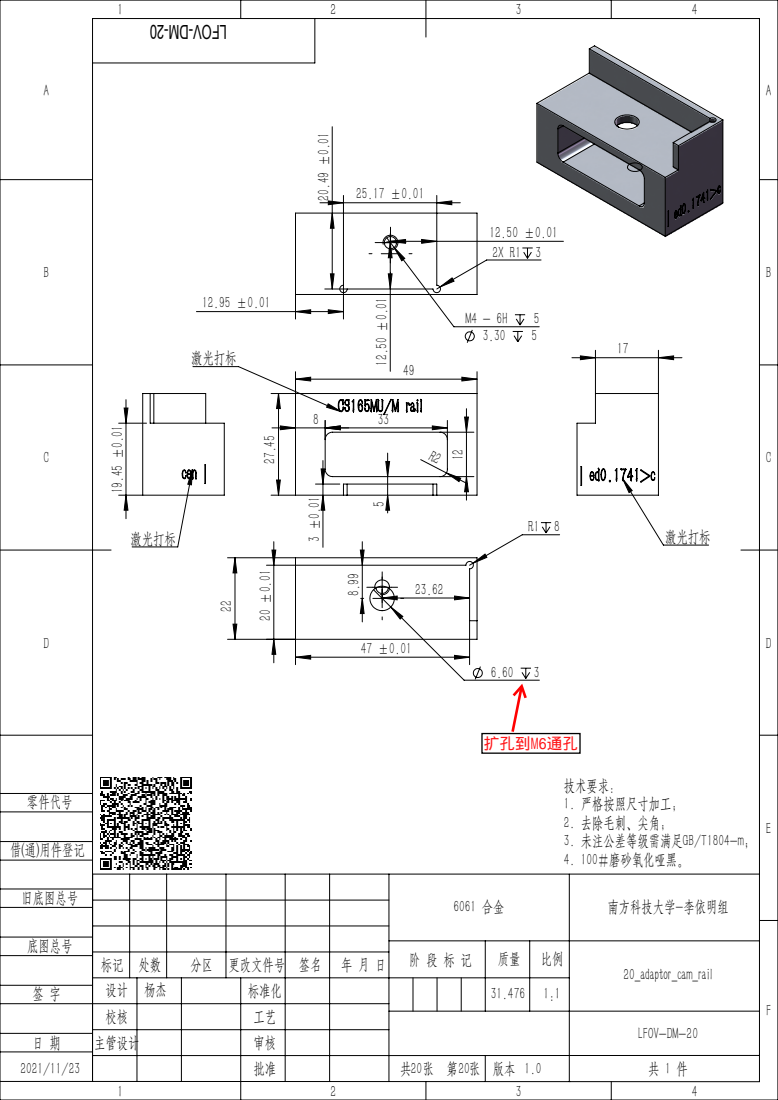
[picture p125: page 6]
1. 严格按照尺寸加工； 2. 去除毛刺、尖角； 3. 未注公差等级需满足GB/T1804-m; 4. 100#磨砂氧化哑黑。

6061 合金 | 南方科技大学-李依明组

阶 段 标 记 | 质量 | 比例 | 20_adaptor_cam_rail

标记 | 处数 | 分区 | 更改文件号 | 签名 | 年 月 日
设计 | 杨杰 | | 标准化 | | | 31.476 | 1:1
