Yangjie-SUSTC/Large_FOV_withDM/(commit log)

2021-11-11 This version send to factory in 2021/11/11
    [0_mir_thholasbs_PF10-03-P01.SLDPRT, 1-adaptor_N-BK7_fix_rai1l.SLDPRT, 1-adaptor_N-BK7_fix_rail.SLDPRT, 1-adaptor_fix_pinhole_cen_fix.SLDPRT, 1-adaptor_fix_pinhole_cen_fix_rail.SLDPRT, 1-rail_liner.SLDPRT, 10-adaptor_VRC_rail.SLDPRT, 10_pho_cam_hol.DWG]
2021-11-23 return to factory for pinhole
    [11_baseBoard.SLDDRW, 11_baseBoard.STEP, 13_DM_fix.DWG, 13_DM_fix.SLDDRW, 13_DM_fix.SLDPRT, 16_adp_cam_dec.DWG, 16_adp_cam_dec.SLDDRW, 16_adp_cam_dec.SLDPRT]
